hugen79/NanoVNA-H/doc/clone.jpg

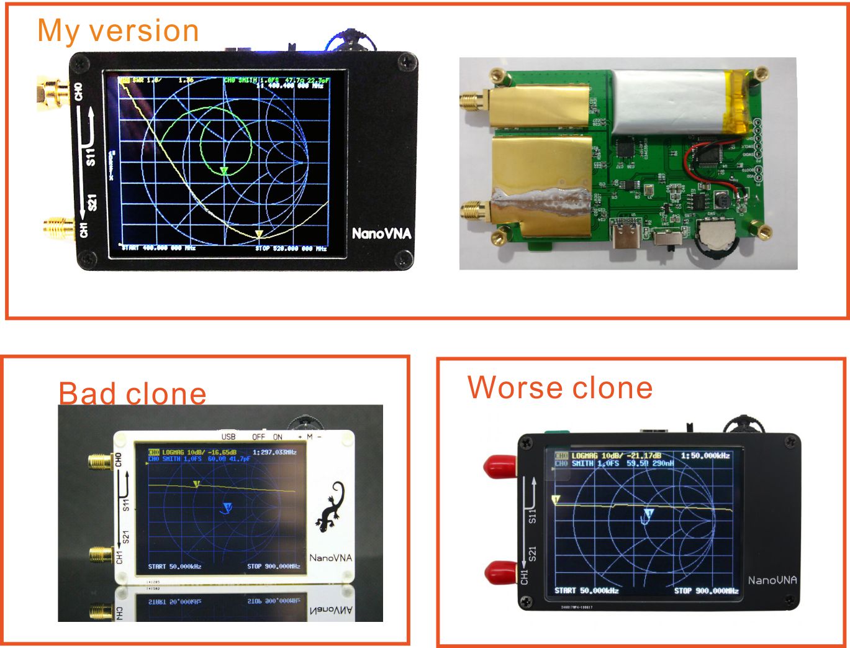
doc/clone.jpg
