hugen79/NanoVNA-H/doc/NanoVNA_Rev3.4_PCB.jpg

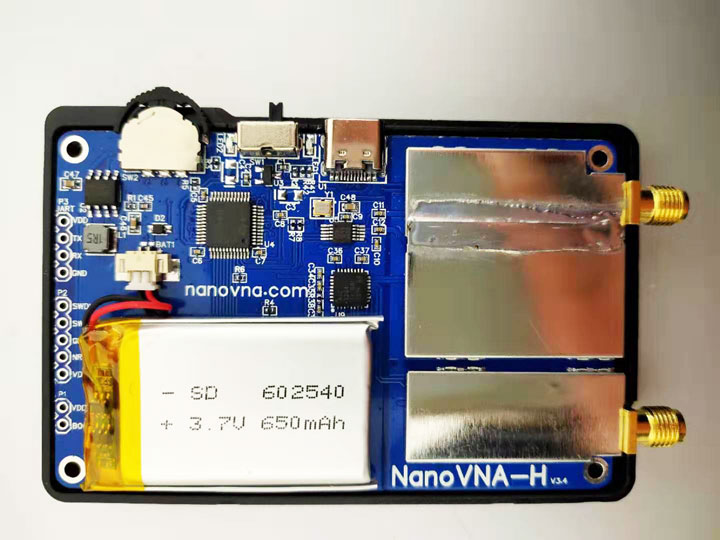
doc/NanoVNA_Rev3.4_PCB.jpg
