hugen79/NanoVNA-H/doc/Schematic_nanovna-H_REV3_4_1.png

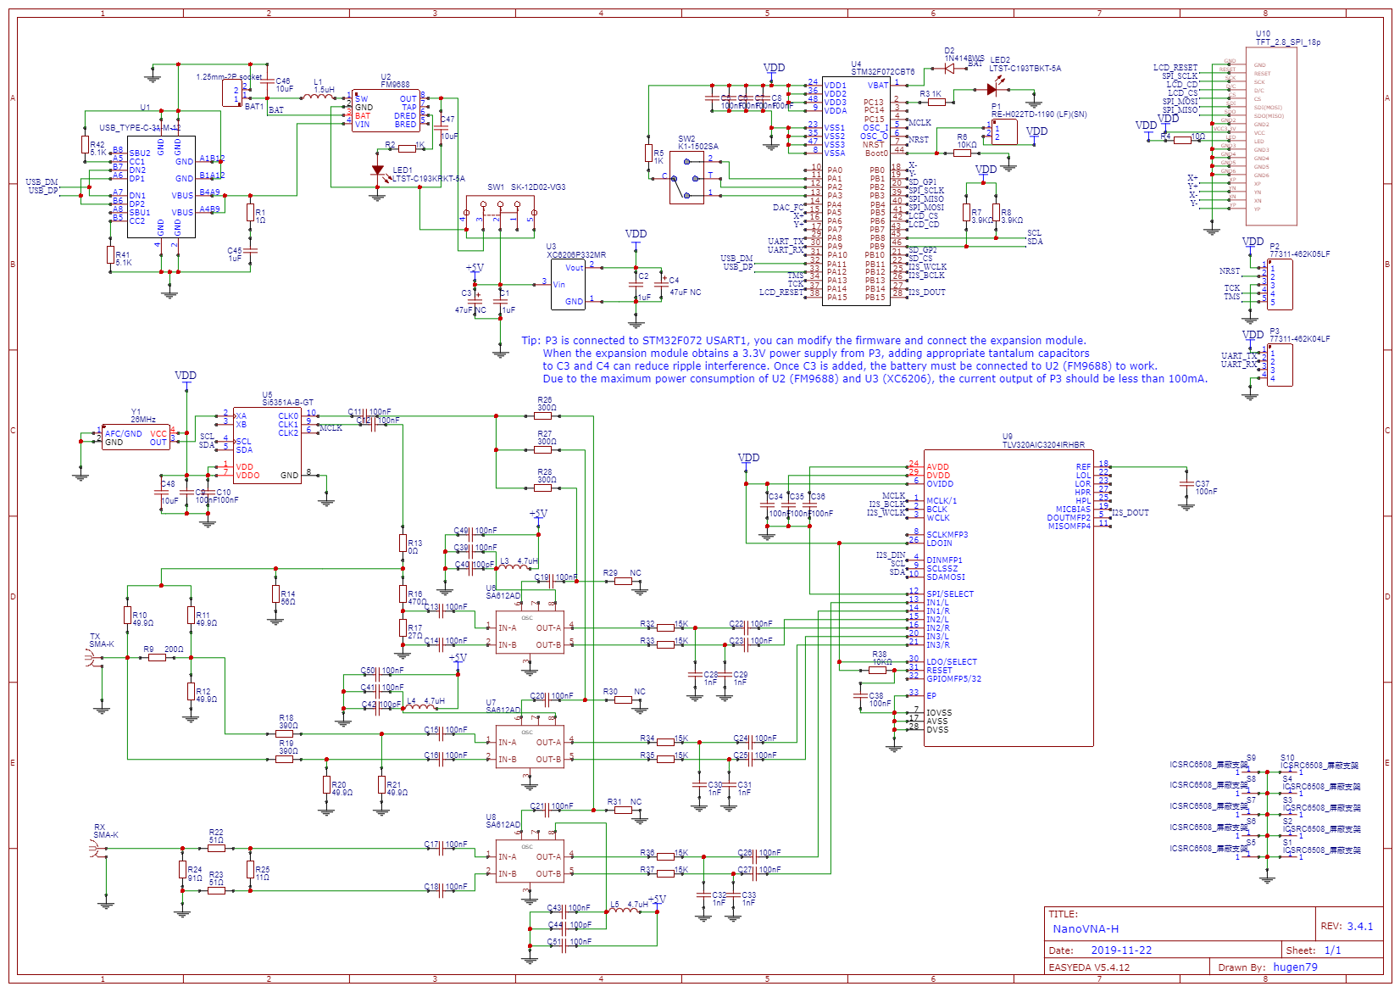
doc/Schematic_nanovna-H_REV3_4_1.png
