hugen79/NanoVNA-H/doc/Schematic_nanovna-H_Sheet-1_20190902.png

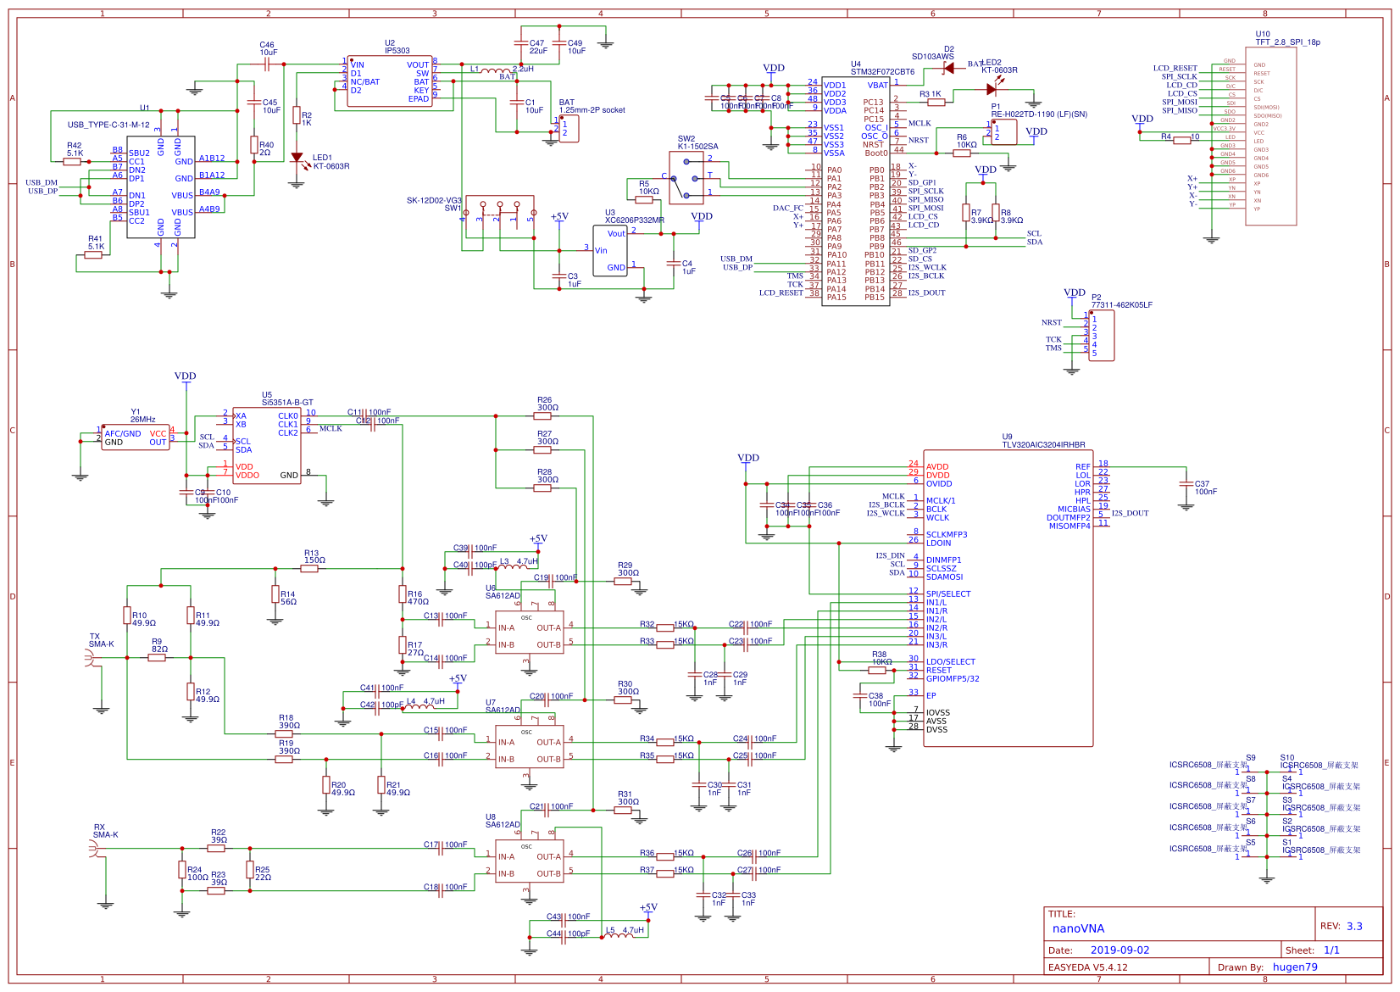
doc/Schematic_nanovna-H_Sheet-1_20190902.png
