hugen79/NanoVNA-H/(threads)

Thread 1 (2019-08-13):

Proposal: add suffix to your product name (eg. NanoVNA-H)

edy555, 2019-08-13:
Hi hugen,

I'm an original developer of NanoVNA.
When I knew that you made the clone of my project, I very surprised that you made PCB from schematics, and as an enthusiast, I felt pleased with your challenges such as frequency range expansion and your original pc software.

However, I was annoyed that you sell your clone without any prior notice to me. Though I had a plan to forge and sell my product, it becomes difficult.
Furthermore, your act cause that your design material was stolen by other clone makers, and quite many units were sold in aliex, ebay and also amazon. Those include worse clone as you say. This is a worrying state of affairs I think, and you might agree.

To distinguish any unexpected clones, I propose that you should change your product name by adding a suffix such as NanoVNA-H from your name, and it should be shown in the market and printed on your product.
And also I'd like to publish the name of qualified products, so customers become able to avoid worse clone.

I hope you think about this issue seriously.
Regards,

hugen79, 2019-08-16:
Dear Edy，

I am so glad to hear from you. First thanks for your approval and say sorry to make you annoyed.

At the beginging I made this NanoVNA just because I needed a portable device to measure filter and antenna. I tried to make PCB and achieved very satisfactory results. The performance of nanoVNA is very exciting, and your software is very excellent too. So I shared the production experience in 38hot. Some HAM contacted me to buy nanoVNA.  I made 50 sets of hardware for sale to HAM by hand all of the parts, and provided the schematic diagram and source code. After testing, they thought the nanoVNA was excellent and then I got more orders as I expected. At the same time, I found bad clones on eday. And their photos showed mixer problems on their machines. Apparently they didn't find the problems.  And some traders contacted me to buy NanoVNA for sale on eBay. I realized that it was no long a simple DIY and sharing.  It was being commercialized.  I tried to contact you through Twitter, but maybe because of my poor English expression, I didn't get a response. Soon, more and more clones appreared on the market. And seems someone cloned this NanoVNA misled ebay's sellers to promote their products. Things become out of my control as an enthusiast.

Maybe because I have stated your design concept every sites, maybe because I shared my experience and provide long term help as I can, or maybe because my products still have some advantages,  and thanks to the support of all HAMs, I can still get some more orders now.  And thank you most for not blaming me but giving me advice. I have added H in the name as NanoVNA-H and added a copyright declaration when open the VNA.  Hope your design will benefits more enthusiasts.

THANK YOU  & SORRY.

Sincerely,
Hugen

PS: Bec of my poor English, pls forgive me for my slowly response. I need sometime to translate and ask for help from my friends.

gabriel-tenma-white, 2019-09-29:
I'm pretty sure if you write Japanese hugen can understand it ;)

Closed 2019-09-29.

Thread 4 (2019-09-03):

Device is not recognized by host with Type-C to Type-C  cable.

cho45, 2019-09-03:
https://github.com/hugen79/NanoVNA-H/blob/master/doc/Schematic_nanovna_Sheet-1_20190711140429.jpg

Type-C CC1 seems unconnected to any pin. Does CC1 need to be connected to GND through a 5.1kΩ resistor?

hugen79, 2019-09-05:
Thank you for your feedback, I am aware of this error, the new version of the Schematic has fixed this issue.
https://github.com/hugen79/NanoVNA-H/blob/master/doc/Schematic_nanovna-H_Sheet-1_2019092.png

cho45, 2019-09-05:
Thank you fo repliyng! Great!

Closed 2019-09-05.

Thread 5 (2019-09-07):

Selector control acts flaky....

frohro, 2019-09-07:
I've read several reviews complaining about the same problem I have.  The issue is either that when you press one of the three selector switches, nothing happens.  I have to try over and over again.  It seems kind of like it depends on what the VNA is doing.  It is possible the selector hardware is flaky, but I suspect the software.  I'm kind of wondering if the software not monitoring the switch constantly.  Could it be made to trigger an interrupt, so button presses are not missed?

I haven't really looked into the source code yet, but it appears you made the change from touch screen to selector switch, so I thought I'd ask.  Any ideas?

Thanks,
Rob

frohro, 2019-09-09:
I polled some users on the groups.io list, and found another chap with two analyzers having the same issue, as well as this gentleman, whose blog review is [here](http://bobdavis321.blogspot.com/2019/08/nanovna-vector-network-analyzer-50khz.html).
It appears that the problem is that the switch is polled, not interrupt driven.  See ui.c, lines 121 and following.  Grepping the code yields interrupts for the ADC, and touch, but not the buttons.  There looks to be a pretty nice description of how to handle buttons with EXT I interrupts that fire when a button is pressed in ChibiOS with the STM32 [here](https://www.playembedded.org/blog/buttons-stm32/).

The interesting thing is the this polling is in eddy555's code as well, though he has no switch in his hardware.  I thought the switch was added so a non touch device could be used, but maybe not.

Thread 6 (2019-09-26):

tlv320aic3204 driver

qrp73, 2019-09-26:
Hi, I found there is a difference in the tlv320aic3204 driver in comparison with edy555 version:

Here is original edy555 code:
```
    I2CWrite(AIC3204_ADDR, 0x3b, 0); /* Unmute Left MICPGA, Gain selection of 32dB to make channel gain 0dB */
    I2CWrite(AIC3204_ADDR, 0x3c, 0); /* Unmute Right MICPGA, Gain selection of 32dB to make channel gain 0dB */
```

Here is your code:
```
    I2CWrite(AIC3204_ADDR, 0x3b, 5); /* Unmute Left MICPGA, Gain selection of 32dB to make channel gain 2.5dB */
    I2CWrite(AIC3204_ADDR, 0x3c, 5); /* Unmute Right MICPGA, Gain selection of 32dB to make channel gain 2.5dB */
```

Could you please explain what is the reason for this?
Thanks

hugen79, 2019-09-26:
This reduces some of the measurement range of positive gain, but results in better loss measurement dynamics.This is not necessarily suitable for all measurements, but it can be a little helpful for loss measurements.

hugen79, 2019-09-26:
This reduces some of the measurement range of positive gain, but results in better loss measurement dynamics.This is not necessarily suitable for all measurements, but it can be a little helpful for loss measurements.

Closed 2019-11-28.

Thread 7 (2019-10-03):

Bootup hangs after touchscreen calibration

nlroth, 2019-10-03:
After flashing ALL_FF to clear memory and then flashing NanoVNA-H__900_aa_20191003.dfu the device will boot every time with no issue.

I then calibrate touchscreen - not issues while device stays on.
If device is turned-off, device hangs at bootup every time only showing version screen.

Re-flashed hugen_900_(1500)_ch_sept-24-19.dfu - no issues with lockup.
Re-flashed NanoVNA-H__900_ch_20191003.dfu version - no problem.

Both 800 & 900 AA versions have same issue **BUT** 800 version boots up showing TDR time at bottom of display and produces unrecognized USB error on PC - DFU mode works though.

hugen79, 2019-10-09:
Thanks for the feedback, the bug has been corrected, please try the new version.

Closed 2019-10-09.

Thread 8 (2019-10-03):

Display update leaves larger font artifact in 'AA' version

nlroth, 2019-10-03:
(**Not a big issue**)
The CAL font (C0) at left side of display is not completely erased - old smaller font routine doesn't remove larger font completely.
Also, larger font extends beyond button slightly at right side for **Correction** and **Touch_test** menu buttons.
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

hugen79, 2019-10-09:
Thanks for the feedback, the bug has been corrected, please try the new version.

Closed 2019-10-09.

Thread 9 (2019-10-22):

Enhancement:  Shift AA FW vers freq fields to the left slightly

nlroth, 2019-10-22:
With reference to the AA version of the firmware, is it possible to shift the STOP and marker freq fields to the left enough to show the 0.1 KHz digit?

The change should not really interfere with the rest of the displayed info and it would allow more accurate 12.5KHz measurements at HF and VHF with the current ref xtal.

Thanks.

hugen79, 2019-11-16:
The marker freq may overlap with the marker data, especially when displaying smith data.

Thread 10 (2019-10-30):

Please share schematic V3.1

qrp73, 2019-10-30:
Could you please share schematic for PCB rev V3.1?
The schematic in the doc folder is V3.3, but my NanoVNA-H has PCB V3.1.
Thanks

hugen79, 2019-11-12:
Sorry, I have only checked the information about GitHub today because of the troublesome work I have recently. The schematics of V3.1 and V3.3 are the same, only R41 and R42 are missing. I am preparing to update the PCB to V3.4. If you wish, you can send your address to my email at hugen@outlook.com and I will send you the modified PCB. Thank you!

Closed 2019-11-28.

Thread 11 (2019-11-05):

Cross compiling on a Raspberry Pi...

dl9sec, 2019-11-05:
Hi,

i tried to cross compile the stuff on a Raspberry Pi 3. The toolchain mentioned at "Prepare ARM Cross Tools" can not be used on a RasPi.
But i found a precompiled toolchain for the Raspberry Pi at https://github.com/vanbwodonk/gcc-arm-embedded-build-armhf. This toolchain is more recent (8-2019-q3-update).
Differing from the description there, i used the following lines to install the toolchain:

wget https://github.com/vanbwodonk/gcc-arm-embedded-build-armhf/raw/master/pkg/gcc-arm-none-eabi-8-2019-q3-update-linux-armv7l.tar.bz2
tar -xvf gcc-arm-none-eabi-8-2019-q3-update-linux-armv7l.tar.bz2
sudo cp -r gcc-arm-none-eabi-8-2019-q3-update/* /usr/local/
sudo rm -r gcc-arm-none-eabi-8-2019-q3-update

Additionally i added the following line at the end of ~/.profile:

PATH=/usr/local/usr/local/arm-none-eabi/bin:$PATH

My first attempt fails to get the toolchain work on my Raspbian Stretch (Debian 9) because the toolchain needs glibc 2.28, but Stretch uses 2.24.
So Raspbian Stretch must be updated to Buster (see https://pimylifeup.com/upgrade-raspbian-stretch-to-raspbian-buster/) to get the toolchain work.

After upgrading Raspbian make runs well and the binary was built.

Hope this helps if someone want to cross compile on a RasPi...

Regards, Thorsten

JulyJim, 2019-11-19:
I have successfully run the current version "remotely " on Raspberry 3B, using Terminal Communication Framework (TCF)  plug-in on Eclipse.
I have used unmodified Makefile and no other complier / linker modification.

Since this seems to be ONLY place where developers gather I would like to ask here.If it is OK.

I like to add ability to output debugging messages to standard i/o console.
I do not have NanoVNA hardware and do not intend to actually run the software on it anyway.
 I just want to be able to trace / debug using prinff or cout.

**I should  be able to add required code to Makefile, but I am not sure how,**

I'll look into TCF debugging abilities for now.

JulyJim, 2019-11-20:
I am really reluctant to post this here.
I am finding out that there is NO forum / group dedicated to NanoVNA SOFTWARE development.
The "development" is scattered on each individual "enterpriser"    using whatever format / forum - if any.

I am of an opinion that nobody is really interested in NanoVNA as a common project.
Even this one is focused on fixing issues, which is fine.
What is really puzzling - the purpose of git(hub) is to share code.

How can I share code if I cannot physically test it ?
I have not found a way to run perfectly working NanoVNA code in debug mode.
I'll keep trying.

Thread 13 (2019-11-06):

Jog L & R switches appear to stop working after touchscreen menu use

nlroth, 2019-11-06:
I have found a problem with your Oct 9 4-trace release, where I use only the touchscreen and I select CONFIG and then the VERSION menu items and go back up the menu tree to select something else, then back to the version menu and then clear the menu from the screen.
Now, if I try to use the jog switch, I get the menu appear with ENTER but I can no longer get any menu items to highlight.
It appears the switches are being sensed because if I press Enter to bring up the root menu and then press the Right key 7 times, the menu disappears - but nothing was highlighted.
I tried the same menu sequence on QRP's 0.4.3 release and it is OK.
Thanks.
Larry

hugen79, 2019-11-12:
Let me test it first and it will be improved later.

nlroth, 2019-11-15:
The jog switches appear to have no issue with your latest release. The problem may have been due to an overflow somewhere. You can close

hugen79, 2019-11-17:
> The jog switches appear to have no issue with your latest release. The problem may have been due to an overflow somewhere. You can close

Trying to replace r5 with a 1k ohm resistor should improve.
hugen

Closed 2019-11-15.

Thread 14 (2019-11-11):

Noise improvements.

Pmax65, 2019-11-11:
I improved the noise adding few caps to the Silicon Labs clock generator chip and now the standalone instrument is fully working up to 1.5GHz with only a very little residual noise above 1.4GHz that it is appreciable in the Smith chart only.
I still have some issue with the PC communication because of the battery charger that disturbs the clock. I already thought a solution for this too, but I'm waiting for the sot23 P-MOSfet, to check if it works as thought. Once I fixed it I'll publish the "how to" of the whole hardware fixing.
In the meantime I have a couple of desiderata to your code.
1) the flashing LED 2 is very noisy and useless. It's much better to keep it off, if your intention was to give a pace indicator, I suggest you to implement it as a virtual indicator somewhere on the LCD screen (I currently removed its limiting resistor to keep it off).
2) Since there is still a little noise above 1.4GHz, It would be great if the calibration was done not by one acquisition of the raw data per calibration step as it is now. It should be better if you get more scans of the raw data and average them to get the correction coefficients averaged on more scans (say 10 scans, for example). This will take a little more time during the single calibration steps, but it  should warrant that the noise is corrected on its averaged value and not randomly on the instantaneous values acquired during the single scan.
Have a great day.
Massimo

qrp73, 2019-11-11:
regarding to LED 2, NanoVNA-Q disable it during sweep cycle to avoid noise: https://github.com/qrp73/NanoVNA-Q/releases

so, there is no need to desolder something. You can just change firmware.

Pmax65, 2019-11-11:
Not really so.
The clock generator's inner PLLs are always locked also during the non scanning time.
So the perturbation on the integrators of those PLLs still deteriorate their output phase noise during the scan time.

BTW, even if I seen that in the latest versions the LED 2 is apparently off during the scan, using a DSO on the limiting resistor pad, I always see some voltage spikes of few ms in duration there.

For these reasons I removed that resistor and the noise above 900MHz dropped a lot, despite I already downloaded the latest version of  NanoVNA-Q.

My current mods consist on:
1) added one 4.7F X7R capacitor in parallel to C9 and one other on C10
2) added one 68uF/6.3 tantalum capacitor in parallel to C9 and the 4.7uF already in parallel as above
3) added one 68uF/6.3 tantalum capacitor soldered on U3 input pin and grounded to the ground plane near Y1
4) removed R3

Doing the above, after a correct calibration, I get a Smith chart plot with just a little noisy plot of 2/3mm above 1.3GHz, making the instrument well usable in the HAM radio 23 cm band for antennas and filters checkings.
The SWR plot at 1.5GHz with the calibrated dummy load on the CH0 port shows 1:1.1 max 1:1.2 spikes, but below 1.3GHz is flat to 1:1
The return loss with the reference load used for the calibration, at 1.5GHz is better than -25dB on any board I checked, not that bad indeed
I did the test on 6 boards of three different versions, two having the ground clips and one having the nanoVNA-H board. And the results are almost the same.
Attaching the USB port, I still have noise above 900MHz, but I already checked that it is due to the battery charging. Detaching the battery positive wire and powering the VNA by the USB only, after a new calibration, the results are the same for the stand-alone running reported above.
For this reason I planned to put a P-MOSfet in series to the battery to detach the battery from the circuitry when the instrument is turned on and the power come from the USB port.
This way the battery charging will be still allowed when the instrument is turned off, but it's thought to remove that noise during the instrument is powered on. I just to check it when the MOSfets will be delivered.

Have a great day.

Massimo

qrp73, 2019-11-11:
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

No, it performs PLL reset at the beginning of sweep. So, any voltage fluctuations outside sweep time doesn't matter.

NanoVNA-Q has 10 ms stabilization delay after LED off, before it starts sweep.

Pmax65, 2019-11-11:
At this point I don't really know why I seen that sensible improvement after having removed R3.

Anyways, I'm sure that I also seen some glitches during the sweep. Let me return to home because now I'm in office and I can't check it one more time until I'll be back to home.

qrp73, 2019-11-11:
You're seen it, because used firmware which uses LED blinking during sweep. NanoVNA-Q firmware disable LED during sweep and don't blink until the end of sweep.

Pmax65, 2019-11-11:
No, I'm not sure that I seen it with V0.4.3 indeed, but I'm sure that I seen it with your V 0.4.2, and (if I'm not wrong) that function should have been already done.

One doubt:
what is your noise above 1.3GHz without any additional caps on the 5V & 3.3V power lines?
My doubt is that having increased the capacitance on the 3.3V U3 output, that could have introduced some sort of instability at the voltage regulator output after current pulses on it's input that lasts more than those 10ms.
I must check resoldering R3.
I'll tell you this night.

Pmax65, 2019-11-11:
Hi qrp73.
yes you are right and I was wrong I didn't realized that when the LED2 is on, there is  a PWM signal on it and having the horizontal scale of the DSO on 1ms/div I probably confused the ON state with OFF state of the LED2 when the PWM was there.
Here below you can see the 1.3GHz and 1.5GHz with the LED blinking.
(please note that I had to detach the battery + wire to get these plots from the nanoVNA Saver, because I still haven't received the MOSfets).
What do you think about the 10 time averaging suggestion during calibration?
It could better correct the scan above those 1.3GHz.

Thank you for sharing your work about this nice device.

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

hugen79, 2019-11-12:
Noise problems introduced by USB connection I will use the new power chip in NanoVNA-H V3.4 to improve this problem. I will try to increase the capacitance of the si5351 to reduce noise. The problem of LED flicker noise can be improved by software. If you prefer, you can send your address to my email at hugen@outlook.com and I will send you the modified PCB. Thank you!

Pmax65, 2019-11-12:
hi hugen79,
first off all, thank you for considering this issue, and for sharing you work on the nanoVNA-H board.

Since I had 6 nanoVNA on the table (only one was mine, the others were owned by friends of my local radio-club, I'm not a collector :-) of course), I believe I missed to update one and probably I did the check on that one, because I well remember how the noise dropped down after having removed R3.
Anyways, considering how much the instrument is sensitive to the power supply noise I would keep that LED off since in my opinion is useless, but this is just an opinion of course.
About the USB connection I already ordered the MOSFETs and I hope they'll come here soon (Italian Postal Service permitting). I planned to detach the battery when the USB power is applied and the instrument is turned on, it should take just 3 components comprising the MOSFET, not that complicated indeed. I probably mount the components on a very small piece of prototyping board and solder it in place of the battery connector.

Anyways your nanoVNA-H 3.4 PCB is surely well accepted, I 'm curious to know how it is handled the new power chip.

By the way, do you know from where it cames the R40, C45 and C46 network configuration?
I admit that I know very little about the electrical layer USB specs, but do you know what's the usefulness of the 2ohm resistor in series to the second 10uF capacitance?

I'll send you a direct e-mail for the 3.4 PCB.

Have a great day.

Massimo

hugen79, 2019-11-12:
The specifications of r40, c45, and c46 are from the data sheet of Ip5303. The series r40 and c45 are used to ensure the loop stability of ip5303. However, when an external USB power supply is connected, the MOSFET inside the ip5303 turns on and uses an external USB power supply, causing external interference to enter the power supply. For the new PCB, I will use the FM9688, a power chip widely used in Bluetooth headset chargers in China. The chip charging circuit and DC-DC circuit work independently, and the external circuit is simple and easy to install on the nanoVNA PCB. on.

Pmax65, 2019-11-12:
Hi hugen79,
thank you for the explanation, I seen that in the datasheet it was there, but (at least in the English version) I didn't find any explanation for it.

>However, when an external USB power supply is connected, the MOSFET inside the ip5303 turns on
>and uses an external USB power supply, causing external interference to enter the power supply.
I'm not sure the noise come from the USB line, I suppose is something due to the pulsed current into the battery during the charging process, because if you remove the battery and leave the USB power alone the noise is no longer there. For this reason I thought to put a MOSFET based switch between the battery and the Ip5303.
About the FM9688: I haven't found the english datasheet. I'm no way able to read the Chinese ideograms :-(
Have a great day.
Massimo

qrp73, 2019-11-12:
> causing external interference to enter the power supply.

According to my tests, this is not external interference. You can apply very clean external power (with no noise), but anyway it will be noisy. Also it is not related with cable, because there is no noise when usb cable is connected, but external voltage is not supplied.

I think the root of cause may be the following:
- IP5303 generate noise
- external voltage leads to a little different power supply voltage and it leads to some change in behavior

hugen79, 2019-11-12:
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

The difference in voltage will cause the gain of the sa612 to differ, resulting in errors. Maybe a separate charge pump can further reduce the noise, and I will do some tests.

Pmax65, 2019-11-12:
I perfectly agree with qrp73 when he wrote:

> According to my tests, this is not external interference. You can apply very clean external power (with no noise), but anyway it will be noisy. Also it is not related with cable, because there is no noise when usb cable is connected, but external voltage is not supplied.

In my opinion the problem is in the charging current pulses coming from the USB supply that produces inevitable little voltage spikes on the battery, since the voltage of the battery influence the calibration, in my opinion it's clear that those spikes are the cause of the performance deterioration.

I don't know if FM9688 will fix the issue, for doing that it should have two different switching mode PSU inside: one step-up for driving the load and one step-down for charging the battery; they should have very different PWM frequency to allow the step-up to be more reactive to the battery voltage changing caused by the lower frequency step-down charger.
In the datasheet, I see the schematic of the FM9688  and I don't see other than one inductor in that design, this lead me to think that it should not be much better than the Ip5303 under this context, but I could be wrong, of course.

Have a great day.

Massimo

hugen79, 2019-11-12:
I tried to replace the XC6206 with an ultra-low noise LDO RT9193, and I found that the noise has dropped. I will make a PCB test.
hugen

Pmax65, 2019-11-12:
> I tried to replace the XC6206 with an ultra-low noise LDO RT9193, and I found that the noise has dropped. I will make a PCB test.
Nice one. If it's confirmed the "thorn in the side" of the instrument is the clock generator, since the mixers are not powered from the 3.3V regulator.

hugen79, 2019-11-13:
> > I tried to replace the XC6206 with an ultra-low noise LDO RT9193, and I found that the noise has dropped. I will make a PCB test.
>
> Nice one. If it's confirmed the "thorn in the side" of the instrument is the clock generator, since the mixers are not powered from the 3.3V regulator.

Sorry, I made a mistake. Due to my wrong connection to the RT9193 pin, the actual output voltage of the LDO rises to 3.6V, and the performance improvement is due to the voltage rise. But this gave me a new idea to improve performance, I am making new attempts.

d51r3verse, 2019-11-13:
https://github.com/qrp73/NanoVNA-Q/issues/13#issuecomment-552679259
Mine(Green PCB) was around 6.5 MHz

hugen79, 2019-11-13:
> [qrp73/NanoVNA-Q#13 (comment)](https://github.com/qrp73/NanoVNA-Q/issues/13#issuecomment-552679259)
> Mine(Green PCB) was around 6.5 MHz

Thanks for your feedback, I will modify the schematic in v3.4.

Pmax65, 2019-11-13:
Hi hugen79,
> Sorry, I made a mistake. Due to my wrong connection to the RT9193 pin, the actual output voltage of the LDO rises to 3.6V, and the performance improvement is due to the voltage rise. But this gave me a new idea to improve performance, I am making new attempts.

Don't worry:
anyone who has never made a mistake has never tried anything new!
(Albert Einstein)

:-)

I would have here the mosfets and tell you if the patch works for the USB powering.
Anyways, as I have them here, I'll surely inform you about how the patch works.

For the 7.5/6.5Mhz peak issue:
I didn't noticed of it, but I must say that I have already added the 100nF on the mixer as per the NXP datasheet. Since I don't see anything there on any of the 3 different versions I have here, I can confirm you that it works fine.
I didn't reported that caps mod, just because I was convinced that they did nothing to the instrument, since I never looked to that narrow range before.
My compliment to Owen for having catched that issue. Here in Italy we say: "he catched the the needle in the haystack".

coralenka, 2019-11-13:
Hi
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

Pmax65, 2019-11-13:
Hi coralenka
Fantastic plots, how do you get them so noise-free up to 1.5GHz?

In the meantime, I just received the MOSFETs and checked the USB switcher and it works good, but above 1.3GHz as per the battery powered mode the noise is still there.

The mod consists of place on a small piece of proto-board (3 by 2 pads) an AO3401 P-channel MOSFET as follows:
DRAIN connected to the positive wire of the battery
SOURCE connected to the PCB positive battery pad
GATE connected to the ANODE of one 1N4148W diode and a 10kohm resistor (both on the little piece of proto-board).
The diode CATHODE is connected through a short wire to U3pin3, while the other pad of the 10kohm resistor is connected through a short wire to U2pin1.
Doing that circuitry, the battery charges only when the nanoVNA is not powered but the USB plug is connected to a current source.
When the nanoVNA is powered on, the battery is disconnected and the noise is as in the plots attached below.
Have a great day.

Massimo
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

coralenka, 2019-11-14:
HiI made no mod to my device yet

Trimis din Yahoo Mail pe Android

  Pe joi, nov. 14, 2019 la 0:45, Pmax65<notifications@github.com> a scris:
Hi coralenka
Fantastic plots, how do you get them so noise-free up to 1.5GHz?

In the meantime, I just received the MOSFETs and checked the USB switcher and it works good, but above 1.3GHz as per the battery powered mode the noise is still there.

The mod consists of place on a small piece of proto-board (3 by 2 pads) an AO3401 P-channel MOSFET as follows:
DRAIN connected to the positive wire of the battery
SOURCE connected to the PCB positive battery pad
GATE connected to the ANODE of one 1N4148W diode and a 10kohm resistor (both on the little piece of proto-board).
The diode CATHODE is connected through a short wire to U3pin3, while the other pad of the 10kohm resistor is connected through a short wire to U2pin1.
Doing that circuitry, the battery charges only when the nanoVNA is not powered but the USB plug is connected to a current source.
When the nanoVNA is powered on, the battery is disconnected and the noise is as in the plots attached below.
Have a great day.

Massimo

—
You are receiving this because you commented.
Reply to this email directly, view it on GitHub, or unsubscribe.

Pmax65, 2019-11-14:
> I made no mod to my device yet

Hi coralenka,
interesting.
Has your nanoVNA the battery installed?
I ask because when attached to the USB port, I experienced a great increase in noise bove 900MHz in all the 3 hardware versions I checked.
Your seems incredibly quiet even when attached to the PC.
Have a great day.
Massimo

coralenka, 2019-11-14:
Yes the battery is attached and at the same time the device is connected to the computer...I use the hardware version 0.4.0-273 de YO4AUL 

Trimis din Yahoo Mail pe Android

  Pe joi, nov. 14, 2019 la 15:14, Pmax65<notifications@github.com> a scris:

I made no mod to my device yet

Hi coralenka,
interesting.
Has your nanoVNA the battery installed?
I ask because when attached to the USB port, I experienced a great increase in noise bove 900MHz in all the 3 hardware versions I checked.
Your seems incredibly quiet even when attached to the PC.
Have a great day.
Massimo

—
You are receiving this because you commented.
Reply to this email directly, view it on GitHub, or unsubscribe.

Pmax65, 2019-11-14:
Hi coralenka,,
it's gorgeous.
Could you publish a photo of the nanoVNA?
Have a great day.
Massimo

coralenka, 2019-11-14:
This is my device

Trimis din Yahoo Mail pe Android

  Pe joi, nov. 14, 2019 la 20:12, Pmax65<notifications@github.com> a scris:
Hi coralenka,,
it's gorgeous.
Could you publish a photo of the nanoVNA?
Have a great day.
Massimo

—
You are receiving this because you commented.
Reply to this email directly, view it on GitHub, or unsubscribe.

Pmax65, 2019-11-14:
HI coralenka,
I'm not sure, did you send anything about how it looks your nanoVNA?
I can't see anything.

coralenka, 2019-11-15:
This is my device  

Trimis din Yahoo Mail pe Android

  Pe vin., nov. 15, 2019 la 1:02, Pmax65<notifications@github.com> a scris:
HI coralenka,
I'm not sure, did you send anything about how it looks your nanoVNA?
I can't see anything.

—
You are receiving this because you commented.
Reply to this email directly, view it on GitHub, or unsubscribe.

Pmax65, 2019-11-15:
It seems there is something wrong in the file handling because I can't see anything.
Could you send the photo to my e-mail?
My address is mporzio@teletu.it
I would like to know what HW it is, because I've some nanoVNAs from friends of my local radio club to modify and above 1.3GHz it seems really hard task to comply.
Thank you for considering my requests.
Have a nice day.
Massimo - IK1IZA

hugen79, 2019-11-15:
The new pcb seems to be better.
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

hugen79, 2019-11-15:
After the port is calibrated, the 20cm RG316 cable is measured, and it seems that 1.3GHz can work normally.
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

Pmax65, 2019-11-15:
Hi hugen79,
this is more or less what I got with the one I have at home and I think that it's a nice tool for HAM radio requirements.
How do you dealt with the USB charging noise?
Have a great day.

Massimo

Pmax65, 2019-11-16:
Hi hugen79,
maybe I've been not clear in my previous comment about your new pcb, I was referring to the noise of course.
About the accuracy and precision of the measurement, it seems that the older ones have a sort of resonance around 1180MHz that (despite the noise is quite low), it practically invalidate any useful Z measurement up there, but most of the HAM radio would use this instrument for antenna measurements which which have not such precision and accuracy requirements, so I guess it's good enough for them. In my case, who I own an HP8711A VNA (yes it was scalar, but some years ago I hacked it firmware to turn it into an HP8713A which is vectorial), I think this instrument is still a great deal for on field antenna or filters measurements.

You new PCB seems perform much better instead.
Have a great day.

Massimo

hugen79, 2019-11-16:
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

The pcb using the FM9688 seems to have a smaller usb noise, and a pcb with tantalum capacitors is being produced. I will test it further.、

hugen

Pmax65, 2019-11-16:
> The pcb using the FM9688 seems to have a smaller usb noise, and a pcb with tantalum capacitors is being produced. I will test it further.、

hugen

Nice one.

Pmax65, 2019-11-16:
HI coralenka,
I tried to reply to your email directly, but I received a deny alert from my mail server.
I was asking you a photo of the components side of your nanoVNA and (if possible, I don't want bore you) three photos of the instrument while it is measuring the open, short and load references.

Thank you for considering my requests.

Have a great day.

Massimo

d51r3verse, 2019-11-18:
Found another glitches around at CENTER 64 MHz / SPAN 80 MHz ( Not connected anything / Uncalibrated sweep )
Maybe influenced by 6.5 MHz issue?
But, this sweep does not glitches CH0 Delay.

hugen79, 2019-11-18:
> Found another glitches around at CENTER 64 MHz / SPAN 80 MHz ( Not connected anything / Uncalibrated sweep )
> Maybe influenced by 6.5 MHz issue?
> But, this sweep does not glitches CH0 Delay.

Is it appearing at 100MHz?

Pmax65, 2019-11-18:
Hi hugen79,
I finally gave a look to the reflectometric bridge section and found some weird things.
I refer to your schematic Rev. 3.0 which seems reflect the components mounted on the nanoVNAs I've here on my desk.
I can't understand the usefulness of R13. That resistor placed there almost completely invalidates the function of the reference mixer U6 because the changes at the input port of the bridge when the DUT has very different Z are practically no longer measured because of that.
I made R13 = 0ohm and now everything works great till 1500MHz.
Now, without that attenuation resistor, when an open reference is attached to the DUT port of the bridge, the U7 single ended input at pin IN-B exceeds the mixer 3rd order intercept point specs of -13dBm, but since that limit is determined by the conversion gain, it should not be a real issue since the differential input in that case is limited to -19dBm indeed.
I also changed R9 from 82ohm to 150ohm to better match the DUT port Z to 50ohm (it seems that the previous value didn't take account of the Si5351A-B-GT output impedance which is 85ohm).
I applied the mods only on one of the nanoVNAs that I've and not the measurements looks much better.
I also removed R29, R30 and R31 to give "a push" to the LO signal. I know that the SA612AD suggest to center the value between 200  and 300mVpp, but I suppose they do that to avoid spurious harmonics on the LO signal to drive the mixer, but we need that instead for the higher bands that use the odd harmonics method.
The attached images show the results with this configuration.
Note that the shield were not there because the nanoVNA arrived without it and I'm still waiting for the ground clips.
The mounted mixer are SA602A not SA612A, but that seems not critical.

Have a great day,

Massimo - IK1IZA

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

Pmax65, 2019-11-18:
After the mods described above, the corrective function of U6 now works, and it highlighted now a software issue at the band switch point of 300 and 900MHz. If the calibration has been made with a large span (for example at full 1.5GHz span) zooming around those points is evident that the calibration correction fails because interpolates between two point having very different correction coefficients (one below the band switch and one above it).
The right algorithm should extend the last calibrated point correction value below up to the band switch point, and should extend the first calibrated point correction value above down to the band switch point.
A much better algorithm should use the last two calibrated point correction values below and the first two calibrated points correction values above to compute the correction coefficients extending the linear interpolation between them to the two segments of data close to the band switch point that have no correction values computed (it should be an extension of the two interpolation lines).

Note that the glitch is already easily removed calibrating the instrument with the narrow span.

Have a great day.

Massimo IK1IZA

hugen79, 2019-11-19:
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

Thanks for your exploration, I conducted simulations and tests, and the results show that the new bridge is more reasonable. I will discuss the modification of the bridge with edy555. The discontinuity of the band switching point can be improved by modifying the codec's PGA.

hugen

qrp73, 2019-11-19:
> I can't understand the usefulness of R13.

R13 is needed to get 50 ohm output impedance on the port CH0. If you remove it, your CH0 output impedance will be changed and uncertainty of measurement will be increased.

Did you measured output impedace of port CH0? You can do it by measure output amplitude for different load resistance.

Pmax65, 2019-11-19:
> R13 is needed to get 50 ohm output impedance on the port CH0. If you remove it, your CH0 output impedance will be changed and uncertainty of measurement will be increased.

I simulated the front-end with Multisim 11 and now with R9 moved to 150ohm the device shows 50.3ohm at the DUT port of the bridge.
I also previously measured the CH0 Z with my HP8711A VNA and for that reason I decided to discuss the reliability of the front-end.
If U6 get the value there and not before R13, the bridge input impedance is not critical for the measurements.
The previous DUT impedance was set to 55ohm instead of the 49.6ohm probably expected. I suppose that probably the designer  did not accounted for the output impedance of the Si5351A-B-GT clock generator which is 85ohm not 0ohm (it's just a guess of course).
Now my HP8711A reported a dynamic CH0 Zin of 50.3ohm (the static impedance is higher of course but not pertinent to our context).
Now (up to 1.3GHz) the nanoVNA gave almost the same Smith plot of my HP8711A.
I can't measure the phase/amplitude above 1.3GHz using the HP8711A just because it stops at 1.3GHz, but I suspect that nanoVNA is not performing well up to 1.5GHz, because the ondulation of its return loss plot with the 30cm cable on CH0 port makes me think that there is a resonating element somewhere in the bridge circuitry that before this mod was at abt
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

Thread 16 (2019-11-18):

trace command hung

d51r3verse, 2019-11-18:
https://github.com/qrp73/NanoVNA-Q/issues/16
Same issue appeared latest(f6f948b) NanoVNA-H too.

I using empty `trace` command for identify current trace status and scale in my script.
But it will hung occasionally.
I found the only way to remove this issue, `trace x off` then `trace`. Similar issues on `marker` too.

Another issue I found was...
1. Set sweep range to full span 10e3 ~ 1.5e9 / calibrate off
2. `trace all off` -> `marker 1...4 off` -> `pause` (Blank screen / LED steady - For fast fetch)
3. Python loop `scan`&`data 0..1` -> Join&save s2p touchstone via scikit-rf
Exported every `data 0...1` and sp2 files was exactly same.

But data is different with `sweep`&`trace 0..1` enabled.( +4 ~ +20 dB point appeared at CH0 logmag )
NanoVNA requires at least one activated `trace`?

hugen79, 2019-11-18:
Do not use the "pause" command to pause the scan. You can use the "scan" command to pause the screen display and perform a single scan, then use the "data" command to get the data.

d51r3verse, 2019-11-18:
I issued single `pause` command at outside of the loop.
Inside the loop doing `scan` & `data 0...1`, Every iterated data array were different.

In device standalone mode( trace 0 logmag 0 enabled / live sweep ), CH0 logmag can not up to -21 dB.
But, I can see plus level of CH0 logmag when I turned all traces & markers( blank screen / manual scan via PC ).

Thread 17 (2019-11-18):

Just FYI C11 "problem" add -std=gnu11 to "makeflie" compiler options

JulyJim, 2019-11-18:
Current release, as of 11/18/2019,  has a same issue with C11 complier as NanoVNA did.
Instead of patching all problem occurrences - about 10 or so, I choose to follow "make" suggestion and added , cheap hack,

# Compiler options here.
# added -std=gnu11
ifeq ($(USE_OPT),)
  USE_OPT = -std=gnu11 -O2  -ggdb -fomit-frame-pointer -falign-functions=16 --specs=nano.specs -fstack-usage
endif

hugen79, 2019-12-03:
Thanks, I will modify it.

Closed 2021-12-11.

Thread 18 (2019-11-25):

SI5351 8mA out causes non-linearity in harmonics mode

erikkaashoek, 2019-11-25:
With 8mA the calibration looks perfect but when measuring a 25 ohm resistor there are some non-linearities. See this post
https://groups.io/g/nanovna-users/message/6595
Suggest to set 6mA maximum. (power 2)

Look for this post to see what performance is possible with your nanoVNA design (I bought from your shop)
https://groups.io/g/nanovna-users/message/6696
This was also done with power 2

hugen79, 2019-11-26:
Thank you erik, I couldn't reproduce what you said on my device and I will test it further. Increasing the output circuit of si5351 will reduce the impedance of ch0, which may reduce the measurement accuracy. The signal input to U6 is far beyond the Ip3 cut-off point of SA612A, which may cause some uncertain situations. I will continue testing.
hugen

erikkaashoek, 2019-11-26:
Hugen,

I redid my measurements. Calibrated with power 1. Then measured a 25 ohm resistor with powers 1,2 and 3 and there are subtle differences.
See these plots
http://athome.kaashoek.com/public/nanoVNA/power%201%2025%20ohm.PNG
http://athome.kaashoek.com/public/nanoVNA/power%202%2025%20ohm.PNG
http://athome.kaashoek.com/public/nanoVNA/power%203%2025%20ohm.PNG

The light blue line is R, it should stay at 25 ohm.
As you can see in the middle of the chart the impedance deviates more and more when the power increases.
its rotated back to eliminate the impact of the electrical length so it should stay at 25ohm. As the highest frequency is rotated to phase zero the electrical distance also changes
Its subtle but it is there and the measurement is best with power 1

erikkaashoek, 2019-11-26:
An even simpler way to see the non-linearities on my nanovna is to measure the uncalibrated SHORT
If the nanoVNA is lineair there should be no difference when measuring on power 1 or power 3 (except for the amount of noise) but there is difference (in my nanoVNA at least)

Pmax65, 2019-11-26:
Hi Erik,
I see the signals are very noisy in the that 500MHz...900MHz range.
Do you already have done the mods discussed in the link below?
https://github.com/hugen79/NanoVNA-H/issues/14

I use this board to to check the nanoVNA performances:
https://www.amazon.com/gp/product/B081391MJY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

After calibrating the nanoVNA with the on-board open, short and 50ohm load, the 33ohm and 75 ohm samples report respectively 33ohm +/-1ohm and 75ohm +/-2ohm.
On the Smith chart and the stimulus set in the range 10kHz-1.5GHz, the 33ohm is almost a perfect dot, while the 75ohm is a little line toward the capacitive area.

Currently, with those mods applied the only issue I see compared to my HP8711A are in the 900MHz-1.5GHz range with high impedance inductive loads where the the Smith chart reports a reduction of the impedance probably due to the input capacitance of the mixers.

Have a great day.

Massimo IK1IZA

erikkaashoek, 2019-11-26:
Did not modify my HW yet, too afraid I might destroy it.....
Most of the noise disappears when I run the nanoVNA from a clean 5 volt supply so I was not concerned about noise.

Pmax65, 2019-11-26:
Hi Erik,
It's not a question of the noise itself, that noise is there because the LO is underdriven at the harmonic range.
That's could be the reason of the non linearity of the measurement at the harmonic range.
Anyways removing R29, R30, R31, short-circuiting R13 and changing R9 to 200ohm the mixers are correctly driven and the reference input of the Weston bridge is monitored correctly for phase and amplitude.

Have a great day.

Massimo

erikkaashoek, 2019-11-26:
Will try to find some courage to do the modifications.

Pmax65, 2019-11-26:
Hi Erik,
if you never worked with 0402/0603 smt components take care of use a very small tip soldering iron and if you have any friend who already worked on them ask him to help you.
In case the nanoVNA start working crazy (such no longer scan or making very wrong measurements), don't worry to much for that. Most of cases you did a short-circuit on a component, just take a magnifier and search for that.
By the way, the power supply noise can be removed adding few capacitors as explained in that link above, and even the noise coming from the battery charging when the USB is attached to a charger or a PC can be removed using a mosfet, a resistor and a diode.

Have a great day.

Massimo

hugen79, 2019-11-27:
Hello erik, I found a similar phenomenon on the V3.3 version of the hardware. I will consider improving it. The test hardware of the V3.4 version performed well. You can refer to[ issues 14 ]
(https://github.com/hugen79/NanoVNA-H/issues/14)for modification. In addition, Maggie has contacted you and will send you v3.4 hardware next month.

v3.1 hardware test 25 ohm resistor
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

v3.3 hardware test 25 ohm resistor
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

v3.4 hardware test 25 ohm resistor
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

erikkaashoek, 2019-11-27:
Wow, Excellent improvement!!!!.  I will do experiments with the v3.4 above 1.5GHz because I want to measure some components above 2.0GHz
I have already first evidence it is possible to measure the S21 of a 2.0GHz cavity filter but my current nanoVNA HW (v3.1?) is unable to show the S11 as the bridge stops function above 1.2GHz, looks like the v3.4 is solving this problem.

erikkaashoek, 2019-11-27:
For evidence see this post
https://groups.io/g/nanovna-users/message/5149

qrp73, 2019-11-27:
what is the difference in v3.4? Is it possible to do that on v3.1?

hugen79, 2019-11-27:
> what is the difference in v3.4? Is it possible to do that on v3.1?

Hello qrp73, you can refer to [issues 14](https://github.com/hugen79/NanoVNA-H/issues/14) for some modifications, you can send your address to my email hugen@outlook.com, I will send you v3.4 PCB next month.
hugen

Pmax65, 2019-11-27:
hi Erik,

> I have already first evidence it is possible to measure the S21 of a 2.0GHz cavity filter but my current nanoVNA HW (v3.1?) is unable to show the S11 as the bridge stops function above 1.2GHz, looks like the v3.4 is solving this problem.

Wow, aren't you expecting too much from this device?
;-)
Those 10dB of S/N are not that useful for cavities tuning and I don't believe there is so much margins to get more from those "poor" SA612A mixers, we are already "raping them" :-)

Anyways, I already learnt that with this great device the motto "never say never" is a rule, and I'll look for any other enhancements about this your goal.

Massimo

Pmax65, 2019-11-27:
Hi Hugen.
once  you have ready the revision 3.4, I would like to buy one to test it.
Could I buy it directly from you?

Have a great day.

Massimo

hugen79, 2019-11-27:
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

Hello Pmax65, I already said in [issue 14](https://github.com/hugen79/NanoVNA-H/issues/14) that V3.4 hardware will be sent to you, so you don't need to repeat the purchase.

hugen

erikkaashoek, 2019-11-27:
In the evidence post you will see I got 45dB S/N in S21 at 2GHz with my v3.1 nanoVNA which is sufficient for the tuning.
For best results it is needed to have "some" S11 view.
See this post for what I tried previously with home build HW for a 2.5GHz cavity
https://erikkaashoek.blogspot.com/2019/02/tuning-25ghz-cavity-filter-with-home.html
seems the v3.4 is breaking the 1.2GHz limit for the SA612 bridge

Pmax65, 2019-11-27:
Hi Hugen,

> Hello Pmax65, I already said in issue 14 that V3.4 hardware will be sent to you, so you don't need to repeat the purchase.

Hoops, I missed that. I'm Italian and my English is not that good, I believed it was about the schematic only.
Thank you very much Hugen.

Massimo

Pmax65, 2019-11-27:
Hi Erik,

> In the evidence post you will see I got 45dB S/N in S21 at 2GHz with my v3.1 nanoVNA which is sufficient for the tuning.

I didn't see it before, but isn't  IAM-81008 a 5GHz double balanced mixer?
I think that SA612A is very less performing above 500MHz than the IAM-81008.
I was referring to this image from your post:
https://groups.io/g/nanovna-users/attachment/5149/0/2GHz%205V%20power%20amplifier.PNG
Anyways, you must know that when a friend from my HAM radio club proposed me to buy this device this summer, I was a little skeptic on the effectiveness up to the 900MHz, I really marveled to see what I got now up to 1500MHZ.

So, I'll wait for your news.

Have a great day

Massimo

erikkaashoek, 2019-11-27:
The image you refer to is from my v3.1 nanoVNA with some small firmware improvements measuring a 2GHz cavity filter, the measurement was made usable by using a 20dB amplifier AFTER the cavity filter and running the nanoVNA from a clean 5 volt supply. I understand the latter will no longer be needed with the v3.4 HW. And as noise also has been reduced considerably even the amplifier may no longer be needed.

Pmax65, 2019-11-28:
Hi Erik,
I can't warrant you that with rev. 3.4 the post-filter 20dB amplifier will no longer be needed. Since I never checked the modified nanoVNA at 2GHz but only up to 1.5GHz, I don't know the behaviour of the SA612A mixers up there.  Anyways, considering that the dynamic improvement at 1.5GHz for the CH1 port is in the range of 20/30dB depending on the pcb type, I think that it's possible that you can use the new release without that amplifier.

Have a great day.

Massimo

Thread 20 (2019-11-30):

CH1 port not pure 50 ohm

erikkaashoek, 2019-11-30:
The CH1 input impedance shows a substantial reactive part that hampers measuring certain components, mostly two port devices that are sensitive the the output impedance they see.
This is most obvious in the T-Check
Here you see the T-Check performed with only a coax, a Tee and an extra 50ohm resistor
http://athome.kaashoek.com/public/eevblog/NanoTeeCheck.JPG

When you put a 10dB attenuator at the input of CH1 and redo the full calibration and then do the T-Check you get this:
http://athome.kaashoek.com/public/nanoVNA/T-check.PNG
Much improved.
So having a well defined attenuator at the input of CH1 could give substantial improvements because it removes the reactive components of the impedance.

hugen79, 2019-12-02:
Thank you, erik. The input impedance of CH0 is not good. This issue edy555 has been discussed with me. It was also discussed in # 14. The previous circuit did not consider the impact of sa612's input impedance on the circuit. In addition, the line width from the resistance to the sma interface could not meet 50 ohms. I will try to improve it and it will be better in V3.4, but it is still not perfect.

hugen

erikkaashoek, 2019-12-02:
For very demanding measurements I calibrate S21 with a 10dB attenuator before CH1 input. That really helps but you get more noise of course. This is again solvable by adding a low noise 10dB amplifier between the attenuator and the CH1 input
Thanks for taking this into account!

erikkaashoek, 2019-12-02:
Are we talking about the same port? You refer to CH0. I'm talking about CH1

hugen79, 2019-12-02:
Sorry, the previous reply incorrectly, I said ch1.
hugen

hugen79, 2019-12-31:
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

Hi erik, I have re-simulated the impedance of the CH1 input and the attached test results are new. As the Chinese New Year is approaching, I cannot make a new PCB. I will update the modification and further test in the version after the Chinese New Year.

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

erikkaashoek, 2019-12-31:
That seems a substantial improvement! It will help a lot when measuring filters and impedance matching networks as filters can be very sensitive to the impedance connected to their output

PA3CCE, 2020-01-15:
I just ordered the NanoVNA-H4, the above means that the hardware probably is going to be updated again.
Is this change in components only or  in the PCB too, I'm afraid so.
Components I can change, I updated my 2.8" versions 3.2 and 3.3, to version 3.4 as far as possible. They improved and the display looks more or less like yours above, but more ondulated and the center of the smith chart is a small circle , changing the  PCB I can't !
If so I had better wait , now the H4 on his way !,
Jos

hugen79, 2020-01-19:
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

Hello Jos
Yes, I will accept the suggestions from the community to update NanoVNA-H. After the update, I will upload the schematic. You may need to change some resistors for better performance.

hugen

PA3CCE, 2020-01-22:
OK, thanks Hugen, in the mean time I received the NanoVNA-H4 , great device, it's loaded with Firmware dated 18//01/2020, here I do find this release only , but I know there is a H release dated  25/01/2020 is this one comparible with H4  or do I need H4 releaases only ?
Jos

PA3CCE, 2020-01-23:
Hugen
Sorry, I was wrong there is no 25/01/2029 release of the firmware, please neglect that.
I understand that in future there will be separate -H an -H4 releases, am I right ?
I hope that I can open the box of the H4 without damaging it, when a resistor change is needed !
Jos

PA3CCE, 2020-01-23:
another error please read 2020, Hi
Jos

hugen79, 2020-03-26:
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

Hello Jos, for nanoVNA-H4 we recommend that you update the firmware after 0.5.0, earlier versions can be problematic.

hugen

hugen79, 2020-03-26:
> That seems a substantial improvement! It will help a lot when measuring filters and impedance matching networks as filters can be very sensitive to the impedance connected to their output

I have uploaded a new schematic, and the impedance of ch1 is closer to pure 50 ohms.
https://github.com/hugen79/NanoVNA-H/blob/F303_ChibiOS_18/doc/Schematic_NanoVNA-H4_2_1.pdf

hugen

electrotoolshobby, 2020-05-18:
hi im new buy nanovna-h online i dont know if , -h product missmatching 50ohm resistance

with u'r last upload schematic have difrent between R34 TX , R49 thru R54 im need to change this to have beter matching sir ? after my vna come, thanks

hugen79, 2020-05-19:
> hi im new buy nanovna-h online i dont know if , -h product missmatching 50ohm resistance
>
> with u'r last upload schematic have difrent between R34 TX , R49 thru R54 im need to change this to have beter matching sir ? after my vna come, thanks

If you need to accurately measure the devices that are sensitive to the output load, you can refer to the latest circuit diagram modification.

Closed 2021-12-11.

Thread 21 (2019-12-01):

Memory indication in use

PY3IG, 2019-12-01:
When "save" is selected the memory in use is highlighted (after calibration for example).
Makes it easy to remember and save the calibrate in the correct memory.
Thanks for the work :)

hugen79, 2019-12-03:
Thank you, I will consider it.

Closed 2021-12-11.

Thread 23 (2020-01-15):

Predefined start/stop frequencies

mehale, 2020-01-15:
Please add an option to let the user define start/stop frequencies as memories.
This will be awesome for analyzing ham radio bands.

thanks for a great device!

hugen79, 2020-01-19:
You can use “Cal → SAVE” to save.

Closed 2020-01-19.

Thread 24 (2020-01-15):

Add option to unlock 1.5GHz till 2.1GHz range for those that know what they are doing

erikkaashoek, 2020-01-15:
As the performance of the v3.4 HW is so much better it makes sense to offer an option to unlock the 1.5GHz till 2.1GHz range.
The measurement  results above 1.5GHz have more noise but are usable.
I tested a 1.8GHz low pass filter and a 2GHz cavity filter. Both measured as they should but with some noise.
Could there be a menu option to unlock above 1.5GHz?

x893, 2020-06-12:
Hi,
can you help me with unlock (or link to how to) 1.5GHz ?
Thanks in advance

erikkaashoek, 2020-06-12:
The latest FW by DiSlord is unlocked. Look here: https://github.com/DiSlord/NanoVNA

x893, 2020-06-12:
Thanks, i will try.

x893, 2020-06-12:
DiSlord repo looks interesting but i can't found STM32F3 text,
I have NanoVNA-H4 (FW 0.5.0) with HW version 4.2.

Thread 25 (2020-01-22):

NanoVNA-H4 center frequency change above 1 GHz

hwalker6742, 2020-01-22:
hugen please see my review of the NanoVNA-H4 at https://groups.io/g/nanovna-users/message/10012 .  I encountered the lock-up when trying to set the center frequency in the 1 - 1.5 GHZ range.  Another member, https://groups.io/g/nanovna-users/message/10024 , also confirmed his NanoVNA-H4 locked up when setting the center frequency in the same range.

Multiple users have also encountered a QA problem, https://groups.io/g/nanovna-users/message/9914 , where the USB-C case opening is too small and the cable will not fit.  My unit was fine but a few members have had to enlarge the opening by hand.

- Herb

hwalker6742, 2020-01-23:
Additional feedback on the center frequency issue was provide in https://groups.io/g/nanovna-users/message/10088 .  Lock-up requiring power cycling occurred when setting center frequency above 1 GHz.  Lockup does not occur when setting start and stop frequencies.  Updating to the Jan 18, 2020 firmware did not resolve the issue.

- Herb

hugen79, 2020-01-24:
Thank you for your feedback, this is a serious problem, I haven't found the cause yet, I will look for the cause further.

hugen

Pmax65, 2020-01-24:
Hi Herb,

> Additional feedback on the center frequency issue was provide in https://groups.io/g/nanovna-users/message/10088 . Lock-up requiring power cycling occurred when setting center frequency above 1 GHz. Lockup does not occur when setting start and stop frequencies. Updating to the Jan 18, 2020 firmware did not resolve the issue.

I checked the HW3.4 and the H4 4.2 devices with the original FW and they work right.

I also tried "bad" settings like setting the center frequency to 1.5GHz and the device correctly switched to CW and after that I set the span to 200MHz and I got a correct 1.4GHz CF.
Anyways, I never had any lock-up.

Have you tried to clear the whole memory before downloading the update?

Massimo

BTW, Hugen I finally got the damned Eclipse IDE working on one PC but it is still not compiling on my home workshop main PC.
This is my first approach to the STM32 family indeed and I honestly never experienced a so complicated to setup tool in my professional experience (ok, it could be because I almost always used not free IDE with their own integrated compiler/debugger).
One curious behaviour is that even on the PC which performs the compiling task right, the real-time parser still report some undefined constants which remain undefined (just for the parser) despite they are well defined in the assembler list produced by the compiler.

hwalker6742, 2020-01-24:
Pmax,
I have not performed any updates (see attachment).  Two other users have provided feedback at groups.io of their NanoVNA-H4’s locking up when setting the center frequency above 1.5 GHz, so it is not just my unit.  So far you are the only person who has said they do not have this problem.  One user did update their NanoVNA-H4 but said that the center frequency lock up problem still remained.

One strange thing about my unit is that if I set the range for 10k – 1 GHz and select  center frequency. The default setting is 500 MHz as expected  (see attachment).  But if I set the range to 1 – 1.5 GHz and select center frequency.  The default setting is a negative number.

Setting the start and stop frequencies is fine.  It is only setting the center frequency that locks up the unit and requires cycling power.  The lock up also stops USB communications so I could not reset the unit via the CLI.

Windows10 x64, i7, 12GB
- Herb

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

Pmax65, 2020-01-25:
Hi Herb,
I apologize.
Since I was checking both the models, I believed to having performed that checks also on the H4 model. After you wrote the message above I decided to re-check the H4 (probably "check" instead of "recheck" indeed) and effectively there is the problem also after the last update.

Pmax65, 2020-02-02:
Hi Hugen,
despite I'm not able to avoid those errors from the Eclipse parser, I've been able to debug this issue.

There is a too small string buffer into the [ void draw_frequencies(void) ] function in Plot.c file
the string buffer buf() is only 24 characters long, while the code sequence:
        strcpy(buf, "CENTER ");
        frequency_string(buf+7, 24-7, fcenter);
        strcat(buf, "    ");
Writes these characters: 7 for the word CENTER + one space, 16 for the frequency in MHz when it's above or equal 1GHz and 4  for the ending spaces.

Summing them the buffer is filled with 27 characters + the \0 it occupies 28 bytes non 24 as reserved into the buffer definition.
Note that also all the other frequencies printing probably corrupt some memory location.

And more, it probably corrupt different memory from the 2.8" version, but this issue is present also there and it could be the reason that very sporadically I had some hangups of the instrument also in the 2.8" type.
Note that fixing this issue I never had the issues I reported here https://github.com/hugen79/NanoVNA-H/issues/27#issue-555908752
Maybe that this issue was the culprit of many sporadic bad behaviours of the two instruments.

I finally found one more issue:
there is a bug in computing the frequency when setting the center frequency with the span already set to 1.499GHz. If the center frequency is set with the sum of the center frequency + span/2 greater of 2.147GHz the computation fails and leaves the span as it was before. Anyways this is because a 32 bit signed integer can hold a maximum value of 2^31=2,147,483,648 and during the frequency0 and frequency1 computation, this limit it's overcome. You should adjust that function to avoid that.

Have a great day.

I look for your next update.

Massimo IK1IZA

Closed 2020-02-05.

Thread 27 (2020-01-28):

Touchscreen slowly responsive / unwanted menu popups

Pmax65, 2020-01-28:
Hi Hugen,
I experienced that while the nanoVNA touchscreen works great, the nanoVNA-H4 touchscreen is slow in detecting the touches, it needs to keep touching for at least half a second to get the touch detected.

I extended the delay between the driving ports setup and the adc differential input ports from 2 to 20ms and this issue has improved a lot now. Maybe this larger screen has an higher capacitance and need more time to stabilize its output to the right voltage.
The timings correction that I did are into the file "ui.c" function "static int touch_measure_x(void)" and function "static int touch_measure_y(void)" .

I also experienced sporadic unwanted menu popups and sometimes when that happens the sweep is suspended for some seconds, while in the meantime, the touchscreen is working anyways.
I suspect it's detecting some noise because of its wider area compared to the 2.8" touchscreen.

Could you publish the H4 schematic?
Possibly in graphic pdf format,
I tried to read the schematic in the doc directory, but opening that pdf file I can see only few components because of some missing fonts. The graphic pdf version should bypass that issue.

Have a great day.

Massimo

Pmax65, 2020-01-28:
Don't care of my pdf request in last message.
I discovered that loading that pdf through the browser, it converts it to the graphic version and now I can see it as a .png file.

Pmax65, 2020-02-03:
Hi Hugen,
I want to inform you that I finally discovered that this wasn't a firmware issue, but an hardware one.
My board had the LCD flat pcb badly fixed into the connector.
Evidently, sometimes the weston bridge worked wrong because of bad contacts.
For this, I close this issue

Closed 2020-02-03.

Thread 28 (2020-01-28):

Pressing right side of H4 causes random menu responses

hwalker6742, 2020-01-28:
I'm getting feedback from members at groups.io, and verified by myself, about the following issue:

   - If a menu is brought up and pressure is applied to the right side of the case, random menu choices occur.

A working solution has been proposed by one of the groups.io members at: https://groups.io/g/nanovna-users/message/10369 .

- Herb

hugen79, 2020-02-09:
I'm very sorry for this problem, and I will fix the plastic case as soon as the Chinese factory resumes normal work.

Closed 2021-12-11.

Thread 34 (2020-02-21):

NanoVNA-H4:  "scan" console cmd causes display to dim

hwalker6742, 2020-02-21:
Sending a scan console command (i.e. "scan 50000 30000000) to the NanoVNA-H4 causes the display to dim.  The display stays dim until a "resume" console command sent.  I'm pretty sure this interaction between the display and the scan command is unintentional.

This issue has been verified by other NanoVNA-H4 users at nanovna-users@groups.io.

- Herb

hugen79, 2020-02-26:
Yes, the display will be paused when using the scan command. At this time, it does not make sense to check the screen display trace. So I hope to reduce the screen brightness and save current consumption.

hugen

Closed 2020-02-26.

Thread 38 (2020-03-12):

Unexplained behaviour of calibration correction around high concentration of poles and zeros

Pmax65, 2020-03-12:
Hi Hugen.
I'm working about the odd harmonics loss of dynamic when a LPF filter let pass signal in the fundamental band below 300MHz and cuts in the odd harmonics bands above 300MHz.
I already designed a 5th order elliptic HP filter and modified one nanoVNA to clock the MPU and the DSP with a separate 8MHz oscillator as per your nanoVNA-H4 model, and used the CLK2 output of the Si5351A to drive the HP filter to get a cleaner signal with the fundamentals below the harmonics level when the DUT is checked above the 300MHz limit.
I modified the firmware to get the test signal that drives the DUT directly from CLK1 for frequencies below 300MHz and to get the test signal that drives the DUT from CLK2 passed through the filter for frequencies above.
Now the dynamic improved a lot making the device useful for duplexer testing/tuning.
Doing that I experienced an unexplained (for me) behavior of the calibration function of the S11 plot in the range between 150...350MHz.
Since for the moment I simply paralleled the filtered CLK2 output to CLK1 output, this last is influenced by the HP filter poles and zeros in that range (it's an elliptic filter and in the stop band it has abrupt changes in impedance there). I already planned to put an RF switch to remove this loading issue, but I would point out this issue anyways because it seems that the interpolated correction works bad.

**This is the uncorrected plot of that range:**
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
**While this is the plot of the same range when corrected by the interpolated calibration parameters:**
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
I did the 10kHz... 1.5GHz full span calibration and the marker in the plot are placed in the point of that full band calibration.
My question is:
how could the calibrated plot showing those almost parabolic interpolation between two consecutive calibration points?
I also can't explain why that red marker is so high, since this is a calibration point computed exactly with the very same dummy load used for the plot. Anyways, how could the S11 between two successive calibration points at lower RL have an higher RL?
This happens only when the DUT is well matched, in case of S11 close to 0dB this issue disappear little by little as the 0dB line is approached.

Do you have any idea about this?

Have a great day.

Massimo - IK1IZA

qrp73, 2020-03-13:
There is some "simplification" in si5351 frequency setup code, it leads to wrong frequency set at some frequency boundaries. Like 300 MHz, 600 MHz, etc. And your issue looks like that, but the errors are propagated due to multi-sweep in the NanoVNA-Saver.

It's hard to fix, because such fix requires complicated logic. But you can avoid it. Just don't use sweep through these frequency boundaries, if you can't, then setup a small frequency step, it will minimize amount of points with a wrong frequency.

DiSlord, 2020-03-13:
Its problem come from set si5351 power(in auto mode, power = -1), try set power 0 or 2 and calibrate on all diapasone, and check again.
Also need correct gain table

Pmax65, 2020-03-13:
Hi to both (qrp73 and DiSlord),
First of all, thank you for you race about this.
Maybe I've been not clear in last message, let me try to tell you what is happening in other words.
The two plot plots are the results of tests of the same DUT using the same nanoVNA, but while the first is with the correction disabled (not resetted) the second is with the correction enabled.
In few words, I can switch between them just using [CAL]>[CORRECTION].
Please keep in mind that the calibration was done from 10kHz to 1.5GHz so the real calibration points are placed with 15MHz spaces between them all the other points are the results of the interpolation of the 2 consecutive calibration points.
The 5th order elliptic high pass filter is connected as per the following schematic detail:
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
As you can see, while when the frequency is above 300MHz the signal exits from CLK2 passing through the filter and sees the load of CH1 which is almost a resistive load with a little parasitic capacitance, when the frequency is below 300MHz the signal exits from CLK1 and sees the filter output via FC3. The discontinuities seen in the top plot is due to the poles and zeros in that range of frequency (excluding the 300MHz discontinuity of course, which is due to the band change).
I can easily remove that discontinuity by an RF SPDT switch, but I can't imagine why the calibration algorithm introduces that artifacts  between the calibration points. Those almost parabolic correction shouldn't exist. Incredibly it seems that the correction works the other way it should work. In fact if I traced straight lines between those calibration points I have the real frequency response of the DUT S11 (except for the red calibration point which is completely wrong placed).
It seems to me that there could be a very bad bug in the calibration algorithm.

DiSlord, 2020-03-13:
Data on intepolation mode - use linear function see cal_interpolate(int s)
as write eddy https://github.com/ttrftech/NanoVNA/issues/73

DiSlord, 2020-03-16:
Problem come from here:
```
        // avoid glitch between freqs in different harmonics mode
        if (IS_HARMONIC_MODE(src->_frequencies[j]) != IS_HARMONIC_MODE(src->_frequencies[j+1])) {
          // assume f[j] < f[j+1]
          k1 = IS_HARMONIC_MODE(f) ? 1.0 : 0.0;
        }

        float k0 = 1.0 - k1;
        for (eterm = 0; eterm < 5; eterm++) {
          cal_data[eterm][i][0] = src->_cal_data[eterm][j][0] * k0 + src->_cal_data[eterm][j+1][0] * k1;
          cal_data[eterm][i][1] = src->_cal_data[eterm][j][1] * k0 + src->_cal_data[eterm][j+1][1] * k1;
        }
```
Linear interpolation in most cases work good, but then change calibration from one harmonic to other:
```
        // avoid glitch between freqs in different harmonics mode
        if (IS_HARMONIC_MODE(src->_frequencies[j]) != IS_HARMONIC_MODE(src->_frequencies[j+1])) {
          // assume f[j] < f[j+1]
          k1 = IS_HARMONIC_MODE(f) ? 1.0 : 0.0;
        }
```
Its non correct. Used last value from left or first from right (not do interpolation), need made extrapolate use 2 point before or 2 after
Also it not work on 900MHz (used IS_HARMONIC_MODE(f)), it only for 300, for 900 used point after

Pmax65, 2020-03-16:
Hi DisLord.
I already fixed this while I added the RF switch to the schematic.
I implemented a simple extrapolation algorithm computed on the two closest measured  calibration points, instead of the interpolation at the two edge of the band change point.
It works great at 300MHz, but the IS_HARMONIC _MODE macro is fails to detect the other band changes (the 900MHz) probably because it has been forgiven when the instrument has been extended above 900MHz.
This is my

Closed 2020-03-16.

Thread 39 (2020-03-16):

(Reopened) Unexplained behaviour of calibration correction around high concentration of poles and zeros

Pmax65, 2020-03-16:
This issue is intended to be appended to issue #38, that I closed for a mistake and I'm unable to reopen.

Hi DisLord.
I already fixed this while I added the RF switch to the schematic.
I implemented a simple extrapolation algorithm computed on the two closest measured  calibration points, instead of the interpolation at the two edge of the band change point.
It works great at 300MHz, but the IS_HARMONIC _MODE macro fails to detect the other band changes (the 900MHz) probably because it has been forgotten when the instrument has been extended above 900MHz.
Now I'm working and I'll fix it in the next days.

Anyways this is my the code for the moment that works  at 300MHz:

Place this in the define area for enabling this new interpolation/extrapolation algorithm:
`#define __NewBandChangeInterpolation__ 1`

Place this into static **void cal_interpolate(int s)**:
```

#if __NewBandChangeInterpolation__ == 1
          float k1 = (float)(f - src->_frequencies[j])
                          / (src->_frequencies[j+1] - src->_frequencies[j]);

          // avoid glitch between freqs in different harmonics mode
          if (IS_HARMONIC_MODE(src->_frequencies[j]) != IS_HARMONIC_MODE(src->_frequencies[j+1])) {
              int m;
        	  if (IS_HARMONIC_MODE(f)){
				  float k0 = 2 - k1;
				  k1 = k1 - 1;
				  for (eterm = 0; eterm < 5; eterm++) {
					cal_data[eterm][i][0] = src->_cal_data[eterm][j+1][0] * k0 + src->_cal_data[eterm][j+2][0] * k1;
					cal_data[eterm][i][1] = src->_cal_data[eterm][j+1][1] * k0 + src->_cal_data[eterm][j+2][1] * k1;
				  }
        	  }
        	  else{
				  float k0 = - k1;
				  k1 = k1 + 1;
				  if (j == 0){
					  m = j;
				  }
				  else{
					  m = j - 1;
				  }
				  for (eterm = 0; eterm < 5; eterm++) {
					cal_data[eterm][i][0] = src->_cal_data[eterm][m][0] * k0 + src->_cal_data[eterm][j][0] * k1;
					cal_data[eterm][i][1] = src->_cal_data[eterm][m][1] * k0 + src->_cal_data[eterm][j][1] * k1;
				  }
        	  }
          }
          else{
              float k0 = 1.0 - k1;
              for (eterm = 0; eterm < 5; eterm++) {
                cal_data[eterm][i][0] = src->_cal_data[eterm][j][0] * k0 + src->_cal_data[eterm][j+1][0] * k1;
                cal_data[eterm][i][1] = src->_cal_data[eterm][j][1] * k0 + src->_cal_data[eterm][j+1][1] * k1;
              }
          }

          break;

#else
          float k1 = (float)(f - src->_frequencies[j])
                          / (src->_frequencies[j+1] - src->_frequencies[j]);

          // avoid glitch between freqs in different harmonics mode
          if (IS_HARMONIC_MODE(src->_frequencies[j]) != IS_HARMONIC_MODE(src->_frequencies[j+1])) {
            // assume f[j] < f[j+1]
            k1 = IS_HARMONIC_MODE(f) ? 1.0 : 0.0;
          }

          float k0 = 1.0 - k1;
          for (eterm = 0; eterm < 5; eterm++) {
            cal_data[eterm][i][0] = src->_cal_data[eterm][j][0] * k0 + src->_cal_data[eterm][j+1][0] * k1;
            cal_data[eterm][i][1] = src->_cal_data[eterm][j][1] * k0 + src->_cal_data[eterm][j+1][1] * k1;
          }
          break;
#endif

```

instead of the current:

```
          float k1 = (float)(f - src->_frequencies[j])
                          / (src->_frequencies[j+1] - src->_frequencies[j]);

          // avoid glitch between freqs in different harmonics mode
          if (IS_HARMONIC_MODE(src->_frequencies[j]) != IS_HARMONIC_MODE(src->_frequencies[j+1])) {
            // assume f[j] < f[j+1]
            k1 = IS_HARMONIC_MODE(f) ? 1.0 : 0.0;
          }

          float k0 = 1.0 - k1;
          for (eterm = 0; eterm < 5; eterm++) {
            cal_data[eterm][i][0] = src->_cal_data[eterm][j][0] * k0 + src->_cal_data[eterm][j+1][0] * k1;
            cal_data[eterm][i][1] = src->_cal_data[eterm][j][1] * k0 + src->_cal_data[eterm][j+1][1] * k1;
          }
          break;

```
I don't know why, but I just realized that I have inadvertently close this issue.

Is there any way to reopen it?

Sorry

Massimo - IK1IZA

Pmax65, 2020-03-16:
Hi DisLord,
Ok,
to fix the glitches at the band change points do as follow.

Substitute the **IS_HARMONIC_MODE(f)** macro with the function
**int8_t IS_HARMONIC_MODE(uint32_t freq)** here below

```
int8_t IS_HARMONIC_MODE(uint32_t freq){
	if (freq > FREQ_HARMONICS * 5 ) {
		return 3;
	}
	else{
		if (freq > FREQ_HARMONICS * 3) {
			return 2;
		}
		else{
		  if (freq > FREQ_HARMONICS) {
			  return 1;
		  }
		  else{
			  return 0;
		  }
		}
	}
}
```
And change the code into  **static void cal_interpolate(int s)** this way:

```
#if __NewBandChangeInterpolation__ == 1
          float k1 = (float)(f - src->_frequencies[j])
                          / (src->_frequencies[j+1] - src->_frequencies[j]);

          // avoid glitch between freqs in different harmonics mode
          if (IS_HARMONIC_MODE(src->_frequencies[j]) != IS_HARMONIC_MODE(src->_frequencies[j+1])) {
              int m;
        	  if (IS_HARMONIC_MODE(f)==IS_HARMONIC_MODE(src->_frequencies[j+1])){
				  float k0 = 2 - k1;
				  k1 = k1 - 1;
				  for (eterm = 0; eterm < 5; eterm++) {
					cal_data[eterm][i][0] = src->_cal_data[eterm][j+1][0] * k0 + src->_cal_data[eterm][j+2][0] * k1;
					cal_data[eterm][i][1] = src->_cal_data[eterm][j+1][1] * k0 + src->_cal_data[eterm][j+2][1] * k1;
				  }
        	  }
        	  else{
				  float k0 = - k1;
				  k1 = k1 + 1;
				  if (j == 0){
					  m = j;
				  }
				  else{
					  m = j - 1;
				  }
				  for (eterm = 0; eterm < 5; eterm++) {
					cal_data[eterm][i][0] = src->_cal_data[eterm][m][0] * k0 + src->_cal_data[eterm][j][0] * k1;
					cal_data[eterm][i][1] = src->_cal_data[eterm][m][1] * k0 + src->_cal_data[eterm][j][1] * k1;
				  }
        	  }
          }
          else{
              float k0 = 1.0 - k1;
              for (eterm = 0; eterm < 5; eterm++) {
                cal_data[eterm][i][0] = src->_cal_data[eterm][j][0] * k0 + src->_cal_data[eterm][j+1][0] * k1;
                cal_data[eterm][i][1] = src->_cal_data[eterm][j][1] * k0 + src->_cal_data[eterm][j+1][1] * k1;
              }
          }

          break;

#else
          float k1 = (float)(f - src->_frequencies[j])
                          / (src->_frequencies[j+1] - src->_frequencies[j]);

          // avoid glitch between freqs in different harmonics mode
          if (IS_HARMONIC_MODE(src->_frequencies[j]) != IS_HARMONIC_MODE(src->_frequencies[j+1])) {
            // assume f[j] < f[j+1]
            k1 = IS_HARMONIC_MODE(f) ? 1.0 : 0.0;
          }

          float k0 = 1.0 - k1;
          for (eterm = 0; eterm < 5; eterm++) {
            cal_data[eterm][i][0] = src->_cal_data[eterm][j][0] * k0 + src->_cal_data[eterm][j+1][0] * k1;
            cal_data[eterm][i][1] = src->_cal_data[eterm][j][1] * k0 + src->_cal_data[eterm][j+1][1] * k1;
          }
          break;
#endif
```
Substantially the only line changed respect my previous message is this:
`if (IS_HARMONIC_MODE(f)){`

Which turned to:
`if (IS_HARMONIC_MODE(f)==IS_HARMONIC_MODE(src->_frequencies[j+1])){`

After that, the glitches at the band change points are fixed.

Have a great day,
Massimo - IK1IZA

Thread 40 (2020-03-22):

Hardware mods to get fixed the loss of dynamic of CH1 in the harmonics mode

Pmax65, 2020-03-22:
Hi Hugen,
here I publish my mods to almost completely fix the loss of dynamic above 300MHz when the DUT is a LPF tuned below but closed to 300MHz such as VHF/UHF duplexers.
The mods on my prototype still have a little loss of dynamic, but make the instrument useful.
Here are the  graph before and after the "cure".
**Before:**
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
**After:**
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

The red areas are the remaining dynamic losses.
Above 600MHz I never see any substantial dynamic loss.
The schematics are the followings.
**With added 8MHz oscillator for the MCU  & DSP:**
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
**With 2 RF switches:**
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
The two solutions are because it has been easier for me to use the inner output power amplifiers enable signal of the Si5351A instead to add an another RF switch (the size of nanoVNA have been a great constraint for fit the prototype PCBs there). This photo explains all:
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
Anyways, the single RF switch version gives the advantage of a stable clock to the MCU & DSP. This because the "arrhythmia" that I seen in the MCLK (that I was believing due to the noises around), it was instead due to the clock interruptions during the band switching. The only reason the system doesn't locks, it's that the inner PLLs of both the chips still produce a clock, even if on a very different frequency.
The contra of the single RF switch solution is that I had to modify the Si5351A settings to get the DUT test frequency from output 1 for frequencies below 300MHz and from output 2 for the frequencies above. This implies that the firmware is no longer compatible with the older hardware setup.
I used the scan LED2 signal (U4-2)  to drive the 5th order high pass elliptic filter, but my choice is due just because it was the easiest solution to get a sufficient wide pad to solder the switch(es) control wire in the nanoVNA PCB.
For the firmware development, the U4-2 signal must be set active at 3.3V for the odd harmonics mode and must be set deactive at 0V for the fundamental mode.

I also changed the  CH1 front-end configuration as follows:
	R22 = 68 ohm 0603 1% resistor
	R23 = 0ohm 0603 shunt
	R24 = 120ohm 0603 1% resistor
	R25 = 22ohm
Note that it has changed form differential to single ended, just because it was a nonsense. The driving signal of the SA612D mixer was in-phase on R25, so there was no advantages using that configuration. I found this configuration less noisy indeed and best matching the CH1 input port impedance for higher frequencies, that thanks to the higher value of R22 that is the one which influence more the capacitive behaviour of the CH1 input port trought the mixer input capacitance.

By the way, I found a strange stream of pulses on the LED2, which is produced by the macro PULSE into nanoVNA.h and used by function draw_cell() into plot.c.
I think it was some checking signal used during debug that I think it should be removed.

I thought to publish this mod procedure for those who desire to modify their current or the older versions of nanoVNA, but the complexity of it suggested me to avoid it. I had to use

Hope this will help you for your next production batch.

Have a great day.

Massimo

hugen79, 2020-03-26:
Hi Pmax65, thank you very much for your suggestion. This modification seems to be difficult to install 2.8 inch nanovna-H, but it can be very convenient to install NanoVNA-H4 with a larger PCB area. I will start my test.

hugen

hugen79, 2020-03-26:
For the impedance of CH1, it seems that it is affected by the parasitic capacitance on the PCB. After you change to single-ended, you reduce the length of the signal line and reduce the parasitic capacitance.  I modified it in nanoVNA-H 4 by reducing R24 and reducing the effect of parasitic capacitance of the circuit behind R22 and R23. In the next improvement I will try to increase the distance between the signal line and copper to reduce parasitic capacitance.
hugen

Pmax65, 2020-03-26:
Hi Hugen,
I don't agree with this:

> For the impedance of CH1, it seems that it is affected by the parasitic capacitance on the PCB. After you change to single-ended, you reduce the length of the signal line and reduce the parasitic capacitance.

Even if surely the parasitic capacitance of the PCB should matter above 1GHz, I did the mod placing a 0ohm resistor for R23, so the parasitic capacitance remained the same. What it changed is the greater pure resistive value of R22, which being in series to the input mixer capacitance reduced the influence of this input capacitance on the CH1 input.

So I believe that you should make that input single-ended not differential that has no advantage anyways.

Have a great day.
Massimo

Pmax65, 2020-03-26:
about:

> This modification seems to be difficult to install 2.8 inch nanovna-H, but it can be very convenient to install NanoVNA-H4 with a larger PCB area. I will start my test.

I agree, I don't know if moving U6 and its passive components forward the SMA border could free sufficient space for placing the filter and even one RF switch only.

hugen79, 2020-03-26:
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

Yes, single-ended allows an input pin to be directly grounded. The input capacitance of this pin is much larger than the parasitic capacitance. I will try your suggestion.
Also because the current ch0 output is as high as 0dBm, we have to add 35dB attenuation in ch1 to keep sa612a linear, perhaps we can use iAM81008 with a higher 1dB compression instead, but the IAM81008 output impedance is lower, I don't know how easy to connect to the codec with high input impedance, which requires further trying.

hugen

Pmax65, 2020-03-26:
I Hugen,
I didn't see any non linearity on the CH1, I used a 0-110dB 1dB/step attenuator and I honestly checked at 10dB/step and then I tried the first 10dB at 1dB without appreciable non-linearity.
I see a little non linearity at the end of the bands at around -30dBm return loss instead.
I don't see it below -40dBm (theoretical of course, just corrected by the calibration with that very same DUT)

I'm not sure you already read this:
https://github.com/hugen79/NanoVNA-H/issues/39#issuecomment-599795538

That's the way to fix the discontinuities at the band change due to wrong interpolation around those band change points. I implemented a very simple extrapolation algorithm that it works.

Have a great day.

Massimo

hugen79, 2020-03-26:
Hi Massimo, I'm very sorry, it may be that my bad English didn't express my meaning correctly. I mean, currently our resistance between the sma port of CH1 and the RF IN of the SA612A provides 35dB of attenuation. If IAM-81008 is used, the attenuation resistance can be reduced to 15dB or even 10dB, which may obtain better measurement dynamics.

hugen79, 2020-03-26:
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

Hi Massimo, I'm very sorry, it may be that my bad English didn't express my meaning correctly.
I mean, currently our resistance between the sma port of CH1 and the RF IN of the SA612A provides 35dB of attenuation. If IAM-81008 is used, the attenuation resistance can be reduced to 15dB or even 10dB, which may obtain better measurement dynamics.

hugen

Pmax65, 2020-03-26:
> Hi Massimo, I'm very sorry, it may be that my bad English didn't express my meaning correctly.
I mean, currently our resistance between the sma port of CH1 and the RF IN of the SA612A provides 35dB of attenuation. If IAM-81008 is used, the attenuation resistance can be reduced to 15dB or even 10dB, which may obtain better measurement dynamics.

I fully agree

Pmax65, 2020-06-01:
Hi Hugen,
since friends were interested in enhancing the dynamics above 300MHz when checking the low pass branch of a VHF/UHF duplexer, I finally designed a small 0.8mm thickness PCB for the filter mounting  on the 2.8 inches nanoVNA-H.
Here is a photo of the PCB.
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

While here is the PCB mounted on the nanoVNA board, as you can see it's a little less tricky to mount than the prototype.
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

This is the new schematic, which give much more dynamic than the previous 5th order high pass filter, and practically the current noise still in the 300...400MHz range is due to the background noise crosstalk between CH0 and CH1.
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

Here you can see the plots of the improvement. The red trace is the nanoVNA without any filter, while the green one is with the filter installed.
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

I also decided to redesign the filter as a 7th order elliptic filter to improve more the results and the plot
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

hugen79, 2020-06-02:
Hello Pmax65, it looks like your newly revised filter works very well.  But I don't quite understand the role of R1 you added. The 24 ohm resistor will increase the insertion loss by 2dB.

hugen

Pmax65, 2020-06-02:
Hi Huigen.
I placed that resistor to better match the filter output, and flatten the response in the 420-570MHz range which showed a 8dB flatness peak without it, anyways considering that the reference mixer picks the signal after it, it could be better to remove R1 indeed.
I'll give a try, maybe it could gain some dB of dynamic above 1GHz.

Thank you.

Massimo - IK1IZA

Pmax65, 2020-06-02:
Hi Hugen,
I checked it out and honestly I can't see any difference on the plots (up there those 2dB of dynamic improvement are probably hidden in the noise) and also the CH0 impedance is very little affected by that resistor.
So, apparently there is no reason to get that resistor there.
Have a great day.

Massimo

Pmax65, 2020-06-06:
Hi Hugen,
I think this is my very last try for this issue since now it looks really great.
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

I just changed the wire-wrap with the  SR-047 coax line because I noted a worsen of noise floor  above 1.2 GHz in the last version (it had reduced to about 45dB at around 1.3GHz)..
As you can see in the plot, other than returning the S21 dynamic of more than 50dB in the range 1-1.5GHz (not shown in the plot), thank to the coax lines the response improved a little more also in the 300-400MHz outperforming the HP8711A in that range now.
In my opinion this improvement demonstrates that in case you want to embed this filter in your next instrument you should take care of the microstriplines because above 1GHz their wrong Z0 could compromise the instrument response.

Have a great day.

Massimo

hugen79, 2020-06-09:
I modified the schematic and added a high-pass filter, which should be the method with the lowest cost and least current consumption to improve the performance of the UHF band.
But I am not sure if I will mass-produce the nanoVNA of the new circuit. Some users who need higher frequency applications are turning to SAA2. However, the traditional architecture of nanoVNA has faster speed and less current consumption. It should still have many hobbies need them.  I am also trying to add an independent signal source for the 300-900M measurement, so that up to 900MHz has always been used for fundamental wave measurement, effectively improving the dynamics.   If there is new progress, I will also release it in time.

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

Pmax65, 2020-06-09:
Hi Hugen,
it looks the you are doing great.
I agree with you that you must follow you business needs.
I just published the results to let you know that this way the dynamic is quiet good for this kind of instrument.

Have nice days.

Massimo

Pmax65, 2020-06-10:
Hi Hugen,
just to inform you about that.
I simulated your high pass filter setup and despite above 300MHz it is more flat than mine, it attenuates at least -40dB in the stop band while mine attenuates at least -70dB.
I can't warrant you about the result on the S21 dynamic.
I know that the switches have far less insulation between the ports, but they are two in series so that  -70dB @ 1.5GHz are realistic indeed.

Have a nice day.

Massimo

Thread 41 (2020-05-04):

Time Domain does not let me set the start/stop intervals

ewheelerinc, 2020-05-04:
Hello,

Thank you for maintaining the software of this great device!

We have been trying to test cable lengths to calculate velocity factor of an unknown cable. When we set the VNA to 50kHz--900MHz and set CH0 to real mode with a transform of low-pass impulse, I am unable to set the start and stop ranges to zoom into the first 20--50ns to see where the minima is for the reflection. If I set the stop frequency while the transform is turned on, the nanosecond range changes expectantly. If I set the stop frequency to 51kHz it sets the upper range to 65535ns, if I set it to 55kHz it sets it to 16087ns.

I tried this example a second time and got different numbers. The second time I did this the cursor position in the top-right corner shows "1:2147483647Gs 21474". This looks like the base-10 value of a 32-bit signed value of "-1" so maybe something in the code is returning an error that is not being handled. 65535 as noted above could be a similar issue since it is -1 in a 16-bit signed short.

I have seen this problem whether or not I calibrate the device and with and without load/short/open screw-caps on CH1 to mute any noise.

What I would really like to do is zoom into where the cursor is, so a zoom feature would be great. In the absence of the zoom feature, being able to set the time domain graph range in ns would be fine as well.

I am new to the VNA so if this is normal behavior and I am missing something then please let me know what I can do and if you need any more information.

ewheelerinc, 2020-05-07:
I may have been running old firmware.  I upgraded to v7.1 from edy555 and I've not seen the problem.  Not sure about the latest -H build, however.

Closed 2020-05-07.

Thread 42 (2020-06-01):

Reference impedance setting

goscickiw, 2020-06-01:
Sometimes I need to measure a 75 ohm system, but 75 ohms shows as 50 ohms on the graphs when I calibrate using a 75 ohm load. Would it be possible to add a setting for impedance in the software, so I can match it to the resistance I use when calibrating?

I understand that anything other than 50 ohms is most likely not optimal for the NanoVNA's hardware, and that it would be batter to use something like impedance converters, but right now I don't need anything too precise and I haven't encountered any big discrepancies when measuring in 75 ohm, other than the displayed values being 2/3 of the actual value.

There could also be a warning when changing the impedance value, that it could make the results less accurate.

hugen79, 2020-06-03:
In order to obtain good results, you need to modify the reflection bridge, then modify the software, and finally use a 75 ohm load for calibration.

goscickiw, 2020-06-03:
Yes, I know this, I mentioned that previously. If calibrating the whole system to 75 ohms is causing an issue that I haven't noticed yet, maybe the software impedance value could only affect the SWR (1:1 at 75 ohms) and Smith chart (center at 75 ohms) while the calibration is still to 50 ohms?

Also, how exactly would the reflection bridge have to be changed to accept both 50 and 75 ohm calibration?

Pmax65, 2020-06-03:
Hi goscickiw,
> Yes, I know this, I mentioned that previously. If calibrating the whole system to 75 ohms is causing an issue that I haven't noticed yet, maybe the software impedance value could only affect the SWR (1:1 at 75 ohms) and Smith chart (center at 75 ohms) while the calibration is still to 50 ohms?

No, is not only that, in case you don't apply a 50/75ohm adapter on CH0 during the calibration and the measurements, you get a flatness in the measurements that for the impedance offset could be up to 3.5dB in the return loss measures.
Note that there is no need to rebuild the whole Weston bridge to get a right measurements, it suffice a 50/75ohms minimum loss pad between the CH0 port and the DUT.

The only side effect is that the adapter reduces a little the dynamic of the measurements, but for RL shouldn't be a tragedy at all.

Have a nice day.

Massimo - IK1IZA

goscickiw, 2020-06-03:
Even with 50 ohm calibration and a converter, the 75 ohms (in system) will be displayed as 50 ohms (what the VNA sees at the converter), and 1:1 SWR and the center of the Smith chart will still be 50+0j ohms. I would like to be able to set 75 ohms as Z_0, only visually for proper values on the graphs.

So the 5.7 dB loss on the converter's resistors won't be a big issue? Currently I have some TP-75 transformers which have low loss but they only work properly up to 200 MHz, and I heard their inductive nature can affect the measurement.

Pmax65, 2020-06-03:
Hi goscickiw,
yes, if you place a minimum loss pad you get right measurements at cost of the reduced dynamic of the port. This is because it is a pure resistive (non-reactive) device in the useful range of frequency  for which it is designed, so the calibration can easily embed its behaviour.
In that case you need to change the SW for center the Smith chart at Z0=75ohm of course.
I never tried the Macom TP-75 transformers for this scope, but my guess is that its reactance along the frequency range could be not fully predicted and for that I suppose that the calibration shouldn't be effective in this case.
Please, take care that this last is just an opinion of mine, I never checked it out.

Massimo - IK1IZA

Pmax65, 2020-06-03:
By the way (this is just a provocation of course).
Hugen could design and sold cheap SMA male to BNC female minimum loss pads for the nanoVNA.

They are just one 43.3ohm resistor in series to BNC hot terminal and an 86.6ohm resistor in parallel to the SMA male connector   ;-)

Thread 43 (2020-06-07):

No way to save settings

Axel2, 2020-06-07:
Hi,

in release NanoVNA-H_AA_20200118.dfu there seems to be no way to SAVE the settings. There is only a button for recall.

Kind regards,
Axel

hugen79, 2020-06-07:
Please use the calibration save

Closed 2020-06-07.

Thread 46 (2020-07-27):

NanoVNA bricked after installing latest update

SheetLightning, 2020-07-27:
First time every updating the firmware on this. I checked I had the -H version and the firmware version message pointed me to this GitHub. Unfortunately my NanoVNA booted to a white screen after installing the latest update: NanoVNA-H4_20200221.bin

Mine is the -H version and I am updating from a PC running Linux Mint 19.2 so I used the instructions from here:

https://nt7s.com/2019/11/updating-the-nanovna-firmware/

Also here:

https://oristopo.github.io/nVhelp/

Used the following command line:

dfu-util -d 0483:df11 -a 0 -s 0x08000000:leave -D NanoVNA-H4_20200221.bin

My screen came up white and nothing else happened. I have tried bridging the link to get into DFU mode but the screen remained white.

After a bit of a panic moment I tried uploading the firmware again anyway and to my surprise it worked in the background - it was just that the display was not telling me the NanoVNA was in DFU mode. Uploading again got the a white screen again, so I tried the ch.dfu from edy55. This uploaded and worked OK, except my SWR readings were not right (yes I did calibrate).

After a bit of further digging, I noticed that in the previous version of your firmware (18th January) there is an version with an AA suffix - file NanoVNA-H_AA_20200118.bin. Since my unit originally had four traces I tried uploading this to the unit and it did work!  At least the unit is now working with the -H_AA firmware version 0.4.5-4-g96e7efe. I have yet to test the SWR readings, but could I request that the "AA" suffix be added to the version number in the version message to distinguish this firmware?

I am not sure why the latest _H version does not boot, but the previous -H_AA version works fine.

Hopefully when the AA version of the latest firmware is released I will be able to apply that to this unit, but in the meantime, thank you for your work on this firmware.

Pmax65, 2020-07-27:
Hi SheetLightning,
if your nanoVNA-H has a 2.8" display you must use the nanoVNA-H firmware not the nanoVNA-H4 one. The latest is for the 4" inch display version that uses the STM32F330 MCU instead of the STM32F072 installed in your device. for this reason you device is now locked.

Just download the right MCU firmware and you'll get back the device working.

By the way, since the device is hanged-up now, you must turn on the board while shortcutting the two P1 pins named Boot and VDD to start the DFU mode.

SheetLightning, 2020-07-29:
Thank you for your reply. That explains it. Looking at the releases the 18th Jan 2020 release is a -H release which is why going to the earlier release worked. The later 21st Feb 2020 release changed to -H4 but I had no idea of the reason for this change so thank you for the explanation. I managed to turn on DFU mode using the jumper on P1 as described. Thank you.

evgsm1979, 2020-10-18:
Доброго времени всем кто читает. Приобрёл NanoVNA-H v.3.4 и при первом включение получил белый экран. При втором включении прибор заработал, я подумал, что это что-то с прошивкой и перепрошил на более свежую. Но даже после этого периодически включался с белым экраном. Прошивал прошивками для H версии. Теперь прибор включается только с белым экраном. Светодиод работы мигает, но изображения нет, в режим DFU переключал закорачиванием контактов на плате. NanoVNA Saver c прибором работает, значит процессор целый. Может неисправна TLV320? Как заставить экран заработать?

Pmax65, 2020-10-19:
Hi evgsm1979,
it looks like there are some odds on the LCD connections.
Unluckily it is soldered on the other side and the LCD metallic back shield is glued to the pcb.
The only way to redo the soldering is to unlatch the shield clips as seen in this link:

https://1.bp.blogspot.com/-oQ5HUbjfH6o/XUhfoaIoAFI/AAAAAAAAEYM/R4ZhjcC1VxEfbgxrmp-qSZgWoxZG6AZsQCLcBGAs/s1600/NanoVna%2Btop%2Bguts.jpg

Check for the STM32F072 solderings too, especially for those by which the LCD is connected with.
I don't believe the TLV320 has something to do with this issue.

Have a nice day.

Massimo

evgsm1979, 2020-10-19:
Good afternoon, Massimo. Thank you for your very quick response. I soldered the screen again. Not help. I will solder STM32F072 again. But I noticed that the device freezes in front of the white screen. The device often freezes and then turns on a white screen. The device itself works with a PC and Android, only the screen is white. This is quite inconvenient, I need to set up antennas with it. Stitched also always good versions for n. Good day UB9YWB 73!!!

evgsm1979, 2020-10-19:
Or maybe it's just a defective screen, how can I check it to find out for sure?

evgsm1979, 2020-10-19:
https://drive.google.com/file/d/15P-SOFXcuvib-plJeht2BXfw019qVZhz/view?usp=sharing,%20https://drive.google.com/file/d/165TWeE2D9kyg9Uqo5cQSdkoxXqVeGtmi/view?usp=sharing,%20https://drive.google.com/file/d/16FaPWjqLuECJDb-6csWQGunYUNd_UoYC/view?usp=sharing,%20https://drive.google.com/file/d/16ObS7pwfoOdGVYnoRpnB5T74zdlBkzJY/view?usp=sharing

Pmax65, 2020-10-19:
Hi evgsm1979,
is the above the picture of your own LCD?
I don't know if the lower side of the LCD flexible pcb has a twin contact for any upper contact, but ground pin 8 looks broken in that picture.
Some LCDs have separated ground for the I/O controller, the LCD and the serial interface.
In case that it's your LCD, I'll tried to redo that pin8 connection.

Have a great day

Best 73 from Massimo - IK1IZA

evgsm1979, 2020-10-19:
Hello again. Photos of the display are mine. I took it off and re-soldered it. They call all the contacts everywhere. Also soldered STM and TLV320. There are no changes. The screen doesn't work, only the backlight is on. I'll attach a photo. What should I do next? Thank you for your answers.
https://drive.google.com/file/d/1k5z7e_XZYNlquH9XwBhgbrxOsQyBSUFM/view?usp=sharing

Pmax65, 2020-10-20:
Hi evgsm1979,
everything lead to a defective LCD, but since you said that "The second time the device was turned on", I guess that you meant that the LCD at least one time worked right, is it that?
In that case, if you were lucky, you could redo all the soldering of the components on the flexible pcb.
Between them, there are the serial interface timings capacitors, maybe that one bad soldering inhibits the serial interface to run correctly.

Just try it, and let me know.

In the meantime, have a great day.

Massimo - IK1IZA

evgsm1979, 2020-10-20:
Massimo good afternoon. Capacitors on a flexible loop soldered. It didn't help. Stood up with an oscilloscope on the display contacts and signals and go to it. So the display is probably faulty. Thank you for your assistance in Troubleshooting. You need to buy a suitable display on aliexpress, I live in the village and we do not have radio stores. Good Luck To You 73. UB9YWB.

Pmax65, 2020-10-20:
Hi evgsm1979,
sad to read that.

Those LCDs are COGs and sometimes the slight difference in expansion between the silicon chip and the glass may lead to connection disjuncture.

Here is a research about that issue.
https://www.jim.or.jp/journal/e/pdf3/52/11/2106.pdf

It looks like you had been unlucky.

Have grat days,
Massimo

evgsm1979, 2020-10-21:
Hi, Massimo. Well, then just bad luck with this instance. I will order a new one in China. Thank you for your help in solving the problem. Good luck in life and business, the topic is not closed yet, I will write the result on the screen. UB9YWB 73!

333,86 руб. | 3,5-дюймовый TFT ЖК-экран
https://a.aliexpress.com/_AX6C9l

Pmax65, 2020-10-21:
Hi evgsm1979,

luckily it looks pretty cheap, so you have just to wait for its arrival.
Let me know how it will work.

In the meantime have great days.

All the best from Italy.

Massimo - IK1IZA

evgsm1979, 2020-10-21:
Greetings from Siberia. You can wait until November 20. As soon as I install it, I will definitely write here. 73! UB9YWB.

evgsm1979, 2020-11-21:
Hi, Massimo. Got a screen with Aliexpress. Set and the instrument is earned. So it was the display. All the best, health, take care of yourself. 73!!! UB9YWB.

Pmax65, 2020-11-21:
Hi evgsm1979,
nice to read that you fully fixed the issue with little bucks and just some time to wait.
I hope you enjoy your nanoVNA.
Have great days.
I wish you all the best-

73 de IK1IZA

schumar, 2021-09-20:
Just in case someone found this report because they were searching for the "does not match device" error:
It helps to simply *not* specify `-d 0483:df11` when flashing, i.e. just do
```sh
dfu-util -a 0 -D NanoVNA-H_20210916.dfu
```

Thread 48 (2020-09-10):

Modifying frontend for 75 ohm Z0

goscickiw, 2020-09-10:
I have upgraded to SAA2 recently, but I still want to make use of my NanoVNA-H, and I thought of converting it to a 75 ohm VNA. I assume that the bridge resistors have to be replaced, but to what values? Do I have to replace any other parts?
Also, in the code I found several variables declared as `float z0 = 50;`. I assume that I'd have to change that to `float z0 = 75;` and compile the firmware? Would I have to change the code in any other way?

DiSlord, 2022-02-01:
Now you can use DISPLAY->Port-Z and set value.
Now NanoVNA recalculate measured impedance to this value

Thread 51 (2020-10-19):

White screen of NanoVNA-H 3.4

evgsm1979, 2020-10-19:
Good time to all who read. I purchased a NanoVNA-H V. 3.4 and got a white screen when I turned it on for the first time. The second time the device was turned on, I thought it was something with the firmware and flashed it to a more recent one. But even after that, it periodically turned on with a white screen. Flashed firmware for the H version. Now the device turns on only with a white screen. The operation led is blinking, but there is no image. I switched to DFU mode by shorting the contacts on the Board. NanoVNA Saver with the device works, so the processor is whole. Is the TLV320 faulty? How do I make the screen work?

Pmax65, 2020-10-19:
I just replied you here:
https://github.com/hugen79/NanoVNA-H/issues/46#issuecomment-711723428

slack-t, 2024-03-26:
If anyone runs into this error again. I yesterday encountered the same issue. Suddenly I got a white screen after switching the device on.
Before trying to replace the screen, I just reflashed the latest firmware using STM32CubeProgrammer. I bridged Boot0 and VDD, switched the device on, confirmed it's in bootloader mode using windows device manager and used the following settings:

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

restarted and now my nanovna works again!

Thread 52 (2021-01-31):

70cm SWR gives different value than previous versions

Bruiser419, 2021-01-31:
I updated the firmware of my NanoVNA-H to the recent version 1.0.45.  When I had checked the NanoVNA vs a dummy load on previous versions, I got ~1.4-1.5 SWR on 70 cm (440 to 450Mhz) and it was relatively flat across the entire range.

I updated the firmware and then ran clearconfig, and re-calibrated.

With the new firmware, the SWR at 440 is around 1.75 and climbs thru the range to over 2.

The 2m SWR measurement is unchanged at ~1.1.

Not sure what would cause this. I even went back to the previous version (0.4.5-4), ran clearconfig, re-calibrated, checked it, got similar answers to previous tests, installed the newest version again, clearconfig, re-calibrated, and again got the 1.7+ reading on 70cm.  I used the same coax for all 4 tests (I tested 2m again as well for completeness; it was unchanged) so I don't think it's my setup.

Any help is appreciated.  Thanks, Bruce

Bruiser419, 2021-02-01:
Nevermind.  I was not calibrating correctly.  The error was on me.  My apologies.

Bruiser419, 2021-02-01:
Nevermind, I was not calibrating correctly.  My mistake and apologies.

Closed 2021-02-01.

Thread 53 (2021-02-21):

PPM offset in config menu

Joel-Mckay, 2021-02-21:
Updated to: NanoVNA-H_20210130.dfu
10MHz hc49 xtal test reads as 9.997225MHz

Can we use a GPSDO 10MHz reference to add the ppm offset config into the nanoVNA-H menus?
Would seem kind of odd to have to have to flash a custom compiled firmware after warm up, as some are suggesting.

A "cal ppm err @10MHz" option would be stellar ;-)

Pmax65, 2021-02-22:
Hi Joel,
I don't want to teach something that you probably know better than me, but that offset is far too high to justify a bad clock compliance. The nanoVNA uses a good low ppm reference, while the value you reported is on the order of 2775ppm (!!!), which is worse than any even cheapest xtal on the market.
Are you doing the pragmatic measurements for a xtal by means of a VNA?

In case you don't, take a look at this nice VE6WGM's video :

https://www.youtube.com/watch?v=rVIHVi-7brs

Have a great day

Massimo - IK1IZA

Joel-Mckay, 2021-02-22:
Hi Massimo,
Thank you for the reply =)

Yes, I have done quite a bit reading on using the nanoVNA to profile xtals.  In general, I found this method comparison a better video, as it illustrates ways to verify results.
https://www.youtube.com/watch?v=G9zZRNzhsEE

Like yourself, I was rather surprised at the ppm error I ran into. Initially, I thought the manual method I used was in error, grabbed the wrong hc49, or maybe my test jig was wrong. I also tried debugging a little script the community is working on to help improve the laborious matching process, and a similar error occurs with several vendor xtal samples (all report low and within 200ppm).

What signal should we expect if  the stimulus output is set to sweep 10.0MHz to 10.0MHz?
 (i.e. if your unit reports higher than mine, than I may have to probe my PCB oscillator is near 26MHz. if that checks out, than I can roll back to an earlier stable firmware to exclude a possible bug. A version  recommendation would be appreciated.)

Cheers,
Joel
VE7NTP

Pmax65, 2021-02-22:
Hi Joel,

I'm not sure, what do you mean with: "What signal should we expect if the stimulus output is set to sweep 10.0MHz to 10.0MHz?"
Is that a zero span scan?

Anyways, the resonating frequency of a xtal depends upon the capacitive loads applied to its terminals, referring to the following link second drawing, the xtal load capacitance "pull" the resonating frequency between Fs and Fa (a little less indeed, of course)
https://www.microsemi.com/blog/2016/12/15/crystal-pullability-series-vs-parallel-resonant-crystals/
For that reason it is possible, if not probable that the nominal frequency of the xtal you are measuring is obtained with a specific load capacitance applied at its terminals and the ground.
Usually xtals for logic oscillators need those capacitances in the range of 10 to 40pF to get the nominal frequency marked on them.
Could it be that your issue?

Have a great day.

Massimo - IK1IZA

P.S.
I hope I've been clear above, I apologize for my English.

Pmax65, 2021-02-22:
By the way,
take a look at this this Keysight application note:
http://literature.cdn.keysight.com/litweb/pdf/5965-4972E.pdf

In last paragraph figure 13, you can see a specific xtal test fixture to get accurate measurements by null all the parasitic behaviors  of the cables, since very low capacitance can offset the xtal resonance.

Joel-Mckay, 2021-02-22:
"I'm not sure, what do you mean with: "What signal should we expect if the stimulus output is set to sweep 10.0MHz to 10.0MHz?"
Is that a zero span scan?"
Yes, I can measure the single frequency output against a very precise reference. However,  VCO/PLL frequency synthesis are never perfect, and knowing what it should be helps.  i.e. if it is my 50ohm strip-line measurement setup, than the  approx 10MHz read with your scope or counter will still match my nanoVNA output.  Removes a lot of variables.

Thanks again for the links, I will read them when I get home.

Your English is still much better than my Italian...  ;-)
73
VE7NTP

Pmax65, 2021-02-22:
Hi Joel,
now I'm at my home workshop and I made what you said, that is I connected a SMA T to the S11 port and to my Rohded & Schwarz SME generator driven by my DGPSO system on the symmetric port of the T then I connected the S21 port the third T connection via a short cable. I set the nano VNA to 10MHz CW and the generator to 10.000100MHz and I adjusted the generator  level to get the maximum beat on the nanoVNA S21 trace. Then I tuned the generator for the lowest beat frequency (that is for the slowest up and down trace movement).
My nanoVNA reported the minimum frequency beat at -0.2ppm (9.999998MHz)
My nanoVNA H4  reported the minimum frequency beat at +0.7ppm (10.000007MHz)
Hope this could help you.

Have a nice day.

Massimo - IK1IZA

DiSlord, 2022-02-01:
You can calibrate nanoVNA XTAL, if nano know real internal XTAL frequency - it allow correct output.
Now go to
CONFIG->EXPERT SETTINGS->TCXO and set default 26MHz
Set CW freq to 26MHz, wait while device warm up (near 5-10min) measure output frequency.
CONFIG->EXPERT SETTINGS-> TCXO and iput this freq.
After need save config (CONFIG->SAVE)

After this correction NanoVNA CW output must be equal as enter (exist only ~1-2Hz drift, and while device warmup near 10-20Hz)

Thread 56 (2021-05-17):

UART connection using NanoVNA-H v3.4 with UARt pins (VDD, TX, RX, GND) available on PCB.

AdvaithSiva, 2021-05-17:
Hi Hugen,
I am not sure if this is the best place to raise this issue. What would be the best and easiest way to access NanoVNA data via UART?
Does the latest firmware accommodate UART connection? Is there a guide to the commands and other resources for UART communication?
Any help in this matter would be highly appreciated, Hugen

Thank you

Kind regards
Advaith

DiSlord, 2022-02-01:
UART connection avaible and use equal commands as on over USB->COM connection

But need change commands source in CONFIG->CONNECTION menu (and also select speed)
If need save settings - use CONFIG->SAVE CONFIG

Thread 57 (2021-05-24):

Reload FW after uploading wrong version

DABtester, 2021-05-24:
Accidently i uploaded the H4 firmware, and now my device is bricked.
Any way to un-brick it again / upload the correct version?

Thanks

Pmax65, 2021-05-24:
Hi DABtester.
Since the device is hanged-up now, you must turn on the board while short-cutting the two P1 pins named Boot and VDD to start the DFU mode.

Have a great day.

Massimo - IK1IZA

benner, 2021-05-24:
IIRC it can be done by holding some buttons when powering up  too

Pmax65, 2021-05-25:
Hi benner,
> IIRC it can be done by holding some buttons when powering up too
That depends upon the previously uploaded firmware. He got the hardware hanged up by a wrong firmware upload, it shouldn't work because the device is locked somewhere unknown in the code.
The P1 short-cutting is embedded in the bootstrap code and it should be always available independently by downloaded firmware.

Have a great day.

Massimo - IK1IZA

DABtester, 2021-05-25:
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

That worked - many thanks for your help!

Pmax65, 2021-05-25:
Nice to be helpful to you.

Have a great day.

Massimo

Closed 2021-05-25.

Thread 59 (2021-08-30):

firmware make error

JP-rg, 2021-08-30:
I have tried a number of times and looked at editing the files as stated but no success I get the following error

Compiling hal_lld.c
ChibiOS/os/hal/ports/STM32/STM32F0xx/hal_lld.c:54:40: error: expected identifier or '(' before 'void'
 static void hal_lld_backup_domain_init(void) {
                                        ^~~~
ChibiOS/os/hal/ports/STM32/STM32F0xx/hal_lld.c: In function 'hal_lld_init':
ChibiOS/os/hal/ports/STM32/STM32F0xx/hal_lld.c:235:30: error: expected expression before ')' token
   hal_lld_backup_domain_init();
                              ^
make: *** [ChibiOS/os/common/startup/ARMCMx/compilers/GCC/rules.mk:216: build/obj/hal_lld.o] Error 1

Please advise

baudrunner, 2021-10-17:
same

jovo3, 2021-11-04:
Same here. I stepped back in the versions and am able to build until 0.5.0. But once at version 1.x.x, I get the same error.
I have also built the examples in ChibiOS for STM32 and they are building just fine. Any clues here?

PeterDams, 2021-11-04:
I have the same problem, searched everywhere but no solution. This issue is already open since aug 31th. Hope to see an answer soon ;o)

jovo3, 2021-11-07:
Here is a docker file to reproduce the issue we are seeing:
FROM ubuntu:latest

RUN apt -y update
RUN apt -y install git wget make dfu-util

RUN git clone https://github.com/hugen79/NanoVNA-H.git
RUN cd NanoVNA-H/ && git submodule update --init --recursive

RUN wget https://developer.arm.com/-/media/Files/downloads/gnu-rm/8-2018q4/gcc-arm-none-eabi-8-2018-q4-major-linux.tar.bz2
RUN mkdir -p /compiler
RUN tar xfj gcc-arm-none-eabi-8-2018-q4-major-linux.tar.bz2 -C /compiler
ENV PATH /compiler/gcc-arm-none-eabi-8-2018-q4-major/bin:$PATH

RUN cd NanoVNA-H && make && ls

What are we missing in setting up the environment?

hugen79, 2021-12-11:
See this
https://github.com/DiSlord/NanoVNA-D/issues/1#issuecomment-698945620

jovo3, 2022-01-17:
That fixed it for me, too bad it can't build out of the box. For future reference, I did this:

- sed -i 's/hal_lld_backup_domain_init();/\/\/hal_lld_backup_domain_init();/g' NanoVNA-H/ChibiOS/os/hal/ports/STM32/STM32F0xx/hal_lld.c

- sed -i 's/hal_lld_backup_domain_init();/\/\/hal_lld_backup_domain_init();/g' NanoVNA-H/ChibiOS/os/hal/ports/STM32/STM32F3xx/hal_lld.c

- sed -i 's/OSAL_IRQ_HANDLER(STM32_ADC1_HANDLER) {/__attribute__((weak)) OSAL_IRQ_HANDLER(STM32_ADC1_HANDLER) {/g' NanoVNA-H/ChibiOS/os/hal/ports/STM32/LLD>

- and strip out the function in ChibiOS/os/hal/ports/STM32/STM32F3xx/hal_lld.c:54:
 static void hal_lld_backup_domain_init(void) {

Closed 2021-12-11.

Thread 61 (2021-10-16):

Open calibration corrupts S21 measurements using 401 points at 315MHz center with 30MHz span

jeraymond, 2021-10-16:
When I do a full calibration at 315MHz center with a 30MHz span using 401 points the S21 measurements is corrupted and looks to be showing noise.

Steps to reproduce:

1. Configure Trace 0 as S11 logmag and Trace 1 as S21 logmag.
1. Set Sweep Points to 401
2. Set Stimulus center to 315M and span to 30M
3. Reset the Calibration
4. Calibrate Open, Short, Load, Isoln, and Thru then tap Done and Save 0.

Expected:

S12 and S21 measurements (e.g logmag) display correct values.

Actual:

S21 measurements look corrupted and show what looks like noise. S12 measurements look normal.

Other Info:

- I tried some other spans that worked correctly. E.g.) 315MHz center with 100MHz span works. Also 315MHz with 30 MHz span using the default 101 sweep points works.
- The corruption seems to occur when calibrating the Open (with the repro config). When observing S21 logmag trace it changes when calibrating Open in the bug case.

Uncalibrated, notice the blue S21 trace look fairly low noise.

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

Open calibrated, now the blue S21 trace looks much noisier (corrupt).
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

Finished the full calibration and attached bandpass filter as a DUT. S12 logmag look correct, but S21 is noise.
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

Expected S21 output (but uncalibrated).
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

metan-ucw, 2021-12-22:
I can see similar effect but at slightly lower frequency it's centered around 300Mhz. Looks like the 1.0.71 release works fine, but the 1.1 is broken this way.

Thread 62 (2021-10-28):

Connect NanoVNA-H to Windows 7 Machine and Assign COM Port

rpi-maker, 2021-10-28:
Updated firmware on NanoVNA-H to current version 1.0.70, Windows 7 shows "ChibiOS/RT Virtual COM Port" under Universal Serial Bus devices, but won't assign an actual COM Port Number under Ports (COM & LPT) in Windows Computer Management - Device Manager.

Running Windows 7 Professional with SP1
Installed Microsoft Visual C++ Redistributable packages
Successfully Installed STSW-STM32102 - STM32 Virtual COM Port Driver (VCP_V1.5.0_Setup_W7_x64_64bits.exe)

Trying to connect to NanoVNA-Saver, but wont connect without a COM port assigned
https://github.com/NanoVNA-Saver/nanovna-saver

Any help would be appreciated, maybe an issue with the firmware or need a specific Windows 7 driver?

Also, possibly related to the following issue:

"Cannot connect via USB immediately after plugging in" #58
--------------------

NanoVNA-H USB Connection Details on Windows 7 Machine
    =========================== USB Port8 ===========================

Connection Status        : 0x01 (Device is connected)
Port Chain               : 1-1-8

      ========================== Summary =========================
Vendor ID                : 0x0483 (STMicroelectronics)
Product ID               : 0x5740
USB Version              : 1.10
Port maximum Speed       : High-Speed
Device maximum Speed     : Full-Speed
Device Connection Speed  : Full-Speed
Self powered             : yes
Demanded Current         : 100 mA
Used Endpoints           : 4

      ======================== USB Device ========================

        +++++++++++++++++ Device Information ++++++++++++++++++
Device Description       : ChibiOS/RT Virtual COM Port
Device Path 1            : \\?\USB#VID_0483&PID_5740#400#{a5dcbf10-6530-11d2-901f-00c04fb951ed} (GUID_DEVINTERFACE_USB_DEVICE)
Device Path 2            : \\?\USB#VID_0483&PID_5740#400#{f445ae01-1799-49a0-b833-8ebf2fec9ebb}
Kernel Name              : \Device\USBPDO-7
Device ID                : USB\VID_0483&PID_5740\400
Hardware IDs             : USB\VID_0483&PID_5740&REV_0200 USB\VID_0483&PID_5740
Driver KeyName           : {88bae032-5a81-49f0-bc3d-a4ff138216d6}\0014 (GUID_DEVCLASS_USBDEVICE)
Driver                   : system32\DRIVERS\WinUsb.sys (Version: 6.1.7601.17514  Date: 2010-11-20)
Driver Inf               : C:\Windows\inf\oem117.inf
Legacy BusType           : PNPBus
Class                    : USBDevice
Class GUID               : {88bae032-5a81-49f0-bc3d-a4ff138216d6} (GUID_DEVCLASS_USBDEVICE)
Service                  : WinUSB
Enumerator               : USB
Location Info            : Port_#0008.Hub_#0003
Location IDs             : PCIROOT(0)#PCI(1D00)#USBROOT(0)#USB(1)#USB(8)
Container ID             : {760c3622-4a59-596d-bacb-13523c1ebcfe}
Manufacturer Info        : STMicroelectronics
Capabilities             : 0x14 (Removable, UniqueID)
Status                   : 0x0180600A (DN_DRIVER_LOADED, DN_STARTED, DN_DISABLEABLE, DN_REMOVABLE, DN_NT_ENUMERATOR, DN_NT_DRIVER)
Problem Code             : 0
HcDisableSelectiveSuspend: 0
EnableSelectiveSuspend   : 0
SelectiveSuspendEnabled  : 0
EnhancedPowerMgmtEnabled : 0
IdleInWorkingState       : 0
WakeFromSleepState       : 0
Power State              : D0 (supported: D0, D2, D3, wake from D0, wake from D2)

        ---------------- Connection Information ---------------
Connection Index         : 0x08 (Port 8)
Connection Status        : 0x01 (DeviceConnected)
Current Config Value     : 0x01 (Configuration 1)
Device Address           : 0x08 (8)
Is Hub                   : 0x00 (no)
Device Bus Speed         : 0x01 (Full-Speed)
Number Of Open Pipes     : 0x03 (3 pipes to data endpoints)
Pipe[0]                  : EndpointID=2  Direction=IN   ScheduleOffset=5  Type=Interrupt
Pipe[1]                  : EndpointID=1  Direction=OUT  ScheduleOffset=0  Type=Bulk
Pipe[2]                  : EndpointID=1  Direction=IN   ScheduleOffset=0  Type=Bulk
Data (HexDump)           : 08 00 00 00 12 01 10 01 02 00 00 40 83 04 40 57   ...........@..@W
                           00 02 01 02 03 01 01 01 00 08 00 03 00 00 00 01   ................
                           00 00 00 07 05 82 03 08 00 FF 05 00 00 00 07 05   ................
                           01 02 40 00 00 00 00 00 00 07 05 81 02 40 00 00   ..@..........@..
                           00 00 00 00                                       ....

    ---------------------- Device Descriptor ----------------------
bLength                  : 0x12 (18 bytes)
bDescriptorType          : 0x01 (Device Descriptor)
bcdUSB                   : 0x110 (USB Version 1.10)
bDeviceClass             : 0x02 (Communications and CDC Control)
bDeviceSubClass          : 0x00
bDeviceProtocol          : 0x00 (No class specific protocol required)
bMaxPacketSize0          : 0x40 (64 bytes)
idVendor                 : 0x0483 (STMicroelectronics)
idProduct                : 0x5740
bcdDevice                : 0x0200
iManufacturer            : 0x01 (String Descriptor 1)
 Language 0x0409         : "STMicroelectronics"
iProduct                 : 0x02 (String Descriptor 2)
 Language 0x0409         : "ChibiOS/RT Virtual COM Port"
iSerialNumber            : 0x03 (String Descriptor 3)
 Language 0x0409         : "400"
bNumConfigurations       : 0x01 (1 Configuration)
Data (HexDump)           : 12 01 10 01 02 00 00 40 83 04 40 57 00 02 01 02   .......@..@W....
                           03 01                                             ..

    ------------------ Configuration Descriptor -------------------
bLength                  : 0x09 (9 bytes)
bDescriptorType          : 0x02 (Configuration Descriptor)
wTotalLength             : 0x0043 (67 bytes)
bNumInterfaces           : 0x02 (2 Interfaces)
bConfigurationValue      : 0x01 (Configuration 1)
iConfiguration           : 0x00 (No String Descriptor)
bmAttributes             : 0xC0
 D7: Reserved, set 1     : 0x01
 D6: Self Powered        : 0x01 (yes)
 D5: Remote Wakeup       : 0x00 (no)
 D4..0: Reserved, set 0  : 0x00
MaxPower                 : 0x32 (100 mA)
Data (HexDump)           : 09 02 43 00 02 01 00 C0 32 09 04 00 00 01 02 02   ..C.....2.......
                           00 00 05 24 00 10 01 05 24 01 00 01 04 24 02 02   ...$....$....$..
                           05 24 06 00 01 07 05 82 03 08 00 FF 09 04 01 00   .$..............
                           02 0A 00 00 00 07 05 01 02 40 00 00 07 05 81 02   .........@......
                           40 00 00                                          @..

        ---------------- Interface Descriptor -----------------
bLength                  : 0x09 (9 bytes)
bDescriptorType          : 0x04 (Interface Descriptor)
bInterfaceNumber         : 0x00
bAlternateSetting        : 0x00
bNumEndpoints            : 0x01 (1 Endpoint)
bInterfaceClass          : 0x02 (Communications and CDC Control)
bInterfaceSubClass       : 0x02 (Abstract Control Model)
bInterfaceProtocol       : 0x00 (No class specific protocol required)
iInterface               : 0x00 (No String Descriptor)
Data (HexDump)           : 09 04 00 00 01 02 02 00 00                        .........

rpi-maker, 2021-10-31:
I solved this myself.  Ended up using Zadig to replace the drivers for the "ChibiOS/RT Virtual COM Port".  For others with the same problem, try the following:

1. Install Microsoft Visual C++ Redistributable packages
2. Install STSW-STM32102 - STM32 Virtual COM Port Driver (VCP_V1.5.0_Setup_W7_x64_64bits.exe) from https://www.st.com/en/development-tools/stsw-stm32102.html
3. In Zadig - Options - List All Devices.
4. In Zadig - Select "ChibiOS/RT Virtual COM Port" device in the drop down list
5. In Zadig - Select "USB Serial (CDC)" as the replacement driver
6. In Zadig - Upgrade Driver
7. Verify Windows Computer Management - Device Manager assigned a COM Port # for the NanoVNA
8. Open NanoVNA-Saver - Serial Port Control (lower left) should show COM Port # assigned to NanoVNA (for me "COM16 (NanoVNA)" is listed)
9. NanoVNA-Saver - Serial Port Control - Connect to Device

Hope this helps someone else get NanoVNA-Saver up and running with the current firmware.

Closed 2021-10-31.

Thread 64 (2022-01-16):

1.1.01 : Toggling to mode SI5351 does not stay set between reboots.

Sarah-C, 2022-01-16:
Should it be getting stored in EEPROM? (My system doesn't have an SD card on board.)

Sarah-C, 2024-04-13:
Thanks!

Closed 2024-04-13.

Thread 65 (2022-01-19):

Marker Search Values are incorrectly saved to calibration when Tracking is ON

davidlopezsalvador, 2022-01-19:
- Marker->Tracking set to ON.
- Marker->Search set  MINIMUM (e.g. track for minimum SWR)
- Save calibration.

After power cycle value is set to MAXIMUM.
If you only RECALL without power cycle, value is correctly recalled (MINIMUM).

Thread 66 (2022-02-05):

Can't compile for target F072 (cannot move location counter backwards)

piv3rt, 2022-02-05:
Hello,

When trying to compile this project for NanoVNA-H (`TARGET=F072`), the build fails with this error:

```
user@linux$ make TARGET=F072
[...]
Compiling vna_math.c
Linking build/ch.elf
/usr/local/gcc-arm-none-eabi-8-2018-q4-major/bin/../lib/gcc/arm-none-eabi/8.2.1/../../../../arm-none-eabi/bin/ld:rules_data.ld:270 cannot move location counter backwards (from 0000000020004098 to 0000000020004000)
collect2: error: ld returned 1 exit status
make: *** [ChibiOS/os/common/startup/ARMCMx/compilers/GCC/rules.mk:243: build/ch.elf] Error 1
The command '/bin/sh -c make TARGET=F072' returned a non-zero code: 2
```
I should add that I commented out the following line in the Makefile to not encounter the problem described in [this issue](https://github.com/hugen79/NanoVNA-H/issues/59):
```#UDEFS+= -DVNA_AUTO_SELECT_RTC_SOURCE```

lx0758, 2022-03-12:
+1

lx0758, 2022-03-16:
@hugen79 能指点下迷津吗?

lx0758, 2022-03-16:
Tested modified [STM32F072xB ld] (https://github.com/hugen79/NanoVNA-H/blob/master/NANOVNA_STM32_F072/STM32F072xB.ld) can be compiled through,  But this does not seem to be the optimal solution.

lx0758, 2022-03-16:
Tested modified [STM32F072xB ld](https://github.com/hugen79/NanoVNA-H/blob/master/NANOVNA_STM32_F072/STM32F072xB.ld) can be compiled through,  But this does not seem to be the optimal solution.

lx0758, 2022-03-16:
Tested modified [STM32F072xB.ld] (https://github.com/hugen79/NanoVNA-H/blob/master/NANOVNA_STM32_F072/STM32F072xB.ld) can be compiled through,  But this does not seem to be the optimal solution.

lx0758, 2022-03-16:
Tested modified [STM32F072xB.ld](https://github.com/hugen79/NanoVNA-H/blob/master/NANOVNA_STM32_F072/STM32F072xB.ld) can be compiled through,  But this does not seem to be the optimal solution.

piv3rt, 2022-03-16:
How did you do this? Did you adjust the size of flash0 and flash7?

lx0758, 2022-03-17:
I adjusted falsh0 and falsh7, but the total amount is limited to 128k, which is not a big problem. But to compile, I have to adjust ram0, which is obviously a problem. I wonder, how does @hugen79 do it?

piv3rt, 2022-03-17:
Just trying to guess, I could be entirely wrong but maybe @hugen79 is using a compiler on a different platform which produces an image with a slightly smaller RAM footprint which doesn't exceed the size specified in the file you linked.
I'm building on Linux, I tried on a destkop Fedora and inside an ubuntu Docker container. Both produced the same result.
@lx0758, are you building on Linux too?

piv3rt, 2022-03-17:
I added a linker arg to dump the memory usage and it shows that both flash and ram regions overflow when building the project for STM32F072xB with default options enabled. Removing SD card support allows to save a little flash and I will now analyse how we can save RAM.

`make TARGET=F072 USE_LDOPT=--print-memory-usage`

lx0758, 2022-03-17:
I've tried it on Windows/Linux/Docker and it always ends the same.

lx0758, 2022-03-18:
The latest news!  I use <https://github.com/DiSlord/NanoVNA-D> ChibiOS folder to replace after successful compilation.

piv3rt, 2022-03-18:
Just to be sure: did you replace the ChibiOS directory in this project with the one in DiSlord's project and compile again?
There's an alignment difference for .text sections that helps save a little space in flash but after looking at the diff between those folders, I'm not sure what makes it save RAM.

Well, thanks, this workaround is a bit dirty but it works and even solves the [hal_lld_backup_domain_init issue](https://github.com/hugen79/NanoVNA-H/issues/59).

lx0758, 2022-03-18:
I burned and verified the compiled firmware. Unfortunately, it worked but the measurement function was basically broken.

tjozwiak, 2022-06-14:
Hi, don't know is still valid, but the last commit, which can be compilable for me is:

commit 2efd9450ed8f945fa5feef5f57630723cc165e65 (tag: 1.0.70)
Author: hugen79 <hugen@outlook.com>
Date:   Fri Oct 8 23:11:50 2021 +0800

To do that, some feature blocking is needed  (base on analysis - what has been added during merge from
source code of DiSlord version 1.0.69).

The limit is the size of RAM and Flash, which is not changable w/o uC changing :)

The status after the build:

   text	   data	    bss	    dec	    hex	filename
  79036	    392	  16184	  95612	  1757c	build/ch.elf

If someone is interested in - patch attached.
Haven't have possibility to test this on NanoVna-H  (HW platform  3.6). Still waiting for it :)

Hopefully will help you.

Br, Tomek (SP7TEP)

[0001-Build-adjust-configuration-to-make-code-compilable-f.zip](https://github.com/hugen79/NanoVNA-H/files/8898973/0001-Build-adjust-configuration-to-make-code-compilable-f.zip)

tjozwiak, 2022-06-14:
just one info from USE_LDOPT=--print-memory-usage:

Linking build/ch.elf
Memory region         Used Size  Region Size  %age Used
          flash0:       79428 B        96 KB     80.80%
          flash1:          0 GB         0 GB      -nan%
          flash2:          0 GB         0 GB      -nan%
          flash3:          0 GB         0 GB      -nan%
          flash4:          0 GB         0 GB      -nan%
          flash5:          0 GB         0 GB      -nan%
          flash6:          0 GB         0 GB      -nan%
          flash7:          0 GB        32 KB      0.00%
            ram0:         16 KB        16 KB    100.00%
            ram1:          0 GB         0 GB      -nan%
            ram2:          0 GB         0 GB      -nan%
            ram3:          0 GB         0 GB      -nan%
            ram4:          0 GB         0 GB      -nan%
            ram5:          0 GB         0 GB      -nan%
            ram6:          0 GB         0 GB      -nan%
            ram7:          0 GB         0 GB      -nan

tjozwiak, 2022-06-14:
Ok, finally found a solution.

To optimize a RAM memory usage there's only one way just to reduce the sweep point a bit off. any reduction is multiply by 16,
so when you reduce from 101 points to 99 points -> there's 32bytes less :)

Also I've switched off the SERIAL CONSOLE to keep SD CARD and all measure module enabled.
Now I manage to compile on HEAD of master branch.

New patch attached.

**ALSO: Haven't have possibility to test this on NanoVna-H (HW platform 3.6) , like prev. one**

Cheers Tomek

[0002-Build-adjust-configuration-to-make-code-compilable-f.zip](https://github.com/hugen79/NanoVNA-H/files/8900072/0002-Build-adjust-configuration-to-make-code-compilable-f.zip)

piv3rt, 2022-08-17:
Thank you, Tomasz!
I had disabled some features but hadn't thought about reducing the number of sweep points, which saves quite some RAM...
Nice trick!

Thread 70 (2022-05-07):

Add a mode to measure Common Mode Current Chokes

dkozel, 2022-05-07:
### Work in Progress

A request came up in a forum to support directly measuring and plotting the series resistance and reactance of a Common Mode Current Choke, which can be realistically modeled as a pi network with shunt capacitances and a complex series impedence. With only S11 and S21 available the output capacitance cannot be calculated, but the capacitances are usually similar and someone could physically reverse the NanoVNA to make the complete measurement.

This issue is both a feature request and to gather the information required to implement the measurement mode.

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

These three values can be easily extracted from the Admittance parameters.
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

**Series Impedence**
Z_series = -1 / Y21

**Shunt Impedences**
Z_shunt,in = 1 / (Y11 + Y21)
Z_shunt,out = 1 / (Y22 + Y21)

**Shunt Capacitances**
C_shunt,in = Real(1 / (j2 * pi * freq * Z_shunt,in)) * 1e12
C_shunt,out = Real(1 / (j2 * pi * freq * Z_shunt,out)) * 1e12

## Math operations

Calculation of Y values
https://github.com/hugen79/NanoVNA-H/blob/ba4dcc762ae8c35b0e473580fcea51e885091d1b/plot.c#L453-L459

Function producing the Admittance Y values for the `|Y|` mode.
https://github.com/hugen79/NanoVNA-H/blob/ba4dcc762ae8c35b0e473580fcea51e885091d1b/plot.c#L506-L510

## Plotting Operations
Trace Type:
https://github.com/hugen79/NanoVNA-H/blob/ba4dcc762ae8c35b0e473580fcea51e885091d1b/plot.c#L578
https://github.com/hugen79/NanoVNA-H/blob/ba4dcc762ae8c35b0e473580fcea51e885091d1b/plot.c#L594

Menu item to select trace type:
https://github.com/hugen79/NanoVNA-H/blob/ba4dcc762ae8c35b0e473580fcea51e885091d1b/ui.c#L1641

Thread 75 (2023-04-25):

NanoVNA-H4 Hanging on scan

TK0130, 2023-04-25:
I recently designed a clone of the nanoVNA-H4 for a research project as I wanted a better (larger) platform to tinker with than the nanoVNA. (Larger components, low frequency stuff and I wanted to just tinker in general.)

Anyway, I can flash firmware to it using DFuse and talk to it over USB (Serial port, 115200 baud rate.) and everything seems to be working there. (uC is booting up OK etc.)

The issue is that it hangs anytime I try to do anything "analog" (Scan, etc.) and thus crashes nanoVNA saver.

I was wondering if you had any advice on where to start debugging.

Attached is the schematic I used as a reference and the firmware file.
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
[NanoVNA.H4.v1.2.20(1).zip](https://github.com/hugen79/NanoVNA-H/files/11326245/NanoVNA.H4.v1.2.20.1.zip)

The only major deviations from the attached schematic are that I gutted out the battery circuitry and the LCD as I didn't need them. (I still broke out the connections to pads just in case.) I also used the STM32F303

Thread 77 (2023-05-08):

NanoVNA-H v 1.2.14 - SWR scan freezes for a second or two every so often.

Sarah-C, 2023-05-08:
Using V 1.2.14, I've got one trace running, SWR - giving a good trace of an antenna.

Every few seconds it pauses..... though the menu's still respond. I've not clicked the "Pause" button on the menu system.
Nothing else to report about reproducing the issue.

Post here if anyone else has noticed this - or if it's just me!

koriwi, 2023-08-25:
same here

sergey12malyshev, 2023-08-28:
A similar problem. When you move the slider, the screen freezes. MS5351 , version 1.2.14. Has the author abandoned this project?

sergey12malyshev, 2023-08-31:
I found out that freezes occur when the serial port is turned on. To begin with, it's worth checking that CONFIG -> CONNECTION costs USB. It helps in part. Next, you can build the firmware with the __USE_SERIAL_CONSOLE__ macro disabled. I attach a link to my fork of the project with firmware: https://github.com/sergey12malyshev/NanoVNA-H/releases/tag/1.2.14%2B
https://github.com/sergey12malyshev/NanoVNA-H/tree/NoShell

I had freezes when working with the control wheel and just when working.

koriwi, 2023-09-19:
@sergey12malyshev thanks for your invenstigation! if it annoys me too much i know how to fix it. But for now i will leave it enabled as from time to time i use the serial connection :)

Thread 78 (2023-05-17):

NanoVNA H4 does not starts

DimSUN19, 2023-05-17:
When it switch on there are no any changes on display and no response to toush the display or press the button. Howerware you can put it into programming mode by POWER+BUTTON. Also you can update the firmware. I already did clearconfig 1234 and update the firmware. No result
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

hugen79, 2024-02-20:
Please remove the protective film.

Closed 2024-02-20.

Thread 80 (2023-12-11):

New version no longer has AA like in 2020

tuvok81, 2023-12-11:
Hello,
I have a question and I currently have the 1.0.45 from 2020 or so on my NanoVNA
At that time, version AA was installed for a better view with only 2 measuring points.
but with the new versions I don't understand which one is similar to the AA version from back then.
It would be nice if someone could help me.

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

hugen79, 2024-02-20:
The latest version already uses larger fonts and is no longer available in AA.

Closed 2024-02-20.

Thread 81 (2024-03-02):

Menu on right does not work

caplij, 2024-03-02:
I haven't used my NanoVna - h4 for a couple months.  Today I turned it on and the menus do not work.  Tapping on the screen opens the menu but none of the choices work either by using the button at the top or the screen input.  I tried doing a firmware update but it has the same result.  Any ideas what could cause this.  I tried a couple different firmware updates but all had the same result.   Also took the cover off and even out of the case it does the same thing.

caplij, 2024-03-04:
I found the problem!  Took it apart again and looked at all of it with a 10X magnifier.  Didn't find anything but when I brushed it all off with an artists brush this tiny piece of debris fell out.  Maybe 2 mm in size.  Put it back together and now it works fine.  Something must have been shorted...
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

Thread 82 (2024-03-23):

How to read an write flash/firmware with Linux ?

ds2k5, 2024-03-23:
Hello,

NanoVNA-H HW: 3.61_SM-ST

how to save the firmware from the device to a file linux ?
how to write frimware to the device with linux ?

Thanks

rag2, 2025-04-11:
Try (https://groups.io/g/nanovna-users/files/Nano%20VNA%20Saver/nanoVNA-H4%20software%20support%20under%20Ubuntu.pdf)
The **dfu-util** package can also download the contents of a device to a file. (Explained in the man page or search on-line.)
But please note, the issues list is **not** the most useful place for user support. Your favourite search engine, or preferred AI, is, or should be, your friend.

Thread 84 (2024-07-25):

Enter correction Data of Cal.-Kit.

Meckiilino, 2024-07-25:
Hello,
my Cal.-Kit have some correctiondata to be entered in the calibration settings.
Somthing like:

**Load:**
L = x.yy nH
C|| = xx fF
R = 50.12 Ohm
Delay = -xxx.yy ps

**Open:**
Delay = -xxx.yy ps
C|| = xx fF

**Short:**
L = x.yy nH
Delay = -xxx.yy ps

Do you see some posibility to add this correction feature to the firmware?

hugen79, 2025-02-20:
It is not supported at the moment, you can use nanoVNA-saver on your PC.

Closed 2025-02-20.

Thread 85 (2024-08-11):

What are Format S11, Format S21, Channel S11

Sarah-C, 2024-08-11:
Is there a doc anywhere about the three "format, format, channel" buttons anywhere?

They're in the 1.2.27 build, but I'm a bit confused about how they flip, and what they're doing.

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

Sarah-C, 2024-08-12:
Nothing yet... I'll keep monitoring!

Sarah-C, 2024-08-12:
I noticed in ui.c, that the "channel" button mostly appears to toggle the kind of smith chart it uses - roughly speaking.

Any clearer explanation would be awesome! =)

`#define F_S11     0x00
#define F_S21     0x80
static UI_FUNCTION_ADV_CALLBACK(menu_format_acb)
{
  if (current_trace == TRACE_INVALID) return; // Not apply any for invalid traces
  uint16_t format = data & (~F_S21);
  uint16_t channel = data & F_S21 ? 1 : 0;
  if (b) {
    if (trace[current_trace].type == format && trace[current_trace].channel == channel)
      b->icon = BUTTON_ICON_CHECK;
    if (format == TRC_SMITH) {
      uint8_t marker_smith_format = get_smith_format();
      if ((channel == 0 && !S11_SMITH_VALUE(marker_smith_format)) ||
          (channel == 1 && !S21_SMITH_VALUE(marker_smith_format))) return;
      plot_printf(b->label, sizeof(b->label), "%s\n" R_LINK_COLOR "%s", get_trace_typename(TRC_SMITH, marker_smith_format), get_smith_format_names(marker_smith_format));
    }
    else
      b->p1.text = get_trace_typename(format, -1);
    return;
  }

  if (format == TRC_SMITH && trace[current_trace].type == TRC_SMITH && trace[current_trace].channel == channel)
    menu_push_submenu(channel == 0 ? menu_marker_s11smith : menu_marker_s21smith);
  else
    set_trace_type(current_trace, format, channel);
}

static UI_FUNCTION_ADV_CALLBACK(menu_channel_acb)
{
  (void)data;
  if (current_trace == TRACE_INVALID) {if (b) b->p1.text = ""; return;}
  int ch = trace[current_trace].channel;
  if (b){
    b->p1.text = ch == 0 ? "S11 (REFL)" : "S21 (THRU)";
    return;
  }
  set_trace_channel(current_trace, ch^1);
}
`

KDMcMullan, 2025-09-01:
I took some time to get my head around this, too. There may not be any nanoVNA specific info, since these channels are generic things that someone who uses a VNA would know. This was my first VNA, so I did not know!
The channel button allows you to select between S11 and S21 modes. S11 is "reflected" mode where you only use the S11 port (AKA port 1), which sends out a signal and watches for a reflected signal bouncing back. S21 is "through" mode where you use both ports: port 1 sends out a frequency and port 2 watches for the return signal.
Format S11 allows you to select the type of measurement to perform in S11 mode. Format S21 allows you to select the type of measurement to perform in S21 mode.

Thread 86 (2024-08-14):

NanoVNA-H

TimBastress, 2024-08-14:
I'm trying to update the firmware in my NanoVNA-H to the latest shown here of v1.2.29 using the .dfu file and stm32CubeProgrammer software on Windows.

It seems to recongnize the connection and it reads it ok, and it seems to wirte the .dfu file ok as well but when I power off my vna and power it back on I just see a white screen. I cant seem to get it to boot back into the VNA screen.

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

any help would be greatly appreciated!

Tim

TimBastress, 2024-08-17:
the HW version on the back says 3.6_MS

It had a graphical video before i tried to upgrade the firmware. So I'm really confused as to why I cant get it to restart after the upgrade "seemingly successful"

TimBastress, 2024-08-20:
So apparently I've bricked my VNA while trying to do a firmware update since no one is responding back to me with a solution to my problem.
Everything seemed to go well, but all I get is a white screen afterwards.  Even if I power down and back on still get white screen.  Surely someone out there has had this issue or knows what the issue is and can help me.

What am I doing wrong?

ChrisHVL, 2024-08-20:
Hi,
maybe you should look here:

https://groups.io/g/nanovna-users/topic/nanovna_white_screen_usb_dead/71530182

Also there are many HAMs, which are using NANOVNA and have had similar experiences.
In my case, update via USB and DFUse had always worked.
vy73 DD6CN

TimBastress, 2024-08-21:
Thank you for the link above.   I'm rereading it again to make sure I'm not missing anything but I'm  still having issues. So it seems that when I try using dfuse demo software that it doesnt see the nanovna even though my windows computer sees it and the bootloader drivers activate and everything shows good the demo software doesnt seem to see it.    But when I use the STM32 Cube software it sees it just fine.   But neither are making a difference in getting my VNA to boot up properly.  This is very frustrating.   Normally updates go well for me via windows apps but not this one.

ChrisHVL, 2024-08-21:
Hi,
you may also look here:

https://nanovna.com/?page_id=103

There are several sites regarding NANOVNA...
In groups.io you may get support or in your local radio club.
vy73

Thread 87 (2024-10-02):

Screen garbage on first power up

etkal, 2024-10-02:
Just bought a new NanoVNA, HW 3.6.1_SM_ST, looks like the latest firmware from here (shows 1.2.27, and I even reloaded the latest image from here so it's identical).  When I first power it on after being off for a while, the screen flashes white, but then shows garbage on the upper half, which when written over by the display image still shows garbage data on the left side.  Powering off and back on fixes the issue, just flashes white, then display off, then draws as expected.

I suspect a timing issue on startup, might experiment with that, perhaps a delay is needed to allow the ili9341 HW to stabilize when cold.  I have a couple Raspberry Pi Pico projects that use the ili9341 and I had to play with the reset timing at startup to get it to behave properly:

void ILI934X::Reset()
{
    gpio_put(m_rst, 1);
    sleep_ms(50);
    gpio_put(m_rst, 0);
    sleep_ms(50);
    gpio_put(m_rst, 1);
    sleep_ms(50);
}

Have you seen this or had it reported before?  I'll see if I can experiment with this code, have not developed for this processor / SDK before.

  Regards,
  Erik

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

etkal, 2024-11-05:
Is anyone else seeing this??

hugen79, 2025-02-20:
The new version already performs lcd_clear_screen() once before entering the main boundary;

Closed 2025-02-20.

Thread 90 (2024-12-13):

Display frequency does not update when using UART Sweep command.

la3pna, 2024-12-13:
It seems that the "weep 5000000 200000000 101 \r\n" command means that the screen picture is not updated.

This picture is a sweep from 5MHz to 200MHz using the above command, but the readout is wrong:

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

Thread 91 (2025-01-14):

arm-none-eabi-gcc: 1: ELF: not found

PatrickAtBritpol, 2025-01-14:
My system:
NanoVNA-H 4 (currently ver.: 0.5.0 (Feb 2020))
Raspberry Pi 5 Debian Bookworm 64bit

```
wget https://developer.arm.com/-/media/Files/downloads/gnu-rm/8-2018q4/gcc-arm-none-eabi-8-2018-q4-major-linux.tar.bz2
sudo tar -xjf gcc-arm-none-eabi-8-2018-q4-major-linux.tar.bz2 -C /usr/local
PATH=/usr/local/gcc-arm-none-eabi-8-2018-q4-major/bin:$PATH
sudo apt install -y dfu-util
git clone https://github.com/hugen79/NanoVNA-H.git --branch F303
git submodule update --init --recursive
#Submodule path 'ChibiOS': checked out 'ac2d4b15de5f6433cef452dbc26b1d2a4242d063'
cd NanoVNA-H/
make
```

unfortunately I hit a snag:

```
Compiler Options
arm-none-eabi-gcc -c -mcpu=cortex-m4 -O2 -fno-inline-small-functions -ggdb -fomit-frame-pointer -falign-functions=16 --specs=nano.specs -fstack-usage -std=c11 -ffunction-sections -fdata-sections -fno-common -mfloat-abi=hard -mfpu=fpv4-sp-d16 -fsingle-precision-constant -Wall -Wextra -Wundef -Wstrict-prototypes -Wa,-alms=build/lst/ -DCORTEX_USE_FPU=TRUE -DARM_MATH_CM4 -DVERSION="0.4.5-22-g3794bbe" -DNANOVNA_F303 -D__FPU_PRESENT -D__FPU_USED -DST7796S -DVNA_AUTO_SELECT_RTC_SOURCE -DTHUMB_PRESENT -mno-thumb-interwork -DTHUMB_NO_INTERWORKING -MD -MP -MF .dep/build.d -I. -IChibiOS/os/license -IChibiOS/os/common/startup/ARMCMx/compilers/GCC -IChibiOS/os/common/startup/ARMCMx/devices/STM32F3xx -IChibiOS/os/common/ext/CMSIS/include -IChibiOS/os/common/ext/CMSIS/ST/STM32F3xx -IChibiOS/os/rt/include -IChibiOS/os/common/oslib/include -IChibiOS/os/common/ports/ARMCMx -IChibiOS/os/common/ports/ARMCMx/compilers/GCC -IChibiOS/os/hal/osal/rt -IChibiOS/os/hal/include -IChibiOS/os/hal/ports/common/ARMCMx -IChibiOS/os/hal/ports/STM32/STM32F3xx -IChibiOS/os/hal/ports/STM32/LLD/ADCv3 -IChibiOS/os/hal/ports/STM32/LLD/CANv1 -IChibiOS/os/hal/ports/STM32/LLD/DACv1 -IChibiOS/os/hal/ports/STM32/LLD/DMAv1 -IChibiOS/os/hal/ports/STM32/LLD/EXTIv1 -IChibiOS/os/hal/ports/STM32/LLD/GPIOv2 -IChibiOS/os/hal/ports/STM32/LLD/I2Cv2 -IChibiOS/os/hal/ports/STM32/LLD/RTCv2 -IChibiOS/os/hal/ports/STM32/LLD/SPIv2 -IChibiOS/os/hal/ports/STM32/LLD/TIMv1 -IChibiOS/os/hal/ports/STM32/LLD/USARTv2 -IChibiOS/os/hal/ports/STM32/LLD/USBv1 -IChibiOS/os/hal/ports/STM32/LLD/xWDGv1 -I./NANOVNA_STM32_F303 -IChibiOS/os/hal/lib/streams main.c -o main.o

Compiling crt0_v7m.s
/usr/local/gcc-arm-none-eabi-8-2018-q4-major/bin/arm-none-eabi-gcc: 1: ELF: not found
/usr/local/gcc-arm-none-eabi-8-2018-q4-major/bin/arm-none-eabi-gcc: 5: Syntax error: "(" unexpected
make: *** [ChibiOS/os/common/startup/ARMCMx/compilers/GCC/rules.mk:225: build/obj/crt0_v7m.o] Error 2
```

Should I be using a different gcc? Searching Debian repository I can see:

```
apt-cache search gcc-arm
gcc-arm-none-eabi - GCC cross compiler for ARM Cortex-R/M processors
```

Please advise

PatrickAtBritpol, 2025-01-14:
I did switch to Debian's gcc. It did fail to finish but got me closer:

```
make
Compiling crt0_v7m.s
Compiling chcoreasm_v7m.s
Compiling crt1.c
Compiling vectors.c
Compiling chsys.c
Compiling chdebug.c
Compiling chtrace.c
Compiling chvt.c
Compiling chschd.c
Compiling chthreads.c
Compiling chcore.c
Compiling chcore_v7m.c
In file included from ChibiOS/os/common/ext/CMSIS/ST/STM32F3xx/stm32f303xc.h:168,
                 from ChibiOS/os/common/ext/CMSIS/ST/STM32F3xx/stm32f3xx.h:153,
                 from ChibiOS/os/common/startup/ARMCMx/devices/STM32F3xx/cmparams.h:72,
                 from ChibiOS/os/common/ports/ARMCMx/chcore.h:70,
                 from ChibiOS/os/rt/include/ch.h:81,
                 from ChibiOS/os/common/ports/ARMCMx/chcore_v7m.c:28:
In function '__set_PSP',
    inlined from 'SVC_Handler' at ChibiOS/os/common/ports/ARMCMx/chcore_v7m.c:79:3:
ChibiOS/os/common/ext/CMSIS/include/core_cm4.h:85:28: warning: listing the stack pointer register 'sp' in a clobber list is deprecated [-Wdeprecated]
   85 |   #define __ASM            __asm                                      /*!< asm keyword for GNU Compiler          */
      |                            ^~~~~
ChibiOS/os/common/ext/CMSIS/include/core_cmFunc.h:443:3: note: in expansion of macro '__ASM'
  443 |   __ASM volatile ("MSR psp, %0\n" : : "r" (topOfProcStack) : "sp");
      |   ^~~~~
ChibiOS/os/common/ext/CMSIS/include/core_cm4.h:85:28: note: the value of the stack pointer after an 'asm' statement must be the same as it was before the statement
   85 |   #define __ASM            __asm                                      /*!< asm keyword for GNU Compiler          */
      |                            ^~~~~
ChibiOS/os/common/ext/CMSIS/include/core_cmFunc.h:443:3: note: in expansion of macro '__ASM'
  443 |   __ASM volatile ("MSR psp, %0\n" : : "r" (topOfProcStack) : "sp");
      |   ^~~~~
In function '__set_PSP',
    inlined from '_port_irq_epilogue' at ChibiOS/os/common/ports/ARMCMx/chcore_v7m.c:147:5:
ChibiOS/os/common/ext/CMSIS/include/core_cm4.h:85:28: warning: listing the stack pointer register 'sp' in a clobber list is deprecated [-Wdeprecated]
   85 |   #define __ASM            __asm                                      /*!< asm keyword for GNU Compiler          */
      |                            ^~~~~
ChibiOS/os/common/ext/CMSIS/include/core_cmFunc.h:443:3: note: in expansion of macro '__ASM'
  443 |   __ASM volatile ("MSR psp, %0\n" : : "r" (topOfProcStack) : "sp");
      |   ^~~~~
ChibiOS/os/common/ext/CMSIS/include/core_cm4.h:85:28: note: the value of the stack pointer after an 'asm' statement must be the same as it was before the statement
   85 |   #define __ASM            __asm                                      /*!< asm keyword for GNU Compiler          */
      |                            ^~~~~
ChibiOS/os/common/ext/CMSIS/include/core_cmFunc.h:443:3: note: in expansion of macro '__ASM'
  443 |   __ASM volatile ("MSR psp, %0\n" : : "r" (topOfProcStack) : "sp");
      |   ^~~~~
Compiling osal.c
Compiling hal.c
Compiling hal_st.c
Compiling hal_buffers.c
Compiling hal_queues.c
Compiling hal_mmcsd.c
Compiling hal_adc.c
Compiling hal_dac.c
Compiling hal_ext.c
Compiling hal_gpt.c
Compiling hal_i2c.c
Compiling hal_i2s.c
Compiling hal_pal.c
Compiling hal_serial.c
Compiling hal_serial_usb.c
Compiling hal_spi.c
Compiling hal_usb.c
ChibiOS/os/hal/src/hal_usb.c: In function '_usb_ep0in':
ChibiOS/os/hal/src/hal_usb.c:842:8: warning: this statement may fall through [-Wimplicit-fallthrough=]
  842 |     if ((usbp->ep0n < max) &&
      |        ^
ChibiOS/os/hal/src/hal_usb.c:851:3: note: here
  851 |   case USB_EP0_WAITING_TX0:
      |   ^~~~
In file included from ChibiOS/os/rt/include/ch.h:82,
                 from ChibiOS/os/hal/osal/rt/osal.h:32,
                 from ChibiOS/os/hal/include/hal.h:28,
                 from ChibiOS/os/hal/src/hal_usb.c:27:
ChibiOS/os/rt/include/chdebug.h:129:6: warning: this statement may fall through [-Wimplicit-fallthrough=]
  129 |   if (CH_DBG_ENABLE_ASSERTS != FALSE) {                                     \
      |      ^
ChibiOS/os/hal/osal/rt/osal.h:241:34: note: in expansion of macro 'chDbgAssert'
  241 | #define osalDbgAssert(c, remark) chDbgAssert(c, remark)
      |                                  ^~~~~~~~~~~
ChibiOS/os/hal/src/hal_usb.c:873:5: note: in expansion of macro 'osalDbgAssert'
  873 |     osalDbgAssert(false, "EP0 state machine error");
      |     ^~~~~~~~~~~~~
ChibiOS/os/hal/src/hal_usb.c:875:3: note: here
  875 |   case USB_EP0_ERROR:
      |   ^~~~
ChibiOS/os/hal/src/hal_usb.c: In function '_usb_ep0out':
ChibiOS/os/rt/include/chdebug.h:129:6: warning: this statement may fall through [-Wimplicit-fallthrough=]
  129 |   if (CH_DBG_ENABLE_ASSERTS != FALSE) {                                     \
      |      ^
ChibiOS/os/hal/osal/rt/osal.h:241:34: note: in expansion of macro 'chDbgAssert'
  241 | #define osalDbgAssert(c, remark) chDbgAssert(c, remark)
      |                                  ^~~~~~~~~~~
ChibiOS/os/hal/src/hal_usb.c:932:5: note: in expansion of macro 'osalDbgAssert'
  932 |     osalDbgAssert(false, "EP0 state machine error");
      |     ^~~~~~~~~~~~~
ChibiOS/os/hal/src/hal_usb.c:934:3: note: here
  934 |   case USB_EP0_ERROR:
      |   ^~~~
Compiling nvic.c
Compiling hal_lld.c
ChibiOS/os/hal/ports/STM32/STM32F3xx/hal_lld.c:54:40: error: expected identifier or '(' before 'void'
   54 | static void hal_lld_backup_domain_init(void) {
      |                                        ^~~~
ChibiOS/os/hal/ports/STM32/STM32F3xx/hal_lld.c: In function 'hal_lld_init':
ChibiOS/os/hal/ports/STM32/STM32F3xx/hal_lld.c:116:30: error: expected expression before ')' token
  116 |   hal_lld_backup_domain_init();
      |                              ^
make: *** [ChibiOS/os/common/startup/ARMCMx/compilers/GCC/rules.mk:216: build/obj/hal_lld.o] Error 1
```

As shown, after a bunch of warnings, compiling hal_lld.c fails.

```
Compiling hal_lld.c
ChibiOS/os/hal/ports/STM32/STM32F3xx/hal_lld.c:54:40: error: expected identifier or '(' before 'void'
   54 | static void hal_lld_backup_domain_init(void) {
      |                                        ^~~~
ChibiOS/os/hal/ports/STM32/STM32F3xx/hal_lld.c: In function 'hal_lld_init':
ChibiOS/os/hal/ports/STM32/STM32F3xx/hal_lld.c:116:30: error: expected expression before ')' token
  116 |   hal_lld_backup_domain_init();
      |                              ^
make: *** [ChibiOS/os/common/startup/ARMCMx/compilers/GCC/rules.mk:216: build/obj/hal_lld.o] Error 1
```

Thread 92 (2025-02-20):

Continuous polling of data leads to freezing and hanging of USB stack

momentics, 2025-02-20:
**Probably related to https://github.com/hugen79/NanoVNA-H/issues/75**

The issue causes to hang PC (its USB stack and the application that uses it). It might be python custom script or NanoVNA.Saver. To restore, application requres to be killed and restarted but device requires to be reconnected or restarted.
The stand is assembled from a personal computer, a cord from the kit and a nanovna-h F072 device. The device itself had NanoVNA-H-SI_20250220.dfu.

- Windows 10 x64 PC, USB cable + pynanovna with 5 lines of code or NanoVNA.Saver software
- 1Mhz-500Mhz streaming read of S11, S21, freq or constantly (without delay) sweeping from NanoVNA.Saver software

10-40 min of reading this way and hungs completely. This not happen with edy555  0.8.0 firmware but does latest hugen79 and DiSlord.

- it might be device's CPU stack overflow?
- it might be an error in device's CDC behaviour implementation?

We have an example that works perfectly (added: for weeks nonstop) edy555 0.8.0, but it very old firmaware and the issue is very appreciated to be resolved.

momentics, 2025-03-04:
got some experimental results on a sample of devices. The test stand used:

- 1 NanoVNA-F v3 - reference device
- 4 NanoVNA-H, F072, two with DiSlord's and two with hugen79's firmwares.
- The devices were not accessed via USB interface, but they were powered over USB (Logmag S11 1Mhz-500Mhz, calibrated).

During the week of 24/7 operation there were no hangs with any firmware. But we know DiSlord's and hugen79's hung on other scenario.
