hugen79/NanoVNA-H/doc/Schematic_nanovna_H_REV3_7.pdf

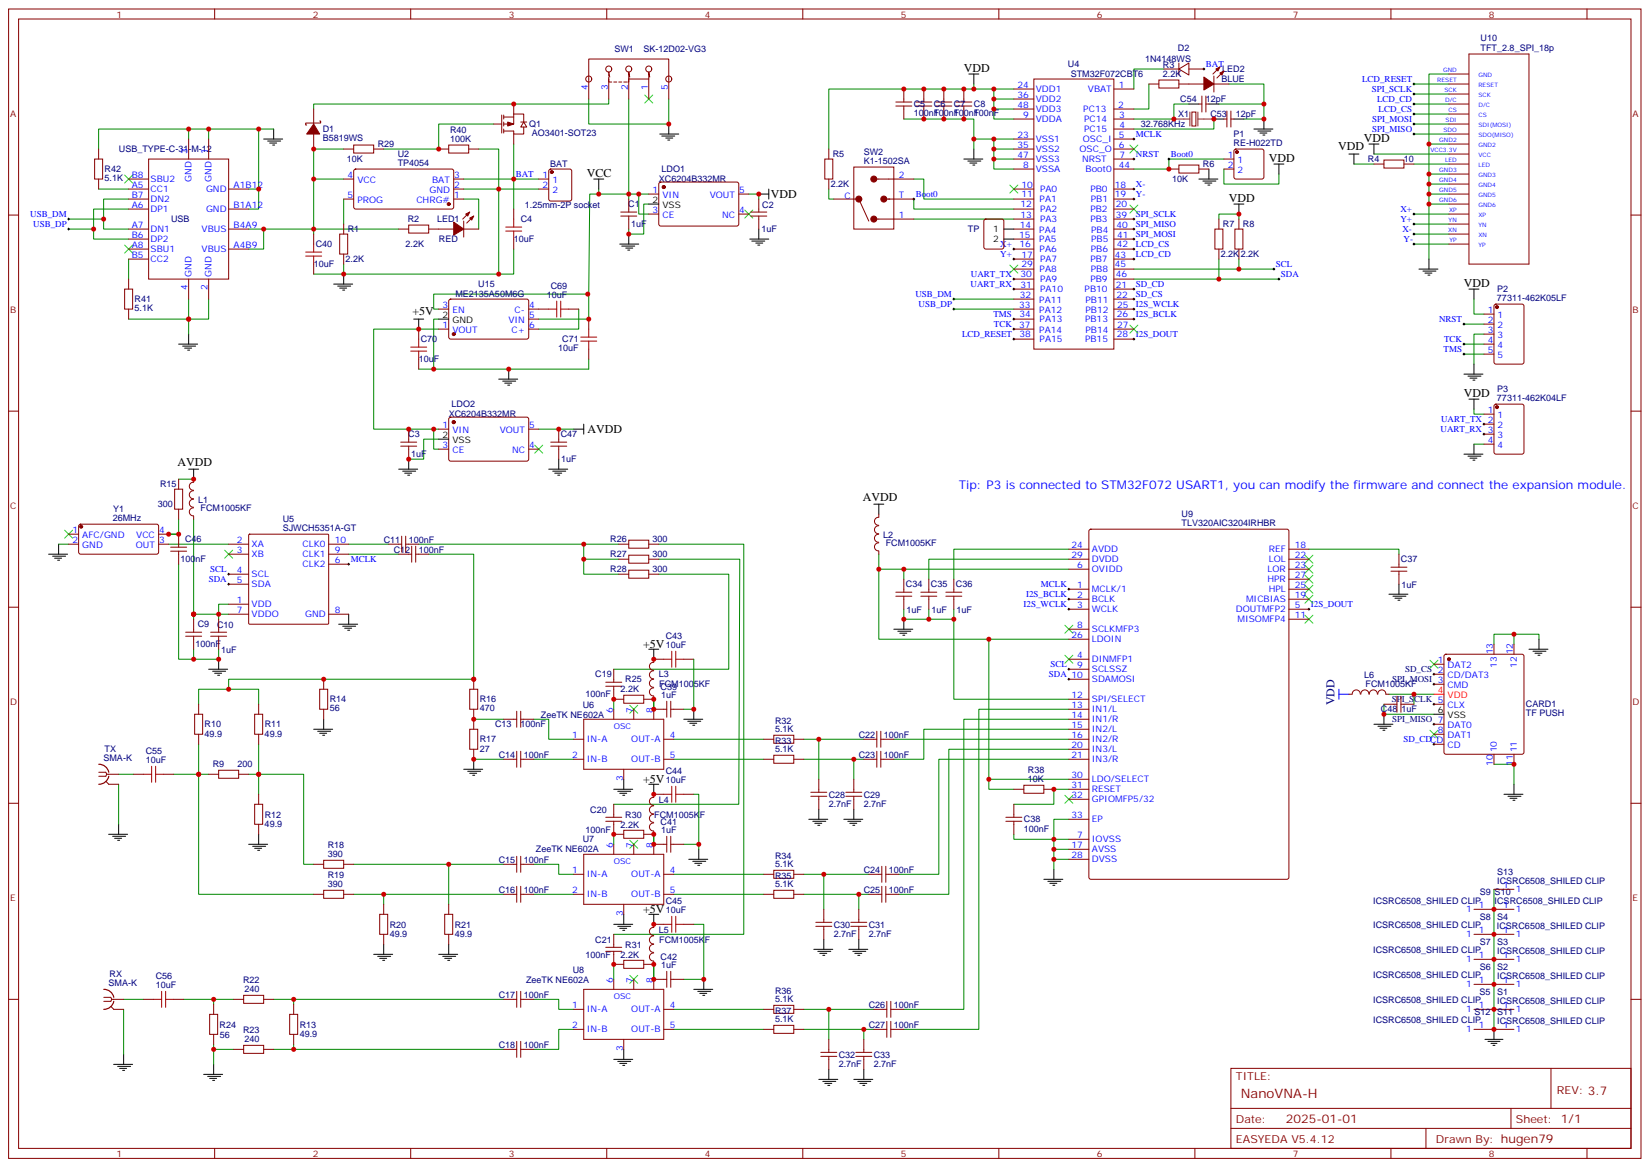
[picture p13: page 1]

Tip: P3 is connected to STM32F072 USART1, you can modify the firmware and connect the expansion module.
