hugen79/NanoVNA-H/doc/Schematic_NanoVNA-H4_REV4_4.pdf

# SPI_MISO VDD VDD

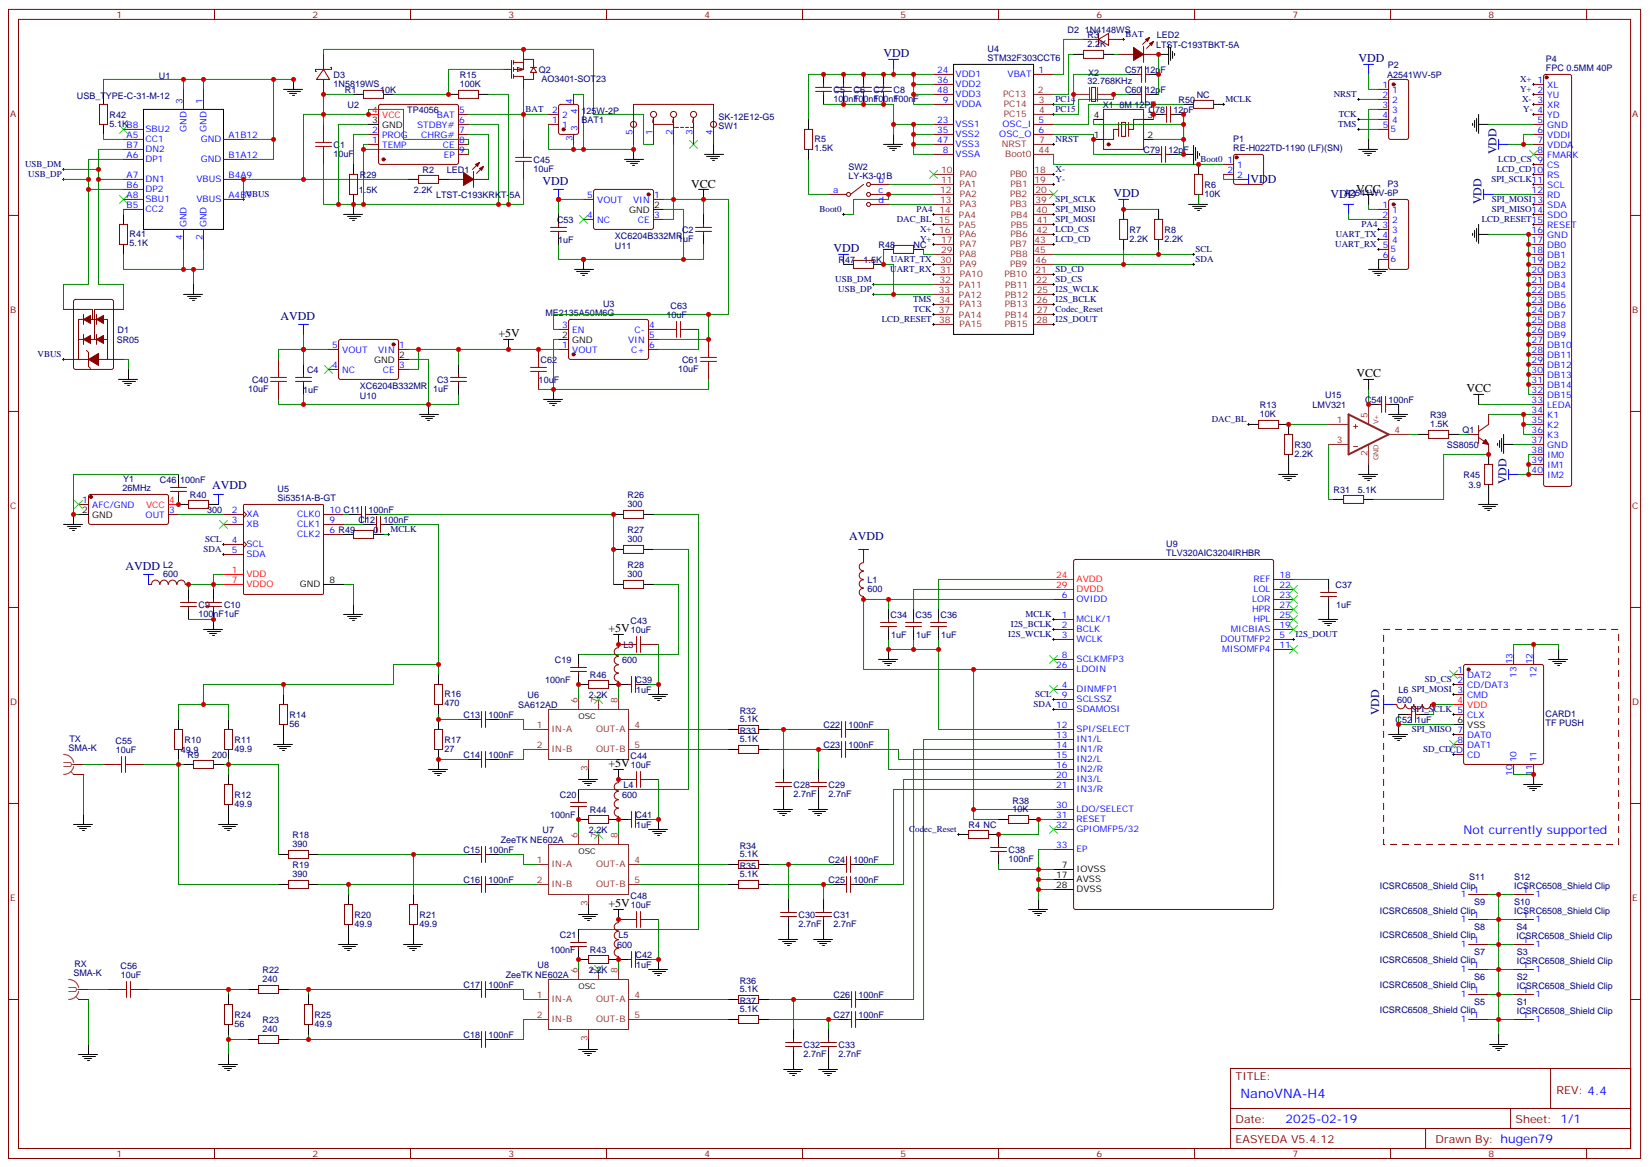
[picture p15: page 1]
