hugen79/NanoVNA-H/doc/Schematic_NanoVNA-H4_REV4_3.pdf

# SPI_MISO VDD VDD

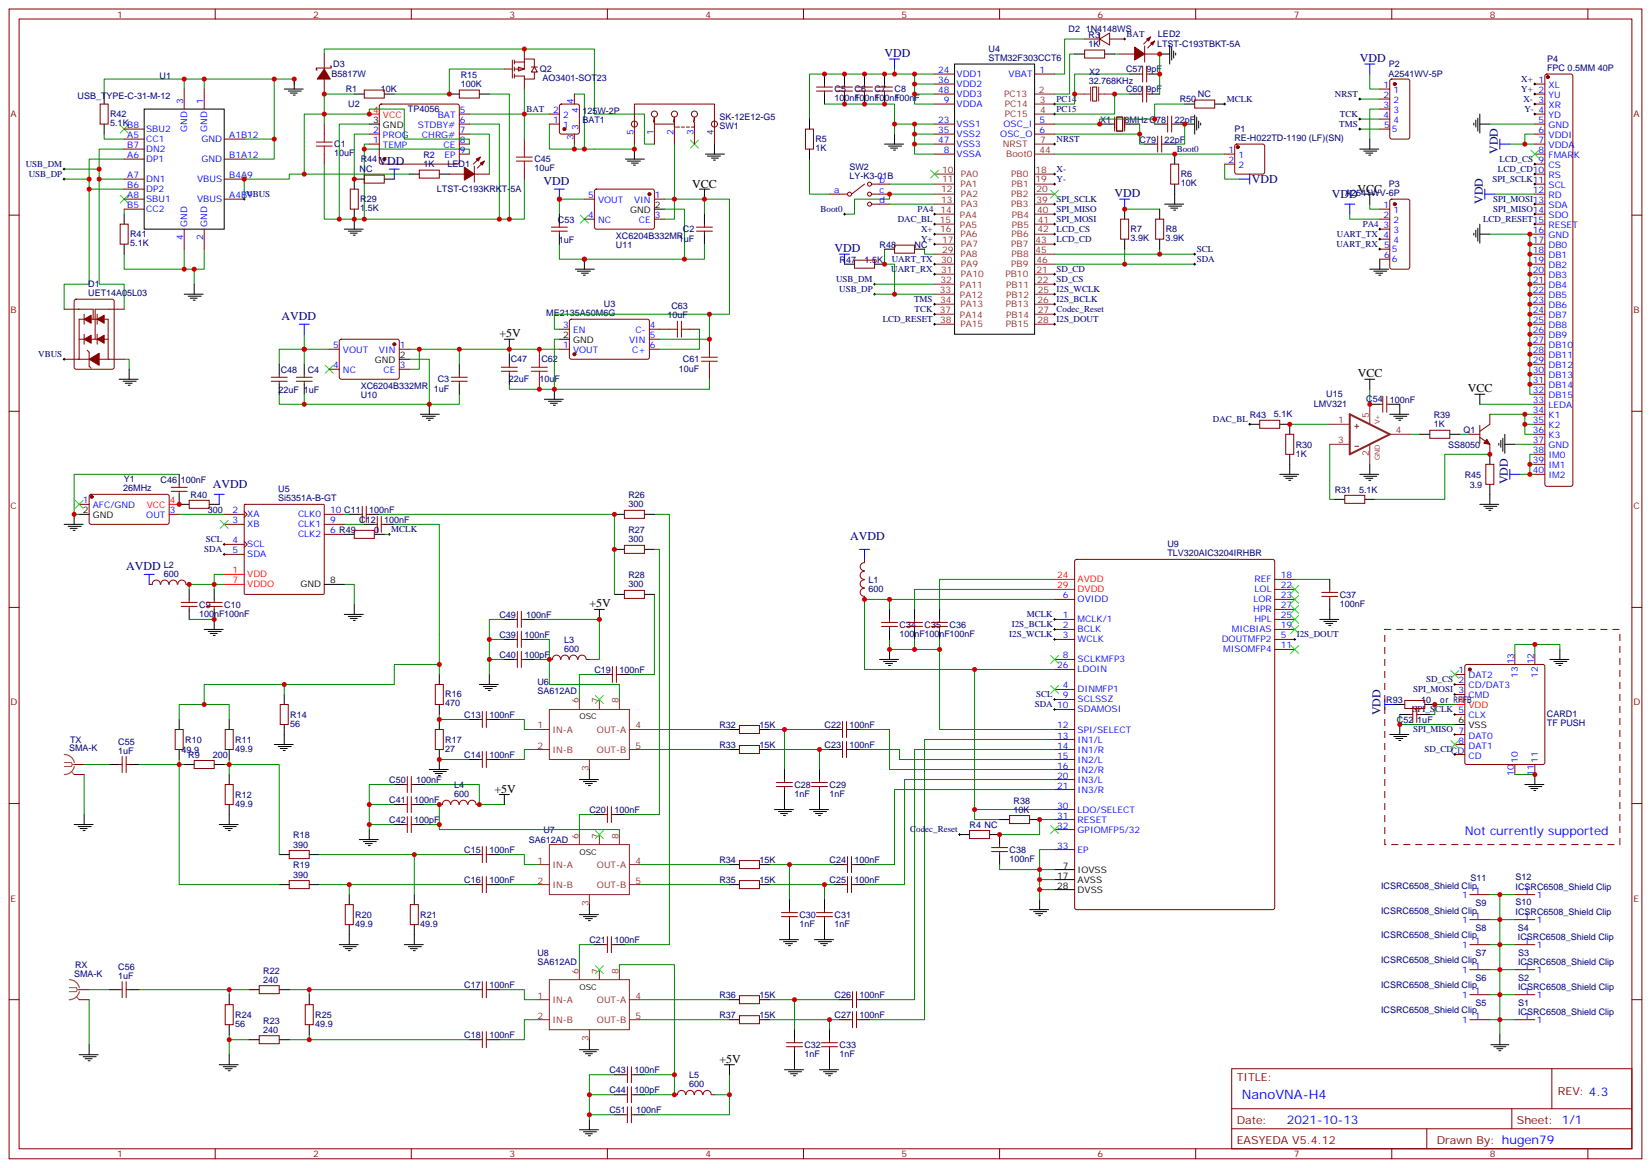
[picture p16: page 1]
