hugen79/NanoVNA-H/icons_marker.c

/*
 * Copyright (c) 2019-2020, Dmitry (DiSlord) dislordlive@gmail.com
 * All rights reserved.
 *
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
 * You should have received a copy of the GNU General Public License
 * along with GNU Radio; see the file COPYING.  If not, write to
 * the Free Software Foundation, Inc., 51 Franklin Street,
 * Boston, MA 02110-1301, USA.
 */

//****************************************************************
//                    Icons used in plot area
//****************************************************************

// Reference bitmap (size and offset)
#define REFERENCE_WIDTH    6
#define REFERENCE_HEIGHT   5
#define REFERENCE_X_OFFSET 5
#define REFERENCE_Y_OFFSET 2
static const uint8_t reference_bitmap[]={
  _BMP8(0b11000000),
  _BMP8(0b11110000),
  _BMP8(0b11111100),
  _BMP8(0b11110000),
  _BMP8(0b11000000),
};

// Marker bitmaps (size and offsets)
#if _USE_MARKER_SET_ == 0
#define MARKER_WIDTH       7
#define MARKER_HEIGHT     10
#define X_MARKER_OFFSET    3
#define Y_MARKER_OFFSET   10
#define MARKER_BITMAP(i)  (&marker_bitmap[(i)*MARKER_HEIGHT])
#define MARKER_RBITMAP(i)  (&marker_bitmap[(i)*2*MARKER_HEIGHT + MARKER_HEIGHT])
static const uint8_t marker_bitmap[]={
// Marker Back plate
  _BMP8(0b11111110),
  _BMP8(0b11111110),
  _BMP8(0b11111110),
  _BMP8(0b11111110),
  _BMP8(0b11111110),
  _BMP8(0b11111110),
  _BMP8(0b11111110),
  _BMP8(0b01111100),
  _BMP8(0b00111000),
  _BMP8(0b00010000),

  _BMP8(0b00010000),
  _BMP8(0b00111000),
  _BMP8(0b01111100),
  _BMP8(0b11111110),
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
  _BMP16(0b1011000001101000),
  _BMP16(0b1001111111001000),
  _BMP16(0b1011000001101000),
  _BMP16(0b1011000001101000),
  _BMP16(0b1011000001101000),
  _BMP16(0b1011000001101000),
  _BMP16(0b1001111111001000),
  _BMP16(0b1000000000001000),
  _BMP16(0b1111111111111000),
#endif
};
#endif
