hugen79/NanoVNA-H/chprintf.c

/*
    ChibiOS - Copyright (C) 2006..2016 Giovanni Di Sirio

    Licensed under the Apache License, Version 2.0 (the "License");
    you may not use this file except in compliance with the License.
    You may obtain a copy of the License at

        http://www.apache.org/licenses/LICENSE-2.0

    Unless required by applicable law or agreed to in writing, software
    distributed under the License is distributed on an "AS IS" BASIS,
    WITHOUT WARRANTIES OR CONDITIONS OF ANY KIND, either express or implied.
    See the License for the specific language governing permissions and
    limitations under the License.
*/

/*
   Concepts and parts of this file have been contributed by Fabio Utzig,
   chvprintf() added by Brent Roman.
 */

/**
 * @file    chprintf.c
 * @brief   Mini printf-like functionality.
 *
 * @addtogroup chprintf
 * @{
 */

#include "hal.h"
#include "nanovna.h"
#include "chprintf.h"
#include <math.h>

// Enable [flags], support:
// ' ' Prepends a space for positive signed-numeric types. positive = ' ', negative = '-'. This flag is ignored if the + flag exists.
#define CHPRINTF_USE_SPACE_FLAG
// for %q format use uint32_t or uint64_t
//#define CHPRINTF_FREQUENCY_SIZE_64
// allow use int64_t values for %D %U %O %X or %ld %lu %lo %lx type
//#define CHPRINTF_USE_INT_64

// Force putting trailing zeros on float value (for %0.f format)
#define CHPRINTF_FORCE_TRAILING_ZEROS

// Maximum digits for values 11.11 + 1 for float, int64 need 21 digit (use MAX_FILLER * 2 + 1)
#define MAX_FILLER             11
#define FLOAT_PRECISION         9
#define FLOAT_PREFIX_PRECISION  3

#ifdef CHPRINTF_FREQUENCY_SIZE_64
typedef uint64_t pfreq_t;
#else
typedef uint32_t pfreq_t;
#endif

#ifdef CHPRINTF_USE_INT_64
typedef uint64_t ulongval_t;
typedef int64_t longval_t;
#else
typedef uint32_t ulongval_t;
typedef int32_t longval_t;
#endif

#pragma pack(push, 2)

static const uint32_t pow10[FLOAT_PRECISION+1] = {
    1, 10, 100, 1000, 10000, 100000, 1000000, 10000000, 100000000, 1000000000
};
// Prefixes for values bigger then 1000.0
//                                 1  1e3, 1e6, 1e9, 1e12, 1e15, 1e18, 1e21, 1e24
static const char bigPrefix[] = {' ', 'k', 'M', 'G',  'T',  'P',  'E',  'Z',  'Y', 0};
// Prefixes for values less   then 1.0
//                                 1e-3,    1e-6, 1e-9, 1e-12, 1e-15, 1e-18, 1e-21, 1e-24
static const char smallPrefix[] = { 'm', S_MICRO,  'n',   'p',   'f',   'a',   'z',   'y', 0};

#pragma pack(pop)

static char *long_to_string_with_divisor(char *p,
                                         longval_t num,
                                         uint32_t radix,
                                         int      precision) {
  char *q = p + MAX_FILLER;
  char *b = q;
  // convert to string from end buffer to begin
  do {
    uint8_t c = num % radix;
    num /= radix;
    *--q = c + ((c > 9) ? ('A'-10) : '0');
  }while((precision && --precision) || num);
  // copy string at begin
  int i = (int)(b - q);
  do
    *p++ = *q++;
  while (--i);
  return p;
}

// default frequency prescision = 14
// gg.mmm kkk hhh
#define MAX_FREQ_PRESCISION 14
#define FREQ_PSET            1
#define FREQ_PREFIX_SPACE    2

static char *
ulong_freq(char *p, pfreq_t freq, int precision)
{
  uint8_t flag = FREQ_PSET;
  if (precision == 0)
    flag|=FREQ_PREFIX_SPACE;
  if (precision == 0 || precision > MAX_FREQ_PRESCISION)
    precision = MAX_FREQ_PRESCISION;
  char *q = p + MAX_FREQ_PRESCISION;
  char *b = q;
  // Prefix counter
  uint32_t s = 0;
  // Set format (every 3 digits add ' ' up to GHz)
  uint32_t format = 0b100100100100100;
  do {
#ifdef ARM_MATH_CM4
    uint32_t c = freq % 10;
    freq/= 10;
#else
    // Fast and compact division uint32_t on 10, using shifts, result:
    // c = freq % 10
    // freq = freq / 10;
    pfreq_t c = freq;
    freq >>= 1;
    freq += freq >> 1;
    freq += freq >> 4;
    freq += freq >> 8;
    freq += freq >> 16;  // freq = 858993459*freq/1073741824 = freq *
                         // 0,799999999813735485076904296875
    freq >>= 3;          // freq/=8; freq = freq * 0,09999999997671693563461303710938
    c -= freq * 10;      // freq*10 = (freq*4+freq)*2 = ((freq<<2)+freq)<<1
    while (c >= 10) {
      freq++;
      c -= 10;
    }
#endif
    *--q = c + '0';
    if (freq == 0) break;
    // Add spaces, calculate prefix
    if (format & 1) {
      *--q = ' ';
      s++;
    }
    format >>= 1;
  } while (1);
  s = bigPrefix[s];

  // Get string size
  int i = (b - q);
  // copy string
  // Replace first ' ' by '.'
  do {
    char c = *q++;
    // replace first ' ' on '.'
    if (c == ' ') {
      if (flag & FREQ_PSET) {
        c = '.';
        flag &= ~FREQ_PSET;
      } else if (!(flag & FREQ_PREFIX_SPACE))
        c = *q++;
    }
    if (!(flag & FREQ_PSET) && precision-- < 0) break;
    *p++ = c;
  } while (--i);
  // Put pref (and space before it if need)
  if ((flag & FREQ_PREFIX_SPACE) && s != ' ')
    *p++ = ' ';
  *p++ = s;
  return p;
}

#if CHPRINTF_USE_FLOAT
static char *ftoa(char *p, float num, int precision) {
  // Check precision limit
  if (precision > FLOAT_PRECISION)
    precision = FLOAT_PRECISION;
  uint32_t multi = pow10[precision];
  uint32_t l = num;
  // Round value
  uint32_t k = ((num-l)*multi+0.5);
  // Fix rounding error if get
  if (k>=multi){k-=multi;l++;}
  p = long_to_string_with_divisor(p, l, 10, 0);
  if (precision) {
    *p++ = DIGIT_SEPARATOR;
    p=long_to_string_with_divisor(p, k, 10, precision);
  }
  return p;
}

static char *ftoaS(char *p, float num, int16_t precision) {
  char prefix=0;
  const char *ptr;
  if (num >= 1000.0f){
    for (ptr = bigPrefix+1; *ptr && num >= 1000.0f; num/=1000.0f, ptr++)
      ;
    prefix = ptr[-1];
  }
  else if (num < 1.0f){
    for (ptr = smallPrefix; *ptr && num < 1.0f; num*=1000.0f, ptr++)
      ;
    prefix = num > 1e-3 ? ptr[-1] : 0;
  }
  if (prefix)
    precision--;

  // Auto set precision in place of value
  uint32_t l = num;
  if (l >= 100)
    precision-=2;
  else if (l >= 10)
    precision-=1;
  if (precision < 0)
    precision=0;
  p=ftoa(p, num, precision);
  // remove zeros at end
  if (precision){
    while (p[-1]=='0') p--;
    if (p[-1]==DIGIT_SEPARATOR) p--;
  }
  if (prefix)
    *p++ = prefix;
  return p;
}
#endif

/**
 * @brief   System formatted output function.
 * @details This function implements a minimal @p vprintf()-like functionality
 *          with output on a @p BaseSequentialStream.
 *          The general parameters format is: %[flags][width|*][.precision|*][l|L]p.
 *          The following parameter types (p) are supported:
 *          - <b>x</b> hexadecimal int32.
 *          - <b>X</b> hexadecimal int64.
 *          - <b>o</b> octal int32.
 *          - <b>O</b> octal int64.
 *          - <b>d</b> decimal signed int32.
 *          - <b>D</b> decimal signed int64.
 *          - <b>u</b> decimal unsigned int32.
 *          - <b>U</b> decimal unsigned int64.
 *          - <b>c</b> char.
 *          - <b>s</b> string.
 *          - <b>f</b> float.
 *          - <b>F</b> float (use prefix formatting)
 *          - <b>q</b> uint32 or uint64 frequency formatting (depend from defined or not CHPRINTF_FREQUENCY_SIZE_64).
 *
 * @param[in] chp       pointer to a @p BaseSequentialStream implementing object
 * @param[in] fmt       formatting string
 * @param[in] ap        list of parameters
 * @return              The number of bytes that would have been
 *                      written to @p chp if no stream error occurs
 *
 * @api
 */
#define IS_LONG             0x0001
#define LEFT_ALIGN          0x0002
#define POSITIVE            0x0004
#define NEGATIVE            0x0008
#define PAD_ZERO            0x0010
#define PLUS_SPACE          0x0020
#define DEFAULT_PRESCISION  0x0040
#define COMPLEX             0x0080
#define SHORT_FLOAT         0x0100

int chvprintf(BaseSequentialStream *chp, const char *fmt, va_list ap) {
  char *p, *s, c, filler=' ';
  int precision, width;
  int n = 0;
  uint32_t  state;
  union {
    ulongval_t  u;
    longval_t   l;
    float       f;
  }value;
#if CHPRINTF_USE_FLOAT
  char tmpbuf[2*MAX_FILLER + 1];
#else
  char tmpbuf[MAX_FREQ_PRESCISION + 1];
#endif

  while (true) {
    c = *fmt++;
    if (c == 0)
      return n;
    if (c != '%') {
      streamPut(chp, (uint8_t)c);
      n++;
      continue;
    }
    // Parse %[flags][width|*][.precision|*]
    p = tmpbuf;
    s = tmpbuf;
    state = 0;
    width = 0;
    precision = 0;

    // Get [flags], support:
    // '-' Left-align the output of this placeholder. (The default is to right-align the output.)
    // '+' Prepends a  plus for positive signed-numeric types. positive = '+', negative = '-'.
    // ' ' Prepends a space for positive signed-numeric types. positive = ' ', negative = '-'. This flag is ignored if the + flag exists.
    // '0' When the 'width' option is specified, prepends zeros for numeric types. (The default prepends spaces.)
    // 'j' Then add 'j' before '+' or '-', need for complex values.
    while (true){
      if (*fmt == '-')
        state|=LEFT_ALIGN;
      else if (*fmt == '+')
        state|=POSITIVE;
      else if (*fmt == '0')
        state|=PAD_ZERO;
      else if (*fmt == 'j')
        state|=COMPLEX;
#ifdef CHPRINTF_USE_SPACE_FLAG
      else if (*fmt == ' ')
        state|=PLUS_SPACE;
#endif
      else if (*fmt == 'b')
        state|=SHORT_FLOAT;
      else
        break;
      fmt++;
    }
    // Get [width|*] - The Width field specifies a minimum number of characters to output
    // if set *, get width as argument
    while (true) {
      c = *fmt++;
      if (c >= '0' && c <= '9')
        c -= '0';
      else if (c == '*')
        c = va_arg(ap, int);
      else
        break;
      width = width * 10 + c;
    }
    // Get [.precision|*]
    // if set *, get precision as argument
    if (c == '.') {
      while (true) {
        c = *fmt++;
        if (c >= '0' && c <= '9')
          c -= '0';
        else if (c == '*')
          c = va_arg(ap, int);
        else
          break;
        precision = precision * 10 + c;
      }
    }
    else
      state|=DEFAULT_PRESCISION;
    // Get type (or skip [l|L] for int64_t) support
#ifdef CHPRINTF_USE_INT_64
    if (c == 'l' || c == 'L') {
      state|=IS_LONG;
      if (*fmt)
        c = *fmt++;
    }
    else if ((c >= 'A') && (c <= 'Z'))
      state|=IS_LONG;
#endif
    // Parse type
    switch (c) {
    case 'c':
      state&=~PAD_ZERO;
      *p++ = va_arg(ap, int);
      break;
    case 's':
      state&=~PAD_ZERO;
      if ((s = va_arg(ap, char *)) == 0)
        s = (char*)"(null)";
      if (state&DEFAULT_PRESCISION)
        precision = 32767;
      for (p = s; *p && (--precision >= 0); p++)
        ;
      break;
    case 'D':
    case 'd':
    case 'I':
    case 'i':
#ifdef CHPRINTF_USE_INT_64
      if (state & IS_LONG)
        value.l = va_arg(ap, int64_t);
      else
#endif
        value.l = va_arg(ap, int32_t);
      if (value.l < 0) {
        state|=NEGATIVE;
        *p++ = '-';
        value.l = -value.l;
      }
      else if (state & POSITIVE)
        *p++ = '+';
#ifdef CHPRINTF_USE_SPACE_FLAG
      else if (state & PLUS_SPACE)
        *p++ = ' ';
#endif
      if (state & COMPLEX)
        *p++ = 'j';
      p = long_to_string_with_divisor(p, value.l, 10, 0);
      break;
    case 'q':
      p=ulong_freq(p, va_arg(ap, pfreq_t), precision);
      break;
#if CHPRINTF_USE_FLOAT
    case 'F':
    case 'f':
      if (state & SHORT_FLOAT)
        value.u = va_arg(ap, uint32_t);
      else
        value.f = va_arg(ap, double);
      if (value.f < 0) {
        state|=NEGATIVE;
        *p++ = '-';
        value.f = -value.f;
      }
      else if (state & POSITIVE)
        *p++ = '+';
#ifdef CHPRINTF_USE_SPACE_FLAG
      else if (state & PLUS_SPACE)
        *p++ = ' ';
#endif
      if (state & COMPLEX)
        *p++ = 'j';
      if (value.f == INFINITY){
        *p++ = 0x19; *p++ = ' ';
        break;
      }
      // Set default precision
      if (state&DEFAULT_PRESCISION)
        precision = (c=='F') ? FLOAT_PREFIX_PRECISION : FLOAT_PRECISION;
      p = (c=='F') ? ftoaS(p, value.f, precision) : ftoa(p, value.f, precision);
#ifdef CHPRINTF_FORCE_TRAILING_ZEROS
      if (state & PAD_ZERO) { // remove zeros at end
        state^= PAD_ZERO;
        while (p[-1]=='0') p--;
        if (p[-1]=='.') p--;
      }
#endif
      break;
#endif
    case 'X':
    case 'x':
      c = 16;
      goto unsigned_common;
    case 'U':
    case 'u':
      c = 10;
      goto unsigned_common;
    case 'O':
    case 'o':
      c = 8;
unsigned_common:
#ifdef CHPRINTF_USE_INT_64
      if (state & IS_LONG)
        value.u = va_arg(ap, int64_t);
      else
#endif
        value.u = va_arg(ap, uint32_t);
      p = long_to_string_with_divisor(p, value.u, c, 0);
      break;
    default:
      *p++ = c;
      break;
    }
    // Now need print buffer s[{sign}XXXXXXXXXXXX]p and align it on width
    // Check filler width (if buffer less then width) and prepare filler if need fill
    if ((width -=(int)(p - s)) < 0)
      width = 0;
    else
      filler = (state&PAD_ZERO) ? '0' : ' ';
    // if left align, put sign digit, and fill
    // [{sign}ffffffXXXXXXXXXXXX]
    if (!(state&LEFT_ALIGN)) {
      // Put '+' or '-' or ' ' first if need
      if ((state&(NEGATIVE|POSITIVE|PLUS_SPACE)) && (state&PAD_ZERO)) {
        streamPut(chp, (uint8_t)*s++);
        n++;
      }
      // fill from left
      while (width){
        streamPut(chp, (uint8_t)filler);
        n++;
        width--;
      }
    }
    // put data
    while (s < p) {
      streamPut(chp, (uint8_t)*s++);
      n++;
    }
    // Put filler from right (if need)
    while (width) {
      streamPut(chp, (uint8_t)filler);
      n++;
      width--;
    }
  }
}

/**
 * @brief   System formatted output function.
 * @details This function implements a minimal @p printf() like functionality
 *          with output on a @p BaseSequentialStream.
 *          The general parameters format is: %[-][width|*][.precision|*][l|L]p.
 *          The following parameter types (p) are supported:
 *          - <b>x</b> hexadecimal integer.
 *          - <b>X</b> hexadecimal long.
 *          - <b>o</b> octal integer.
 *          - <b>O</b> octal long.
 *          - <b>d</b> decimal signed integer.
 *          - <b>D</b> decimal signed long.
 *          - <b>u</b> decimal unsigned integer.
 *          - <b>U</b> decimal unsigned long.
 *          - <b>c</b> character.
 *          - <b>s</b> string.
 *          .
 *
 * @param[in] chp       pointer to a @p BaseSequentialStream implementing object
 * @param[in] fmt       formatting string
 *
 * @api
 */
#if 0
int chprintf(BaseSequentialStream *chp, const char *fmt, ...) {
  va_list ap;
  int formatted_bytes;

  va_start(ap, fmt);
  formatted_bytes = chvprintf(chp, fmt, ap);
  va_end(ap);

  return formatted_bytes;
}
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
