hugen79/NanoVNA-H/(commit log)

2019-04-17 优化扫描增益
2019-04-18 增加开机显示NanoVNA字样
2019-04-19 提供一个1.3G版本，编译900M版本使用make FRE=900，编译1.3G版本，使用make FRE=1300
2019-04-23 修正修改开机logo显示后不显示cal状态的问题
2019-04-23 修正不能正确显示开机频率问题
2019-04-24 修正zr计算错误的问题，现在Smith图上mark点的阻抗显示为|Z|的值。
2019-04-24 由于900M固件需要在扫描的时候动态调整功率和增益的，屏蔽掉shell下手动设置功率和增益的命令
2019-04-25 1.Smith图上mark点的阻抗显示阻zr的值即Resistance，抗Reactance部分经过技术后显示为对应的容性（Capacitive）或者感性（Inductive）的电容值或者电感值， 2.优化900M固件300M以上频率si5351的驱动。
2019-04-29 删除一些示例
    [stm_spc56ec74a256s_spc56ec74_minimodule_debug_jtag.cfg, stm_xpc560b64_minimodule_debug_jtag.cfg, stm_xpc560b_spc560d40_minimodule_debug_jtag.cfg, stm_xpc560p_minimodule_40mhz_debug_jtag.cfg, stm_xpc563m64_minimodule_debug_jtag.cfg, stm_xpc564a_spc564a70_minimodule_debug_jtag.cfg, stm_xpc56el_minimodule_lockstep_debug_jtag.cfg]
2019-06-12 1.修正使用shell命令（PC软件）recall出来的数据被错误插值的问题； 2.通过（S21）校准不使用源匹配数据(之前原软件使用源匹配数据的校准总是有误差，这样貌似没有误差了，但是还不清楚是否会有其他问题，请大家测试后给我反馈)。
2019-07-05 增加800M固件
2019-07-21 同步edy555的最新代码
2019-07-22 1.SI5351切换分频器后延迟6ms，保证正常锁定； 2.修改PGA增益，这样看起来使用谐波和没使用谐波的曲线更平滑，应该可以减小谐波切换点的误差。
2019-07-26 修改readme
2019-07-26 增加原理图和使用说明
2019-08-02 1.adc校准前先等待ADC_CR_ADEN位清空； 2.修复退格键不会清空显示的问题。
2019-08-14 1.谐波扩展及PGA调整的方法于edy555的最新代码一致，但si5351使用谐波的时候仍单独分段处理，这样可以使用si5351内vco工作的最低频率不低于手册上的频率，虽然si5351的vco可以工作在更低的频率，但是还是使用尽可能让它工作在手册标称的范围内； 2.尝试同步edy555的最新代码中开启AIC3204的AD滤波器的内容，但发现打开滤波器后AD数据会有3ms的延迟，这样扫描101点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
2019-08-15 Update main.c
    按edy555的建议增加版权和许可证信息！
2019-08-15 Update README.md
    不再提供编译300MHz版本
2019-08-16 1.重命名成NanoVNA-H； 2.开机显示版本信息，版权信息，编译时间。
2019-08-16 前面提交错误，重新提交
2019-09-05 修改原理图，增加USB type-C CC识别电阻。
2019-09-20 同步edy555最新代码，包含TDR功能，包含电池显示（之前发货版本D2未安装，电池显示需要自行安装二极管），包含截图功能……
    硬件稍微修改下IF滤波器，以便更好的利用谐波测量（滤波器仿真貌似有一点点作用，实际效果貌似并不明显）。
    [NanoVNA_DAP.cfg]
2019-09-20 添加gnu-mcu-eclipse链接
2019-09-20 1.由于mcu vbat口高阻，肖特基二极管的压降可以忽略，修改电压adc； 2.ChibiOS改成子程序，可以同步，不需要手动复制了。
2019-09-22 尝试同步cho45的代码1120d5c
2019-10-02 同步edy554代码，好像使用电池的时候性能会下降，待解决。
2019-10-03 合并ANTENNA_ANALYZER(AA)版本。 Merged ANTENNA ANALYZER(AA 7x13 bitmap font)version.
2019-10-08 1.同步edy555最新代码，由于已经可以使用命令设置谐波切换点来，不再编译800MHz版本； 2.由于谐波切换点可变，修改si5351与edy555一致。 3.AA版本减少一组校准数据保存空间，多出的6K Flash用于存放大字体。
2019-10-09 1.同步edy555代码 2.AA版本显示细节优化
2019-10-18 1.同步edy555最新版本，但没有禁用函数内联，因此flash空间不够，Version界面少显示点内容，TDR模式显示两个Mark点功能未同步，以节省flash，这可能使用内联优化的最后一个版本了，禁用函数内联后刷屏速度会明显变慢； 2.修正AA版本clear_flash清空长度不对的问题； 3.重新编译后可以正常连接cho45 web interface了，但是我也不清楚问题出在哪里，可能是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
    [flash.c, main.c, plot.c, ui.c]
2019-10-21 1.新的外壳已经做好，现在可以购买新的带外壳的NanoVNA-H了； 2.原理图还原20190902版本，以便探索12KHz IF的可能性。
2019-11-14 使用了qrp73的nanoVNA-Q的代码，si5351和aic3204的驱动更合理，通过判断si5351锁定转态比简单的设定一个延迟更加合理，可以有效的避免因为si5351未稳定造成的噪音。 与QRP73和edy555的编译优化不同，没有禁用内联优化，刷新效率更好。由于flash空间有限DUMP，SCANRAW，COLOR命令不可用。
2019-11-14 修改dfu地址为gcc格式； 屏蔽数字输入模式右下角小键盘图标，避免ui转态错误。
2019-11-14 AA版本字符位置修正。
2019-11-15 使用拨轮开关操作，如果下一个菜单项为空则关闭菜单。
2019-11-25 1.linear格式绝对值显示；The absolute value of the linear format is displayed; 2.si5351默认8mA输出；Si5351 default 8mA output; 3.AA版本显示4条迹线。The AA version shows 4 traces.
2019-12-15 测试启用链接时优化（LTO），ADC中断暂时有问题
2019-12-18 1.Upload hardware NanoVNA-H Rev3.4 schematic diagram; 2.Since D2 in version 3.4 uses IN4148, the value of vbat_offset is changed to 480mV, which can be modified using the vbat_offset command. 3.Modif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
    [main.c, si5351.c, tlv320aic3204.c]
2019-12-24 1.readjusted the gain table for NanoVNA-H rev3.4 and it looks better; 2.Upload NanoVNA-H rev3.4 PCB Photo.
2019-12-29 1.Fixed the situation where si5351 switching band0 from band2 may lose the lock.
    [si5351.c]
2020-01-06 Disable the dac and time commands that are not used on the NanoVNA-H. Modify the DIV/4 switchpoint of the si5351 back to 150MHz
2020-01-08 Fixed incorrect drawing after displaying absolute value in linear format.
    [plot.c]
2020-04-24 Update the schematic diagram, the impedance of ch1 is closer to pure 50 ohms.
2020-09-26 Add comments explaining correction factors
    Binaries remain unchanged.
    [main.c]
2021-01-16 Add the rev3.5.1 version of the schematic diagram, use a charge pump to supply power, and use an ultra-low noise LDO. The microSD card and 32.768KHz crystal position are reserved, and the user can in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
2021-01-28 Modified based on DiSlord version 1.0.45 firmware. I uses a larger font similar to tinySA to display the menu and Marker point information, so the AA version is no longer provided.The default si5351 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
    [board.c, board.h, chconf.h, chprintf.c, dsp.c, dsp.h, flash.c, halconf.h]
2021-01-30 Fix some display errors.
    [lc_matching.c, nanovna.h, ui.c]
2021-01-30 Fix the display of lc match.
    [lc_matching.c]
2021-09-16 Based on the source code of DiSlord version 1.0.69, merge the source code of NanoVNA-H and NanoVNA-H4, which can be specified by TARGET when compiling. NanoVNA-H uses larger fonts, the display layout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
    NanoVNA-H hardware updated to Rev3.6, SD card added current limiting resistor, thanks to DiSlord's suggestion.
    Translated with www.DeepL.com/Translator (free version)
    [NanoVNA_DAP.cfg]
2021-10-08 Synchronize DiSlord's 1.0.70 code. Completing the NanoVNA-H4 files, now you can compile the NanoVNA-H4 firmware directly using the master branch.
    [stlink.cfg, stm32f0discovery.cfg, stm32f3discovery.cfg]
2021-11-21 Synchronize DiSlord1.0.71 version, Now you can set the time through the "Expert Setting" menu. Both the newly sold NanoVNA-H Rev3.6 and NanoVNA-H4 Rev4.3 have installed a 36.768kHz crystal, and the L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
    [lc_matching.c, main.c, nanovna.h, numfont20x22.c, plot.c, si5351.c, si5351.h, ui.c]
2021-12-29 Synchronize DiSlord's version 1.1.01 code, including admittance display and remote screen. The use of MS5351 as a replacement for Si5351 is officially supported from this release. It can be modified 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
    [chprintf.c, ili9341.c, lc_matching.c, main.c, nanovna.h, plot.c, si5351.c, ui.c]
2022-08-14 Remove R44 from NanoVNA-H4 Rev4.3, this resistor may damage U2 and the battery if the NanoVNA-H4 is not used for a long time and the battery is too low.
2022-08-31 Adjust the switching frequency of MS5351 VCO, not all MS5351 VCO can be locked to 1200MHz. after adjustment need MS5351 VCO can lock the range of 470MHz-1176MHz, there may still be edge frequency can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
2024-02-20 1. Synchronize the source code to DiSlord version 1.2.27, please refer to DiSlord's NanoVNA-D project for software function update. ; 2. Add ST7789 support for 2.8-inch version display; 3. uploaded v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
2025-02-19 1. Firmware synchronization 1.2.43 2. Due to the discontinuation of NXP SA612A, we started to produce compatible chip ZeeTK NE602A, but due to the different chip manufacturing process, there is a sli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
