hugen79/NanoVNA-H/(notices)

Notices in the files:
icons_marker.c:
This is free software; you can redistribute it and/or modify
it under the terms of the GNU General Public License as published by
the Free Software Foundation; either version 3, or (at your option)
